lbregy/Power-Electronics/02 - Transformer/Reports/EE_365_Report_2_2025_2026.pdf

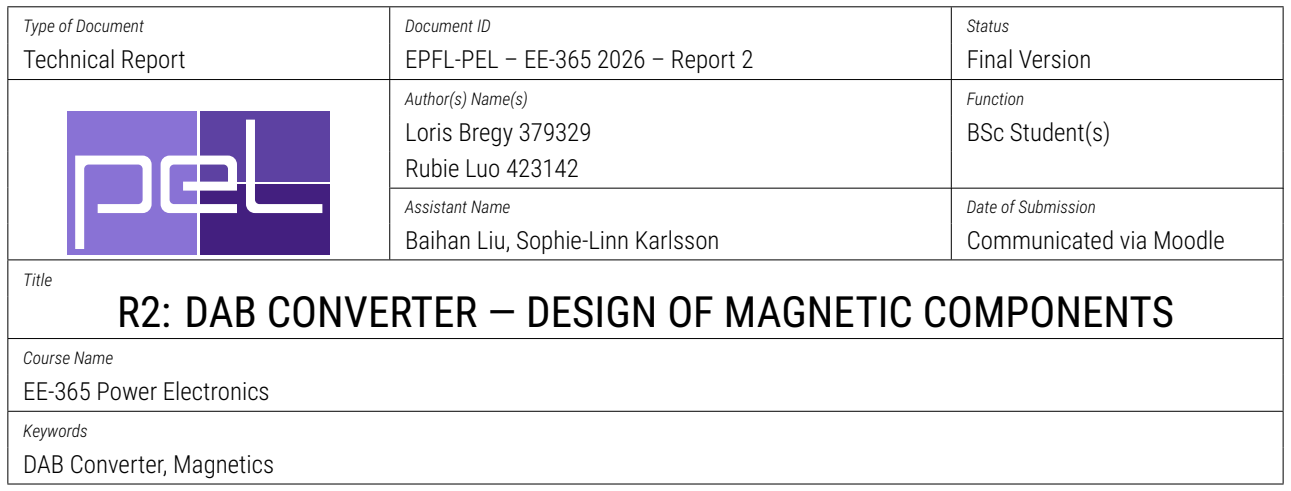
[picture p4: figure]
Title; Course Name EE-365 Power Electronics; Keywords DAB Converter, Magnetics

Type of Document Technical Report | Document ID EPFL-PEL – EE-365 2026 – Report 2 | Status Final Version
| Author(s) Name(s) Loris Bregy 379329 Rubie Luo 423142 | Function BSc Student(s)
| Assistant Name Baihan Liu, Sophie-Linn Karlsson | Date of Submission Communicated via Moodle

# R2: DAB CONVERTER — DESIGN OF MAGNETIC COMPONENTS

## TABLE OF CONTENTS

Transformer – Design Specifications and Constraints | 3
Transformer – Core Selection with Kg Method | 7
Transformer – Wire Selection | 10
Transformer – Evaluation of Losses | 13
Transformer – Design Summary | 15

Transformer – Building Procedure | 16
Transformer – Prototype Measurement | 18
Inductor Design | 21

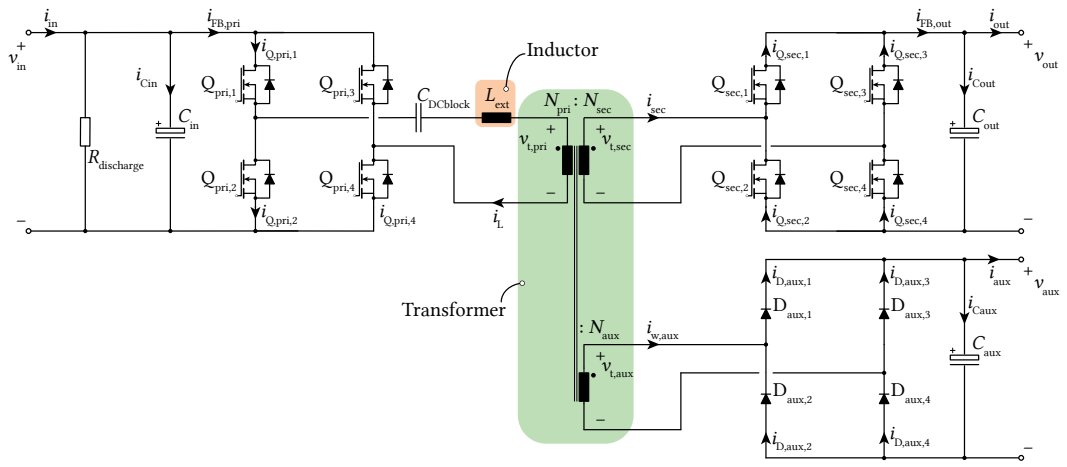
[picture p5: figure]
Qpri,1; Qpri,2; Qpri,3; Qpri,4; Cin; Rdischarge; Lext; i Q,pri,1; Q,pri,2; Q,pri,4; Qsec,1; Qsec,2; Qsec,3; Qsec,4; Q,sec,1; Q,sec,3; Q,sec,2; Q,sec,4; sec; Cout; i out; CDCblock; + vin; + vout; + vt,sec; + vt,pri; + vt,aux; Caux; + vaux; Npri : Nsec; : Naux; Daux,1; Daux,2; Daux,3; Daux,4; D,aux,1; D,aux,3; D,aux,2; D,aux,4; Cout i Cin; i w,aux; i aux; i Caux; FB,pri; FB,out; Transformer; Inductor

Figure 1 Schematics of the DAB converter for this report, highlighting the separation of the transformer and the inductor that will be designed separately in this report. Compared to Report 1, a winding of Naux is also added to power the auxiliary circuits at the secondary side. More details about these aspects will come in the next reports.

## TRANSFORMER – DESIGN SPECIFICATIONS AND CONSTRAINTS

The second part of the project deals with the design and realization of the magnetic components (i.e., the transformer and the inductor) of the DAB converter, according to the specifications and requirements from Report 1. The schematic to be considered for this report is shown in Figure 1. Fill out Table 1 with the parameters assigned to your group and calculated in the previous Report.

One of the most important choices for the design of inductors and transformers is the selection of the material for the magnetic core. For all the groups in this class, the operating frequency of the converter are above 10 kHz. For such frequencies, materials known as ferrites are typically employed, while other materials are available for lower operating frequencies. Here, only the N87 ferrite material from TDK (datasheet pdf) (https://www.tdk-electronics.tdk.com/download/528882/990c299b916e9f3eb7e44ad563b7f0b9/pdf-n87.pdf) is considered.

Another important guideline to follow for this project is that the design of the transformer and the inductor are to be pursued separately. In other words, the transformer is designed to have maximum coupling (i.e., with the lowest leakage and highest magnetizing inductance possible), while the inductor is designed to obtain the desired inductance L as calculated in Report 1. The transformer will be discussed first. In addition to what has been discussed in Report 1, the transformer will have to include an additional winding to power the secondary-side auxiliary circuitry. The auxiliary winding will be then connected in the next Report to a diode rectifier to generate a DC voltage Vaux,out (reported in Table 1 together with the power requirement Paux,out).

To successfully complete the second part of the project, it is essential to go through the corresponding lecture slides before starting to work on the report. To provide your answers and explanations, use the framed boxes below each question. For the questions where no box for explanations is provided, it is sufficient to write only the solution to the question without providing any additional reasoning steps. The design processes in this part of the project are iterative. You will (most likely) need to go back and rethink your previous decisions whenever you find out that some constraints are broken or yield operating conditions that are unfeasible or undesirable. You are asked not to report every iteration nor to provide a written account of all the iterations. Report only your final design choices taking care of checking that they comply with all the constraints given in the previous and following steps. Regarding the results of analytical calculations, please provide them with two digits after the decimal point in the unit provided in the solution box. Use the framed boxes below each question to insert your answers and explanations. Keep them concise and use the symbols indicated in Figure 1 (if a symbol is not present, define it).

Table 1 Given parameters and design requirements for the DAB converter.
Property | Value | Unit
Pout,nom | 50 | W
Vin,nom | 50 | V
Vin,min | 30 | V
Vin,max | 60 | V
Vout | 12 | V
∆Vout,pp,rel | 2 | %
fsw | 80 | kHz
Vaux,out | 18 | V
Paux,out | 5 | W

### Q1: CALCULATION OF VOLT-SECOND STRESS

Volt-second stress (also known as peak flux-linkage) is the peak-to-peak value of the integral of the voltage applied to the transformer over a positive half cycle. This value is independent of the transformer design. You can consider constant input and output voltages during the positive half cycle. Evaluate the volt-second stress at the primary side under the worst-case condition (i.e., the highest value).

Please write your answer inside the frame. Keep your text explanations concise and on point. In calculations include input data and do not forget units when you substitute symbols for values.
Delete this before writing anything.
λ1 = | Wb | / 2 pt.

### Q2: ESTIMATION OF LOSS COEFFICIENT

The Kg method used in this project requires the calculation of the core loss coefficient Kfe. The manufacturer of the core material (namely, TDK) provides the data reported in Table 2 that gives us a first estimate of the volumetric loss at 80 °C as

pvol = Kb

⋅ (
f

## fbase )

α

⋅ (
Bpk

Bbase )
β
(1)

where f is the operating frequency, Bpk is the peak operating magnetic flux, fbase is the base frequency, Bbase is the base peak magnetic flux, and α and β are the Steinmetz parameters.
Calculate the Kfe coefficient using the row of Table 2 with the nearest base frequency to your operating frequency.
Note: This relation assumes sinusoidal excitation on a toroidal core, but it is a reasonable estimation for your project.

Table 2 Core loss data from the manufacturer of material N87.
fbase (kHz) α ( ) | | β ( ) | Kb (kW/m ) Bbase (mT) 3
25 kHz | 1.44 | 2.93 | 67.48 | 200
50 kHz | 1.72 | 2.66 | 23.51 | 100
100 kHz | 1.72 | 2.68 | 61.15 | 100
200 kHz | 1.839 | 2.57 | 30 | 50

Please write your answer inside the frame. Keep your text explanations concise and on point. In calculations include input data and do not forget units when you substitute symbols for values.
Delete this before writing anything.
Kfe = | W/(T
β

cm³

) | / 1 pt.

### Q3: TOTAL CURRENT STRESS

Assuming a worst-case RMS current Iw,aux,RMS = 0.8 A in the auxiliary winding, calculate the total RMS current stress Itot in the transformer (see the slides).

Itot = | A | / 1 pt.

### Q4: WINDOW UTILIZATION FACTOR

Besides the conductors in the windings, the core window area is also occupied by non-conductive materials. Make an estimation of the window utilization factor Ku

, also known as fill factor, to have a starting point for your design. Be aware that this is only a first reference for yourself, and that once the core sample is wound, you will be able to improve this estimate for the next design iteration.

Ku = | / 1 pt.

### Q5: ESTIMATION OF LOSS BUDGET

Set a reasonable target efficiency for your design and calculate your allowed losses Ptot considering the nominal output power. Be aware that this is only a first estimate, and you will be able to improve it in the next iterations.

Please write your answer inside the frame. Keep your text explanations concise and on point. In calculations include input data and do not forget units when you substitute symbols for values.
Delete this before writing anything.
Ptot = | W | / 2 pt.

## TRANSFORMER – CORE SELECTION WITH KG METHOD

As suggested in the slides, one of the most commonly used methods to design a transformer is the Kg

-method modified for AC applic-ations to take into account both core and copper losses and to minimize them. This method is usually referred to as the Kgfe method. More details can be found in the slides or in the book Fundamentals of Power Electronics by Erickson and Maksimovic, Springer.

Magnetic core manufacturers provide a vast variety of core shapes and sizes (examples are shown in Figure 2). In this course, a preselection of suitable cores is given in Table 3. The geometrical Kgfe factor for each of the available cores is also calculated, considering the geometrical dimensions given in the datasheets and β = 2.7 (average value for ferrites). You are requested to choose one of the available cores in Table 3 for your design.

Table 3 Available core materials and core shapes.
Core shape | N87 core | Coil former | Yoke Clamp | Kgfe [cm5

]

E20/10/6 | B66311G0000X187 B66206B1110T001 B66206A2010X000 | 0.0019
E25/13/7 | B66317G0000X187 B66208X1010T001 B66208A2010X000 | 0.0044
E30/15/7 | B66319G0000X187 B66232B1114T001 B66232A2010X000 | 0.0049
E32/16/9 | B66229G0000X187 B66230A1114T001 B66230A2010X000 | 0.0090
ETD34/17/11 B66361G0000X187 B66362X1014T001 B66362A2000X000 | 0.0120
ETD39/20/13 B66363G0000X187 B66364B1016T001 B66364A2000X000 | 0.0197
ETD44/22/15 B66365G0000X187 B66366B1018T001 B66366A2000X000 | 0.0290

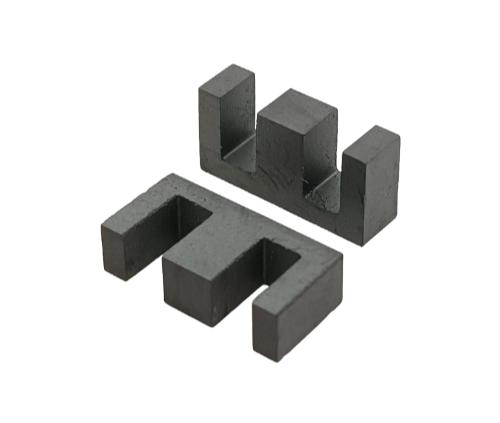
[picture p6: figure]
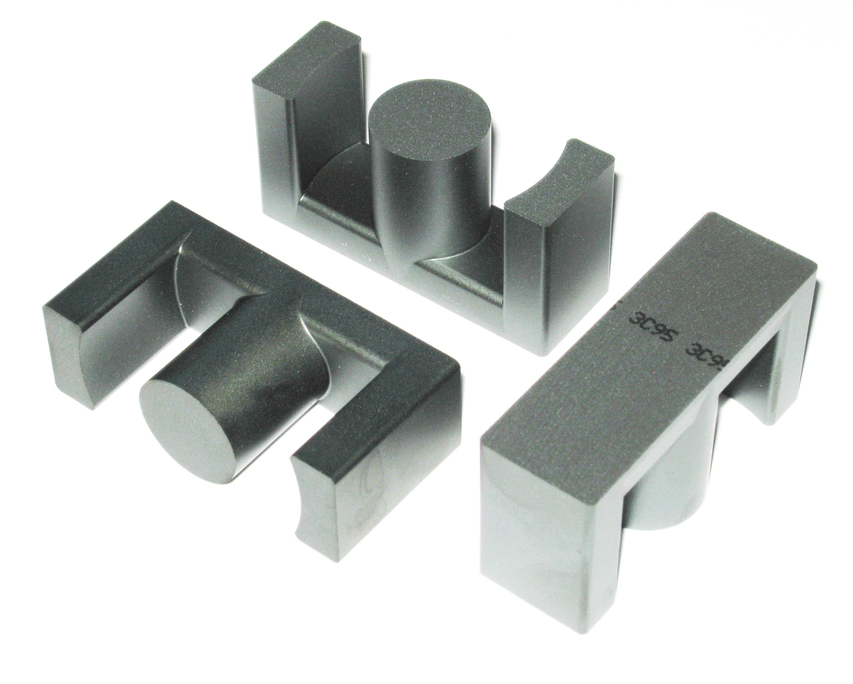
[picture p7: figure]

(a) ETD shape, | (b) EE shape.
Figure 2 Exemplary core shapes.

### Q6: MAXIMUM VALUE OF PEAK FLUX DENSITY

To avoid core saturation, the maximum peak flux density Bpk,max must be constrained to a value much lower than the saturation value of flux density for the selected core material (here, N87) at any time during operation. The selection of this value is a trade-off between the use of the core (i.e., volume) and core losses. The magnetization curves of the available core material N87 are in this datasheet. (https://www.tdk-electronics.tdk.com/download/528882/990c299b916e9f3eb7e44ad563b7f0b9/pdf-n87.pdf) To serve as a constraint in the following steps, select the maximum value of the peak flux density Bpk,max.

Bpk,max = | T | / 1 pt.

### Q7: MINIMUM KGFE

Copper resistivity can be considered constant at ρ = 1.724 ⋅ 10⁻⁶
| | Ω cm. Considering again β = 2.7, calculate the minimum required
Kg

-factor Kgfe,min for your specific conditions.
Note: while performing the calculations, be very careful to use the correct units.

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

Kgfe,min = cm5 / 3 pt.

### Q8: SELECTION OF THE CORE

Indicate which core shape from Table 3 you want to use for your design, considering the calculated minimum Kgfe. As a first attempt, you can choose whatever core has a Kgfe bigger than the needed one. Bigger cores will reduce the power density of your converter, which is undesirable. Be aware that your core size also influences the current density and the losses, which will be analyzed in the following questions. Likely, you will need to iterate on your answer to meet all the constraints.

Core shape: | / 3 pt.

### Q9: VERIFICATION OF THE PEAK FLUX DENSITY

Using the formula presented in the slides, check that the expected ∆B (peak ac flux density, peak-to-average) in your operating conditions is not exceeding the Bpk,max selected in Q6. This will ensure that saturation never occurs in nominal conditions. Information on the geometrical dimensions of the selected cores can be found in the provided files.

Please write your answer inside the frame. Keep your text explanations concise and on point. In calculations include input data and do not forget units when you substitute symbols for values.
Delete this before writing anything.
∆B: | T | / 2 pt.

### Q10: REQUIRED NUMBER OF TURNS

Calculate the required turn ratio of the main and auxiliary windings and report it below. Then, using the formula presented in the slides, calculate the desired number of turns on the primary side to minimize total losses. Moreover, considering the transformer ratio required for your design, calculate the number of turns needed for the secondary and auxiliary windings. Make sure that each winding is composed of an integer number of turns. Then, calculate the actual resulting turn ratios and report them below, also checking that this rounding does not make the turn ratio deviate significantly (anyhow, you will be asked to check this again later with a more detailed procedure).
Note: while performing the calculations, be careful to use the correct units.

Please write your answer inside the frame. Keep your text explanations concise and on point. In calculations include input data and do not forget units when you substitute symbols for values.
Delete this before writing anything.
Calculated n = | | Calculated naux =
Npri = | Nsec = | Naux = | / 3 pt.
Actual n = | Actual naux =

### Q11: MAGNETIZING INDUCTANCE

The magnetizing inductance of the transformer (referred to the primary side) must be sufficiently high to avoid influencing the ideal DAB operation. Calculate the minimum magnetizing inductance Lm,MIN to be 10 times higher than your DAB inductor L. Then, compute the expected value of the magnetizing inductance Lm. To do this, you can use the inverse of the formula for computing the number of turns. If Lm is smaller than Lm,MIN, you need to reconsider your choices and go back to the previous steps.

Please write your answer inside the frame. Keep your text explanations concise and on point. In calculations include input data and do not forget units when you substitute symbols for values.
Delete this before writing anything.
Lm,MIN = | mH | Lm = | mH | / 2 pt.

### Q12: CHECK TURN RATIO FOR OUTPUT PORT

In Report 1, you were asked to plot the output power capability of the DAB as a function of the input voltage, considering the ideal turn ratio. The turn ratio that you obtained in the previous questions might deviate from the ideal one, since only integer numbers of turns can be realized. Therefore, you are tasked with plotting the output power capability (as in Report 1, in the answer box) considering the turn ratio that you intend to realize (Q10); provide also the minimum power transfer Preal,min in the worst-case condition. To ensure that the converter has sufficient regulation capability, make sure that the realized turn ratio does not decrease the margin you took from Report 1 by more than 5 W.

Please write your answer inside the frame. Keep your text explanations concise and on point. In calculations include input data and do not forget units when you substitute symbols for values.
Delete this before writing anything.
Preal,min = | W | / 3 pt.

### Q13: CHECK TURN RATIO FOR AUXILIARY PORT

Considering the turn ratio that you intend to realize (Q10), calculate the voltage Vaux,true of the auxiliary port. Now, compare this with the nominal value Vaux,out and make sure the difference is below 15 %. If not, you need to reconsider your choices and improve the turn ratio.
Note: you can consider the nominal output voltage and ignore any non-ideality of the components of the converter (e.g., the voltage drop on the rectifier diodes).

Please write your answer inside the frame. Keep your text explanations concise and on point. In calculations include input data and do not forget units when you substitute symbols for values.
Delete this before writing anything.
Vaux,real = | V | / 1 pt.

## TRANSFORMER – WIRE SELECTION

The following step in the transformer design is to select a suitable wire. Different aspects need to be considered in this choice. Increasing the wire cross section would reduce the resistance but, at the same time, requires a higher utilization factor (for the winding area) or a larger core. In addition, the high-frequency operation leads to a significant impact of the skin effect on the effective AC resistance. In the following tables, you will find a list of the available wires. You might consider to slightly revise the target fill factor (Q4) depending on your wire choice.

Table 4 Available magnet wires.

Wire number | M1 M2 M3 M4 M5 M6 M7
Conductor diameter (mm) 0.65 0.9 1.0 1.2 1.54 1.6 1.8

Table 5 Available Litz wires (the diameter of a single conductor is 0.2 mm).

Wire number | L1 | L2 | L3 | L4
Number of strands | 25 | 35 | 45 | 80
Total Conductive Area (mm²
) 0.78 1.10 1.41 2.51
External Diameter (mm) 1.53 1.8 2.06 2.8

### Q14: SKIN DEPTH

To develop a sense of the specific weight of the skin effect on your design, evaluate the skin depth in millimeters.

Please write your answer inside the frame. Keep your text explanations concise and on point. In calculations include input data and do not forget units when you substitute symbols for values.
Delete this before writing anything.
δ = | mm | / 2 pt.

### Q15: ALLOCATION OF THE WINDING WINDOW

Taking into account the RMS current expected in each winding, the number of turns, and the total current calculated in the first section, calculate the fraction αw of the winding area that should be allocated to each of your windings.

Please write your answer inside the frame. Keep your text explanations concise and on point. In calculations include input data and do not forget units when you substitute symbols for values.
Delete this before writing anything.
αw,pri = | | αw,sec = | αw,aux = | / 2 pt.

### Q16: WINDING AREA AND MEAN LENGTH OF TURNS

Considering the selected core, report the available winding area and the mean length of turns (MLT).
Note: to verify that you picked the correct data, you can calculate Kgfe and compare it to the one in Table 3.
Aw = | cm² | MLT = | cm | / 2 pt.

### Q17: MAXIMUM WIRE CROSS-SECTION

Considering the dimensions of the selected core and the allocated fraction for each wire winding, calculate the maximum wire cross-section that would fit in the available space.

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

Aw,pri,max = cm²

Aw,sec,max = cm²

Aw,aux,max = cm²
/ 2 pt.

### Q18: TARGET CURRENT DENSITY

Densely packed multi-layer windings cannot dissipate heat as effectively as wires in free-air. In fact, there is a trade-off between copper losses, temperature rise, and power density. Considering the typical values provided in the slides, select a current density constraint as a starting point for your design. In the following steps of the design or prototyping process, you might adjust this constraint and re-iterate your design to change your design point with respect to the above-mentioned trade-off. Note that, due to discrete wire gauges, it will not be possible to exactly match the selected value.

J

∗

w = | A/cm2
/ 1 pt.

### Q19: REQUIRED CONDUCTOR AREA

Considering the target current density defined in Q18 and the RMS current expected in your windings according to the simulations performed in Report 1, evaluate the total conductive areas ATC needed to satisfy your requirements. Compare this area with the maximum available in the core you selected (see the answer from previous question). If the available area is smaller than the needed one, go back and select a bigger core (Q8). Be aware that the core selection will also be influenced by the answers to the next questions. Note that if the needed area is only slightly bigger than the maximum available one, you can choose to proceed with your selected core; however, if the area is barely sufficient, the utilization factor that you will calculate in a following question (Q21) could determine that your design is not feasible.

Please write your answer inside the frame. Keep your text explanations concise and on point. In calculations include input data and do not forget units when you substitute symbols for values.
Delete this before writing anything.
ATC,pri = | cm2
ATC,sec = | cm2
ATC,aux = | cm2
/ 3 pt.

### Q20: WIRE SELECTION

Select the wires for your windings from the available wires in Table 4 and Table 5. In the answer box, indicate the wire of your choice with the label given in the tables and provide the current density you expect with that wire.

Notes:
- For Magnet Wires (Table 4), you can neglect the thickness of the isolation layer, i.e., you can assume that the diameter of the wire is the diameter of the conductor.
- For litz Wires (Table 5), the total conductive area is given in the Table.
- Your technology choice (magnet wire or litz wire) will affect your losses and the size of your transformer; you may want to reconsider your choice after calculating AC losses in a following question (Q23).
- Once again, consider the target current density from Q18 and the expected RMS current from Report 1, and use the expected total conductor area as a guideline.

- Due to the limited number of wires available, you may not be able to obtain exactly your target current density; choose a reasonably-close value considering the wire technology of your choice.
- Check that the area needed for your selected winding is smaller than the maximum available one; otherwise, reconsider your core choice (Q8).
- If you cannot satisfy the requirements with the available wires, you are allowed to parallel the windings. Only in this case, write the number of parallels and a letter x before the wire reference in the answer box. For example, ”2xM7” means two wires of type M7 in parallel.

Please write your answer inside the frame. Keep your text explanations concise and on point. In calculations include input data and do not forget units when you substitute symbols for values.
Delete this before writing anything.
Selected wire 1: | Jw,pri,selected = | A/cm²
Selected wire 2: | Jw,sec,selected = | A/cm²
Selected wire aux: | Jw,aux,selected = | A/cm²
/ 4 pt.

### Q21: WINDOW UTILIZATION FACTOR

Considering the core and wires you selected, calculate the current window utilization factor Ku,real to verify whether the core window area is overly packed before proceeding to the actual realization of the transformer. Compare it with your initial estimate in Q4.

Please write your answer inside the frame. Keep your text explanations concise and on point. In calculations include input data and do not forget units when you substitute symbols for values.
Delete this before writing anything.
Ku,real = | / 2 pt.

## TRANSFORMER – EVALUATION OF LOSSES

### Q22: DC WINDING RESISTANCE

Give a reasonable expected temperature Tw for your windings. Calculate the DC winding resistances RDC of the designed windings using the MLT (extracted from the datasheet), Aw (from selected wires, using the total conductive area), the resistivity of copper (ρ = 1.724 ⋅ 10⁻⁶

Ω cm), and the temperature coefficient for copper αT = 0.003862K⁻¹ .

Please write your answer inside the frame. Keep your text explanations concise and on point. In calculations include input data and do not forget units when you substitute symbols for values.
Delete this before writing anything.
Tw = | °C | RDC,pri = | Ω | RDC,sec = | Ω | RDC,aux = | Ω | / 3 pt.

### Q23: AC WINDING RESISTANCE

Calculate the AC winding resistance RAC considering only the skin effect (i.e., neglecting proximity effects and other phenomena). If your skin depth is lower than the diameter of your wire, the ratio between AC and DC resistance—known as FR factor—can be approximated as

FR ≈

dw
4δ

(2)

(this formula can be found in the book ”High frequency magnetic components” by M. K. Kazimierczuk, page 190 for the second edition). If this condition is not met, then you can reasonably assume a uniform current density (again, neglecting proximity effects). Note: in the case of a litz wire, you can consider the diameter of the strand.

Please write your answer inside the frame. Keep your text explanations concise and on point. In calculations include input data and do not forget units when you substitute symbols for values.
Delete this before writing anything.
RAC,pri = | Ω | RAC,sec = | Ω | RAC,aux = | Ω | / 4 pt.

### Q24: DC AND AC COPPER LOSSES

Calculate the total DC copper losses PCu,DC and AC copper losses PCu,AC arising due to Joule effect in the windings. Perform the calculation considering the nominal power at both the minimum and maximum input voltage. Calculate the percentage of AC copper losses relative to the nominal output power. This gives you the expected efficiency drop due to the winding losses.

Please write your answer inside the frame. Keep your text explanations concise and on point. In calculations include input data and do not forget units when you substitute symbols for values.
Delete this before writing anything.
With minimum input voltage: | PCu,DC = | W | and | PCu,AC = | W , which corresponds to | % of the output power.
With maximum input voltage: | PCu,DC = | W | and | PCu,AC = | W , which corresponds to | % of the output power.

/ 3 pt.

### Q25: ESTIMATION OF CORE LOSSES AND CORE TEMPERATURE

Using the plot of the loss density provided in the core material’s data sheet (N87), (https://www.tdk-electronics.tdk.com/download/528882/990c299b916e9f3eb7e44ad563b7f0b9/pdf-n87.pdf) estimate the core losses Pcore of the designed transformer. The core volume can be found in the datasheet of the core shape you selected. Then, calculate the core losses as a percentage of the nominal output power. In addition, estimate the temperature rise of your transformer’s core, considering an ambient temperature of 40 °C. You can find values for the thermal resistance Rth and the temperature rise limit of different materials in the provided documents. Make sure that the temperature rise ∆T above ambient is reasonable and, more importantly, compatible with the material; if this is not the case, review your core and wire selection.

Please write your answer inside the frame. Keep your text explanations concise and on point. In calculations include input data and do not forget units when you substitute symbols for values.
Delete this before writing anything.
Pcore = | W | which corresponds to | % of the output power.
∆T = | K | / 3 pt.

### Q26: OVERALL LOSSES

For the worst-case operating condition, calculate the total losses (copper and core) expected in your transformer and compare them with the loss budget you defined in Q5.

Please write your answer inside the frame. Keep your text explanations concise and on point. In calculations include input data and do not forget units when you substitute symbols for values.
Delete this before writing anything.
Ploss = | W | / 3 pt.

## TRANSFORMER – DESIGN SUMMARY

### Q27: DAB TRANSFORMER DESIGN

Fill Table 6 with your design results. Do not forget to include the appropriate units.

Table 6 Design summary of the transformer
Electrical Specifications
Primary current | Iw,pri,RMS
Secondary current | Iw,sec,RMS
Auxiliary current | Iw,aux,RMS
Magnetizing inductance | Lm
Core specifications
Core shape | -
Coil former | -
Core material | -
Max flux density | ∆B
Winding Specifications
Primary wire diameter | ∅
Number of turns for primary | Npri
Secondary wire diameter | ∅
Number of turns for secondary wire | Nsec
Auxiliary wire diameter | ∅
Number of turns for auxiliary wire | Naux
Losses and temperature rise (worst-case)
Core losses | Pcore
Winding losses | PCu,AC
Total transformer losses | Ploss/Pout | %
Expected Temperature rise | ∆T | K

/ 1 pt.

### Q28: OVERALL EFFICIENCY OF THE CONVERTER

Taking into account the results of the Loss Tool of Report 1, estimate the best-case and worst-case efficiency of your DAB converter for the nominal output power considering the transformer losses estimated theoretically in the previous questions.

Please write your answer inside the frame. Keep your text explanations concise and on point. In calculations include input data and do not forget units when you substitute symbols for values.
Delete this before writing anything.
ηDAB,best = | % | ηDAB,worst = | % | / 3 pt.

## TRANSFORMER – BUILDING PROCEDURE

### Q29: WIRING OF THE TRANSFORMER

Based on the theoretical calculations done above, choose:
- 1x Coil former ! Careful: Pins are easy to bend and break! The main structure is made of plastic, don’t push clamps too hard!
- 2x Core halves ! Careful: Very fragile! Do not drop or scratch!
- 2x Yokes
Then, follow these steps:
- Proceed with these items to the assembly station, and prepare the coil former.
- Carefully consider the following notes before proceeding:
– Since an inductor will be added in series later on to obtain the desired inductance value for the DAB, the transformer should have the smallest leakage inductance, which is determined by the relative position (and geometry) of the windings. Closer windings will have lower leakage inductance.
– Therefore, the windings can be interleaved to mitigate the proximity effects, i.e., reducing the winding losses. This is suggested to avoid significant overheating of the transformer (remember that proximity effects have been neglected in the previous calculations, so the temperature increase will be higher than predicted).
– While the insulating varnish of the windings is sufficient for the operating voltage of the converter, you can consider adding some layers of kapton tape; this will ensure that the isolation is guaranteed even if you accidentally scratch the isolating varnish, but your transformer will run much hotter because the tape will hinder the heat exchange.
- Plan the length, the direction, and the layers of the windings before starting to wind. Consider that interleaving means wiring all three windings at the same time. Leave some margin at the end of each side of the windings to make the following steps easier. Mark the beginning and end of each of your windings to help you connecting them appropriately.
- Wind the appropriate number of turns for your primary and your two secondaries using the selected wire.
- Insert a single core half into the coil former, making sure not to scratch the insulating layer of the wires.
- Insert the second core half into the other side of the coil former, making sure not to scratch the insulating layer of the wires.
- Use the yokes to hold the transformer together. It might be required to use a bit of force; use the provided tools and be careful not to break the cores.
When the assembly is completed, add a picture of the fully assembled transformer in the answer box.

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

/ 2 pt.

### Q30: VERIFYING THE WIRING DIRECTIONS

Using the LCR meter as a supply connected to the terminals of the primary winding, verify the winding direction of the secondary windings by following the steps below:
- Remove the insulation layer from the wire ends. If you are using bare wire, you need to scratch the varnish with sandpaper or scissors’ blades. If you are using Litz wires, you need to terminate them using a soldering bath (keep the wire inside the bath for 5 to 20 seconds according to the size of your wire).
- Set the frequency on the LCR meter to 10 kHz;
- Mark the terminal of the primary winding connected to the high potential of the LCR;
- Measure the voltage across the secondary winding;
- If the voltage is in phase with the primary voltage, mark it as the positive terminal; otherwise, mark it as the negative terminal.
- Repeat the procedure in the previous two points for the auxiliary winding.
Provide a picture of the transformer with the markings on the windings.

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

/ 2 pt.

### Q31: SOLDERING

Solder the windings to the respective pins of the coil former and provide a picture of the final soldered transformer.
Note: Make sure to solder the winding terminals to the intended pins (a suggestion is provided in Figure 3).
Note: You need to remove the insulation layer from the wire ends before soldering. If you are using bare wire, you need to scratch the varnish with sandpaper or scissors’ blades. If you are using Litz wires, you need to terminate them using a soldering bath (keep the wire inside the bath for 5 to 20 seconds according to the size of your wire).
Be aware that the wire can get very hot. Do not burn your fingers!!!

Add a picture in the answer box after completing the soldering process.

Secondary +

Secondary −

Auxiliary +
Auxiliary −

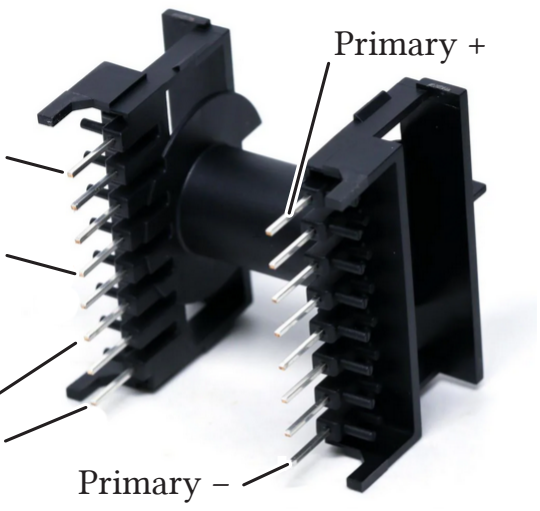
[picture p8: figure]
Primary +; Primary −
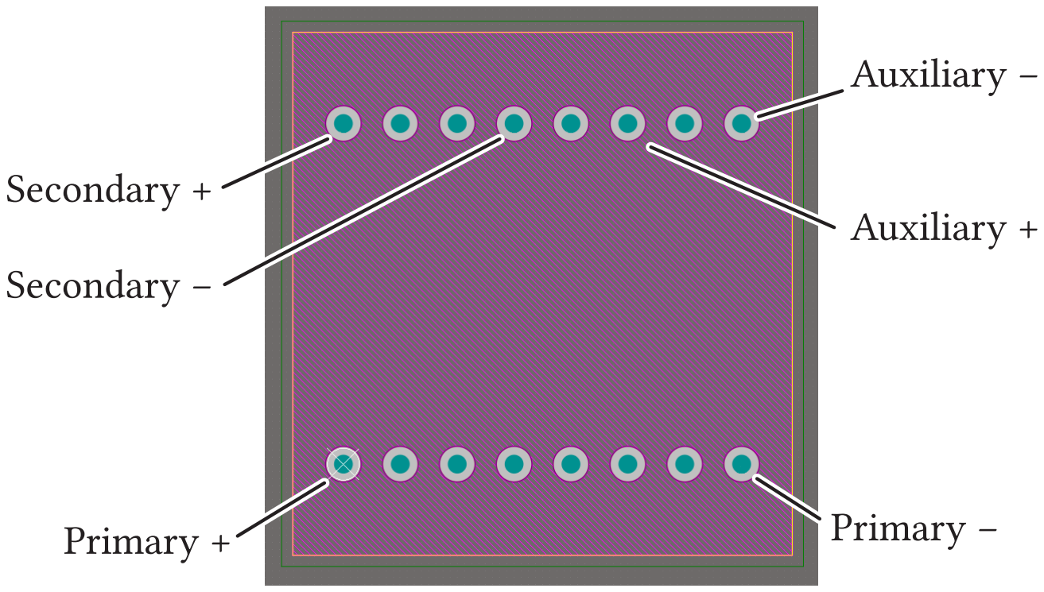
[picture p9: figure]
Primary +; Primary −; Secondary +; Secondary −; Auxiliary +; Auxiliary −

Figure 3 Suggested exemplary connection of the windings on the coil former (on the left) and the corresponding PCB footprint (on the right). This is only an example and, therefore, your coil former might be different.

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

/ 2 pt.

## TRANSFORMER – PROTOTYPE MEASUREMENT

### Q32: OPEN-CIRCUIT TEST WITH LCR METER

To estimate the magnetizing inductance, perform an open-circuit test using the LCR Meter. Keep both secondary windings open and measure the inductance on the primary winding (using Ls mode). Show a picture of your measurement setup in the answer box and report the inductance value with the appropriate unit.

Please write your answer inside the frame. Keep your text explanations concise and on point. In calculations include input data and do not forget units when you substitute symbols for values.
Delete this before writing anything.
Lm = | at | f = | kHz | / 2 pt.

### Q33: SHORT-CIRCUIT TEST WITH LCR METER

To estimate your leakage inductance and the total winding resistance, perform a short-circuit test using the LCR Meter. Short circuit both secondary windings using wires or clips, and measure the inductance and resistance (Ls-Rs mode) on the primary winding. Show a picture of your measurement setup in the answer box. Compare the inductance value with your desired DAB inductance to ensure that your leakage inductance is smaller. If the constraint is not fulfilled, rewind your transformer by keeping the windings closer to each other. Then, compare the measured resistance with the one you estimated in Q25. Note: The value you measure is the combined effect of your primary-side winding resistance and all the other winding resistances reflected at the primary side.

Please write your answer inside the frame. Keep your text explanations concise and on point. In calculations include input data and do not forget units when you substitute symbols for values.
Delete this before writing anything.
Lleak,tot,pri = | µH | Rs,tot,pri = | Ω | at | f = | kHz | / 3 pt.

### Q34: OPEN-CIRCUIT TEST WITH A FREQUENCY RESPONSE ANALYZER

Validate the measurements in the previous open-circuit test by using the provided frequency response analyzer (Omicron Bode 100). Keep both secondary windings open and measure the inductance (Impedance Analysis/One-Port/Ls) on the primary winding. Provide a screenshot showing the measured inductance for a frequency range from 100 Hz to 1 MHz.

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

/ 3 pt.

### Q35: SHORT-CIRCUIT TEST WITH FREQUENCY RESPONSE ANALYZER

Validate the measurements in the previous short-circuit test by using the provided frequency response analyzer (Omicron Bode 100). Short Circuit both secondary windings and measure the inductance and resistance (Impedance Analysis/One-Port/Ls+Rs) on the primary winding. Provide a screenshot showing both the measured inductance and the measured resistance for a frequency range from 100 Hz to 1 MHz. Note the effect of frequency on your resistance.

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

/ 3 pt.

### Q36: SATURATION MEASUREMENT

Using the power choke meter (DPG10-1000B), execute the saturation test and provide the results below. Follow these steps:
- Keep the secondary windings open.
- Connect both the Force and Sense cables to the power choke meter and to the terminals of the primary.
- Once connected, cover with the provided Plexiglas box.
- DO NOT TOUCH IT until the end of the measuring process. You could get seriously injured!
- In the control software:
– Set the maximum voltage to 60 V;
– Set the maximum pulse duration to 200 µs (increase it if necessary);
– Set the maximum current to the maximum magnetizing current rounded up to the nearest integer.
- Start the measurement.
Verify that your core is not saturating, write the maximum value of the magnetizing current Im,peak below, and provide the curves of both the incremental and the secant inductance in the answer box, along with a picture of the measuring setup. In addition, provide a concise reason for why you believe the core is not saturating.

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

Im,peak = A
/ 4 pt.

### Q37: MAGNETIZING CURRENT AND VOLTAGE RATIO CHECK

Using the provided hardware setup and assisted by a TA, you will excite your transformer at the operating frequency and maximum output voltage. Report the oscilloscope acquisition of primary voltage, secondary voltages, and magnetizing current in the box below, along with a photo of the test setup. Check that the voltage ratios from the primary to the secondaries are correct. Note: keep the test as short as possible.

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

/ 4 pt.

### Q38: CORE HEAT-RUN TEST

You are tasked with performing a heat-run test using the setup used for the preceding question. The objective is to validate your design with respect to core losses. Follow these steps:

- Wait for the core to return to room temperature from your last test.
- Take a thermal photo of the core at room temperature.
- Start the excitation of the core and closely monitor the temperature closely for at least 10 minutes. Stop the test immediately if the temperature is too high and fix your design.
- After thermal steady-state is reached, take another thermal photo of the core.
Report the thermal images of the test in the box below.

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

/ 4 pt.

### Q39: CONDUCTION HEAT-RUN TEST

You are tasked with executing a heat-run test following these steps:
- Take a DC power supply, connect it to your primary windings, and set it up in current mode with the current limit set to your expected worst-case primary RMS current increased by at least 10% (to account for part of the inevitable frequency effects).
- Repeat the same procedure for the secondary windings. Make sure that the cables you use for the connection can withstand your secondary current and are well connected to the power supply; otherwise, the cables could overheat and burn (use at least 1 mm²

cross-section for 10 A; use at least 1.5 mm²
cross-section for 15 A). If any current limit exceeds 9 A, contact a TA.
- Repeat the same procedure for the auxiliary windings. In this case, you can avoid increasing the RMS value since the provided one for the design is already very conservative.
- Take an initial thermal image of the transformer.
- Activate the power supplies and keep monitoring your transformer closely.
Provide a picture of the test-setup as well as two thermal images: one prior to the test and one after 15 minutes. Indicate the maximum temperature in the answer boxes below, together with the value of the currents in the test.

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

T0=

◦
C T15min =

◦
C
Ipri,test = | A ( % margin) | Isec,test = | A ( % margin) | Iaux,test = | A ( % margin) | / 3 pt.

## INDUCTOR DESIGN

The aim of this last section is to design and build the external inductor to integrate the obtained leakage inductance and reach the desired value for your DAB. This process is also iterative; be aware that you might need to reconsider your choices. The questions in this section represent a (mostly) independent iterative loop with respect to the one of the transformer (it is only influenced by the measured leakage inductance). To wind your inductor, choose the same wire you used for the primary side of your transformer. The core shape is a toroidal core. This shapes leads to simpler design at the cost of a higher volume. Be aware that it may not be possible to realize exactly the value of your choice and that reasonable deviations are acceptable.

### Q40: EVALUATE THE EXTERNAL INDUCTANCE

Based on the measured leakage inductance (total, referred to the primary side), calculate the external inductance Lext you need to add in order to reach the desired inductance value L.

Please write your answer inside the frame. Keep your text explanations concise and on point. In calculations include input data and do not forget units when you substitute symbols for values.
Delete this before writing anything.
Lext = | µH | / 2 pt.

### Q41: DESIGN OF THE EXTERNAL INDUCTANCE

Choose one of the cores in the Table 7. Evaluate the integer number of turns needed to reach the value Ls as close as possible to the desired Lext. Note: Indicate ”2x” in your selected core if you need to use two cores in parallel.

Please write your answer inside the frame. Keep your text explanations concise and on point. In calculations include input data and do not forget units when you substitute symbols for values.
Delete this before writing anything.
Selected core = | NL,s = | Ls = | μH | / 4 pt.

Table 7 Available toroids for realizing the external inductor.

Ref. Part Number Material AL

# (nH/N

2

) μr | Hmax (A/m) Datasheet
A | T94-2 | 2 | 8.4 | 10 | 7150 | Link (https://www.rf-microwave.com/resources/products_attachments/6128f4a31a84b.pdf)
B | T130-2 | 2 | 8.4 | 10 | 7150 | Link (https://www.rf-microwave.com/resources/products_attachments/6128f4a31a84b.pdf)
C | T157-2 | 2 | 14 | 10 | 7150 | Link (https://datasheets.micrometals.com/T157-2-DataSheet.pdf)
D | T184-2 | 2 | 24 | 10 | 7150 | Link (https://datasheets.micrometals.com/T184-2-DataSheet.pdf)

### Q42: MAGNETIC FIELD AND FLUX DENSITY

Calculate the peak magnetic field HL,peak for the inductor. To avoid saturation, the magnetic field should be lower than the maximum one reported in Table 7.
Then, evaluate the magnetic flux value in your inductor considering your peak primary current and the number of turn you selected in Q43. To limit the losses, the flux should be lower than 30 mT.
If you cannot fulfill this requirement, try to use another available core. If even this last solution is not enough, you can parallel two cores. Be aware that you need back to the previous question and recalculate the number of turns.

Please write your answer inside the frame. Keep your text explanations concise and on point. In calculations include input data and do not forget units when you substitute symbols for values.
Delete this before writing anything.
HL,peak = | A/m | BL,peak = | mT | / 3 pt.

### Q43: WINDING AND MEASUREMENT OF THE INDUCTOR

Using the same wire you selected for the primary of the transformer, wind the calculated number of turns on the selected core. Terminate your wires using the same procedure as for your transformer. Then, using the LCR meter to evaluate Ls and Rs.
Note: The toroidal cores are also fragile. Handle them with caution!
Note: Distribute your turns uniformly around the core to obtain a result closer to the one calculated analytically. You can also adjust the position of your turns to tailor your inductor value to the desired one. Once you find the optimal position, fix the two winding ends to the core with a small amount of glue or tape (e.g., use a glue gun).
Show a picture of your inductor in the answer box.

Please write your answer inside the frame. Keep your text explanations concise and on point. In calculations include input data and do not forget units when you substitute symbols for values.
Delete this before writing anything.
Ls = | µH | and | Rs = | Ω | at | f = | kHz | / 5 pt.

### Q44: CHECK COPPER LOSSES IN THE INDUCTOR

Taking into account the primary-side RMS current and the Rs you just measured, evaluate the copper losses expected in your inductor and calculate them as a percentage of the nominal output power. This is the estimated efficiency drop due to the losses in your inductor.
Note: It is suggested not to allow more than 1 W for the smaller core and 2 W for the larger cores to avoid overheating. If this happens, change the wire to reduce the resistance (you are eventually allowed to parallel two wires if needed).

Please write your answer inside the frame. Keep your text explanations concise and on point. In calculations include input data and do not forget units when you substitute symbols for values.
Delete this before writing anything.
PCu,L = | W | which corresponds to | % | of output power | / 2 pt.

### Q45: SATURATION MEASUREMENT

Repeat the saturation test that you previously performed on the transformer. Using the power choke meter, provide the results following these steps:
- Keep the secondary windings open.
- Connect both the Force and Sense cables to the power choke meter and to the terminals of the primary.
- Once connected, cover with the provided Plexiglas box.
- DO NOT TOUCH IT until the end of the measuring process. You could get seriously injured!
- In the control software:

– Set the maximum voltage to 60 V;
– Set the maximum pulse duration to 200 µs (increase it later if necessary);
– Set the maximum current to at least twice the maximum input current rounded up to the nearest integer.
- Start the measurement.
Verify that your core is not saturating, and provide the curves of both the incremental and the secant inductance in the answer box, along with a picture of the measuring setup. In addition, provide a concise reason for why you believe the core is not saturating.

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

/ 4 pt.
