lbregy/Power-Electronics/02 - Transformer/Reports/Report1_Group4_Bregy_Luo.pdf

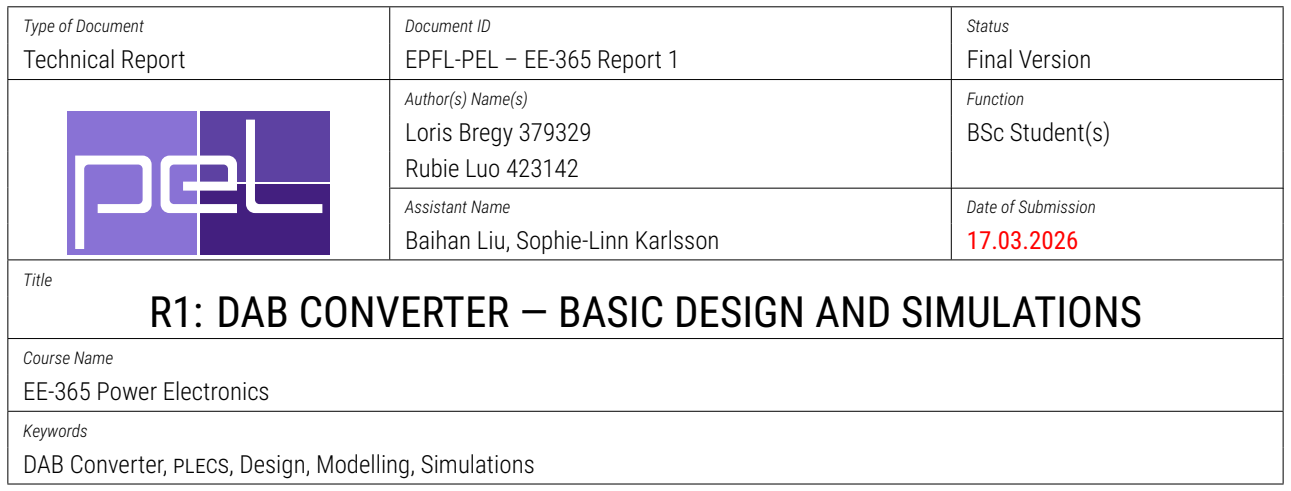
[picture p10: figure]
Title; Course Name EE-365 Power Electronics; Keywords

Type of Document Technical Report | Document ID EPFL-PEL – EE-365 Report 1 | Status Final Version
| Author(s) Name(s) Loris Bregy 379329 Rubie Luo 423142 | Function BSc Student(s)
| Assistant Name Baihan Liu, Sophie-Linn Karlsson | Date of Submission 17.03.2026

# R1: DAB CONVERTER — BASIC DESIGN AND SIMULATIONS

DAB Converter, PLECS, Design, Modelling, Simulations

## TABLE OF CONTENTS

DAB Converter Sizing | 2

Q12: PLECS validation for 1
4
Selection of Semiconductors | 16
Calculation of currents’ average and rms values | 19
Semiconductor Losses and Thermal Design | 23
Report 1 Summary | 30

## DAB CONVERTER SIZING

The first part of the project deals with the basic design calculations and sizing the main elements of a DC-DC DAB converter, according to the given converter specifications and design requirements. Fill out Table 1 with the parameters assigned to your group, and do not forget to add your names in the report’s header. Regarding the results of analytical calculations, please provide them rounded to two digits after the decimal point in the units provided in the solution box. Use the framed boxes below each question to insert your answers and explanations. Keep them concise.

Table 1 Design parameters and requirements for the DAB converter.
Property | Value | Unit
Pout,nom | 50 | W
Uin,nom | 50 | V
Uin,min | 30 | V
Uin,max | 60 | V
Uout | 12 | V
∆Uout,pp,rel | 2 | %
fsw | 80 | kHz

### Q1: TRANSFORMER TURN RATIO

The best value of the turn ratio of a transformer n is Vpri

Vsec
Design the transformer turns ratio to ensure that you can obtain the desired output voltage when working at Vin,nom.

Vpri represents Uin,nom (the input) while Vsec corresponds to Uout (the output). Thus the turn ratio is n = Vpri

Vsec

=

50V
12V

= 4.17.

n = 4.17 | / 2 pt.

### Q2: INDUCTOR L

NOTE: You may have to iterate between Q2 and Q3 in case of the L value doesn’t satisfy the converter requirements.

The power transfer relation of the DAB converter is given by Equation 1

P =

nVpriVsecφ(π − ∣φ∣)
2π

2
fswL
| (1)

where n is the transformer turn ratio, Vpri is the primary side voltage, Vsec is the secondary side voltage, φ is the phase shift in radians, fsw is the switching frequency, and L is the relevant DAB inductance.
Adding significant safety margin above the nominal power, the maximum power is designed to be three times the rated power. Please indicate at which φPmax the maximum power transfer occurs, and then calculate the corresponding inductance L for an operation at nominal input and output voltages.

For maximum power transfer, φ =
π
2
| . With the given nominal power output of 50W, the inductance should be calculated for 150W
for a safety factor of 3. First rearranging the equation for L:

L =

nVpriVsecφ(π − ∣φ∣)
2π

2
fswP
| (2)

=

4.17 ⋅ 50V ⋅ 12V ⋅
π
2

(π − ∣
π
2

∣)
2π

2
⋅ 80kHz ⋅ 150W
| (3)
= 2.60 ⋅ 10⁻⁵
| (4)

φPmax =
π
rad | L = 26.04μH | / 4 pt.

### Q3: VERIFY L WITH MINIMAL INPUT VOLTAGE

The DAB converter must be able to deliver nominal power for its entire range of operation, here, namely, for all input voltages.

Using Equation 1, draw a curve of the relationship between the input voltages and the maximum transferred power.

NOTE: The input voltage varies between 30 V and 60 V, resulting in different maximum powers.

Now, check the maximum output power curve. When the input voltage is at its minimum value, can the converter still output its rated power? If not, re-size the inductor L for higher transfer power, and derive a final value of L.

The maximum output power curve is seen in figure 1.

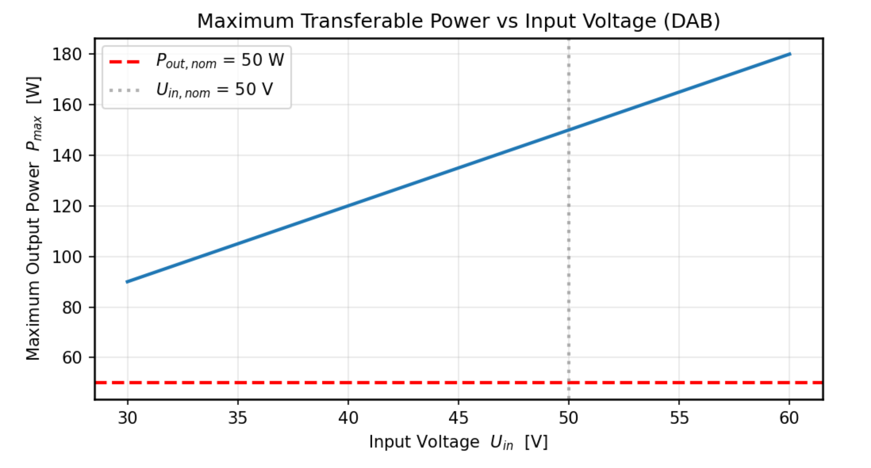
[picture p11: figure]

Figure 1 The relationship between the maximum power and the input voltage.

From the graph, at the minimum input voltage of 30V, the maximum output power is 90W which is well above the nominal 50W required.

L = 26.04μH | / 4 pt.

### Q4: RANGE OF THE PHASE SHIFT, Φ

Calculate the phase shift by Equation 1. When you have minimum, maximum, and nominal input voltages, what are the corresponding phase shifts φVmin, φVmax, and φVnom to achieve nominal power?

Equation 1 is rearranged to fit the form of a standard quadratic to solve for the phase shift.

L =

nVpriVsecφ(π − ∣φ∣)
2π

2
fswP

(5)

2π

2
fswPL
nVpriVsec

= (φπ − φ
2
) φ > 0 | (6)

In the equation, everything on the left is a constant based on the hardware specifications. The phase shift can be solved as one does for a quadratic.
Substituting values for minimum voltage:

2π

2

⋅ 80kHz ⋅ 50W ⋅ 2.60 ⋅ 10⁻⁵
H
4.17 ⋅ 30V ⋅ 12V

= (φπ − φ
2
) φ > 0 | (7)
φ = 0.52, 2.62 | (8)

The value of φ should be between 0 and π

since π

indicates the phase shift for maximum power and the power is symmetrical around π
2
Doing the same for maximum voltage:

2π

2

⋅ 80kHz ⋅ 50W ⋅ 2.60 ⋅ 10⁻⁵
H
4.17 ⋅ 60V ⋅ 12V

= (φπ − φ
2
) φ > 0 | (9)
φ = 0.24, 2.91 | (10)
Finally, for nominal voltage:

2π

2

⋅ 80kHz ⋅ 50W ⋅ 2.60 ⋅ 10⁻⁵
H
4.17 ⋅ 50V ⋅ 12V

= (φπ − φ
2
) φ > 0 | (11)
φ = 0.29, 2.85 | (12)
φVmin = 0.52 rad | φVmax = 0.24 rad | φVnom = 0.29 rad | / 3 pt.

### Q5: OUTPUT CAPACITANCE, COUT

NOTE: Take into account the worst operating condition. Calculate with the following steps:

1. Calculate the output DC current Iout at nominal power
2. Calculate currents I1 and I2 as defined in the course’s slides at the nominal power and lowest input voltage
3. Draw and plot the current waveform of the inductor iL
| | for one period
4. Draw and plot the current waveform of the output current of secondary side full bridge iFB,out for one period
5. Draw and plot the current waveform ∆i = iFB,out − Iout for one period
6. Based on this curve, calculate the ripple charge of the output capacitor ∆Q (i.e., the charge that causes the output voltage ripple)
7. Calculate Cout

The output DC current at nominal power is:

Iout =

Pout,nom Uout | = 50 W
| 12 V ≈ 4.17 A | | (13)

From page 18 of the data sheet: I1 = 0.5 ⋅ (2φ − (1 − N
| V2
| V1

) π) ⋅
V1
ωL | (14)
= 0.5 (2 ⋅ 0.52 − (1 − 1.67)π) ⋅
| | 30
| | 2π ⋅ 80 × 10³ ⋅ 2.60 × 10⁻⁵ | (15)
= 3.60A | | | (16)
| | | (17)
I2 = 0.5 ⋅ (2 (N
| V2
| V1

) φ + (1 − N
| V2
| V1

) π) ⋅
| | V1
| | ωL | (18)
= 0.5 (2 ⋅ 1.67 ⋅ 0.52 + (1 − 1.67)π) ⋅
| | 30
| | 2π ⋅ 80 × 10³

⋅ 2.60 × 10⁻⁵

| | | (19)
= −0.40A | | | (20)
The inductor current waveform iL

(θ) is piecewise-linear over one switching period with key values:

θ | iL
0 | −I2
φ | I1
π | I2
π + φ | −I1
2π | −I2
The plot is shown below in figure 2.

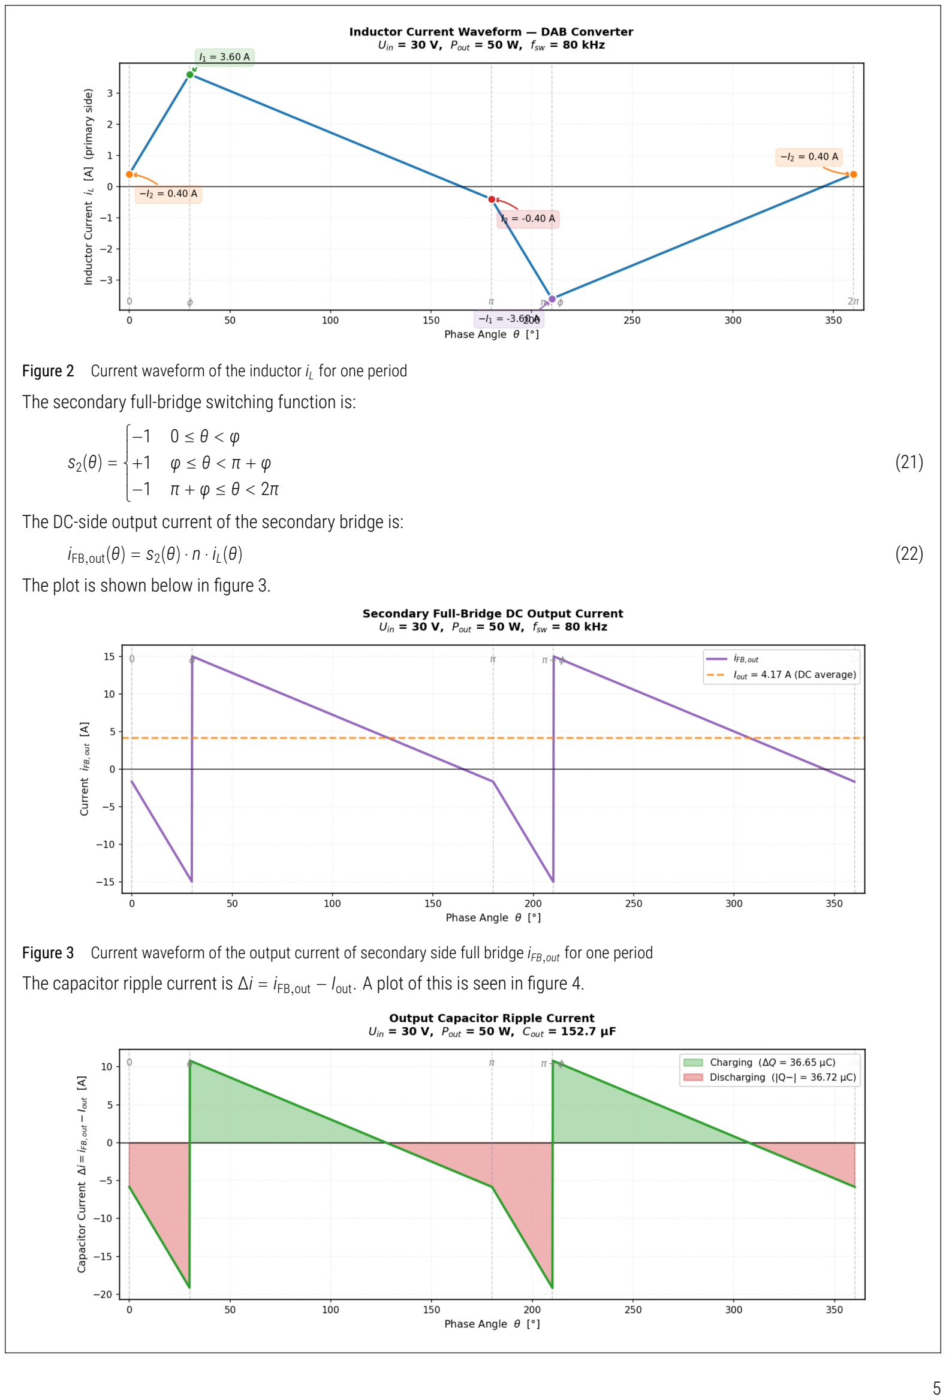
[picture p12: page 5]

Figure 2 Current waveform of the inductor iL

for one period
The secondary full-bridge switching function is:

s2

(θ) =

⎧
⎪⎪⎪⎪
⎨
⎪⎪⎪⎪
⎩

−1 0 ≤ θ < φ
+1 φ ≤ θ < π + φ
−1 π + φ ≤ θ < 2π

(21)

The DC-side output current of the secondary bridge is:
iFB,out(θ) = s2

(θ) ⋅ n ⋅ iL

(θ) | (22)

The plot is shown below in figure 3.

Figure 3 Current waveform of the output current of secondary side full bridge iFB,out for one period The capacitor ripple current is ∆i = iFB,out − Iout. A plot of this is seen in figure 4.

Figure 4 Current waveform ∆i = iFB,out − Iout for one period
The ripple charge is obtained by integrating the positive portion:

∆Q = ∫
∆i>0
∆i dθ | (23)
= 36.65 μC | (24)
The required output capacitance is:

Cout =

∆Q ∆Uout,pp | (25)

=

36.65 μC
240 mV | (26)
= 152.72 μF | (27)
Iout = 4.17 A | I1 = 3.60 A | I2 = −0.40 A | ∆Q = 36.65μ C | Cout = 152.72 μF | / 10 pt.

### Q6: PLECS VALIDATION FOR THE OUTPUT VOLTAGE RIPPLE

Using the provided PLECS model Q6.plecs, enter your DAB converter parameters. Verify that the output voltage ripple meets the requirements during the operation with the minimum input voltage. Please show the following waveforms:
a) Current of the inductor iL
b) Output current of the secondary side full bridge iFB,out
c) Output voltage vout
NOTE: Please show only three switching periods after the signals reach steady state.

Also, write down your output voltage peak-to-peak ripple.

The DAB converter was simulated in PLECS at minimum input voltage 30V using the parameters derived above. Figure 5 shows the required waveforms.

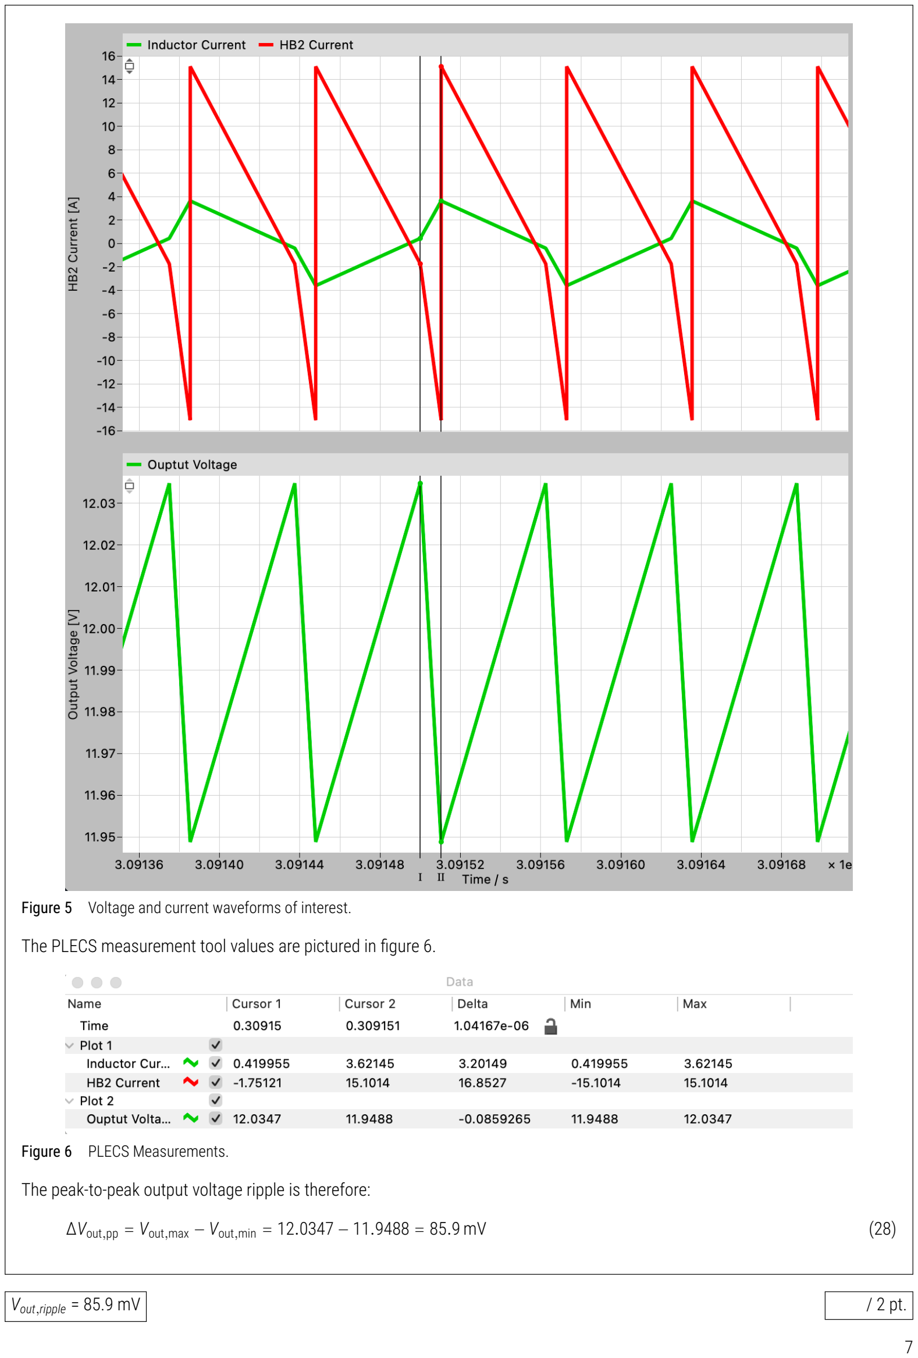
[picture p13: page 7]

Figure 5 Voltage and current waveforms of interest.
The PLECS measurement tool values are pictured in figure 6.

Figure 6 PLECS Measurements.
The peak-to-peak output voltage ripple is therefore:
∆Vout,pp = Vout,max − Vout,min = 12.0347 − 11.9488 = 85.9 mV | (28)
Vout,ripple = 85.9 mV | / 2 pt.

### Q7: CURRENT OF THE OUTPUT CAPACITOR, ICOUT

Using the simulation from Q6, obtain and present the waveform of the output capacitor’s current iCout. Obtain the RMS value ICout,RMS using PLECS built in calculation blocks.

The plot is shown in figure 7.

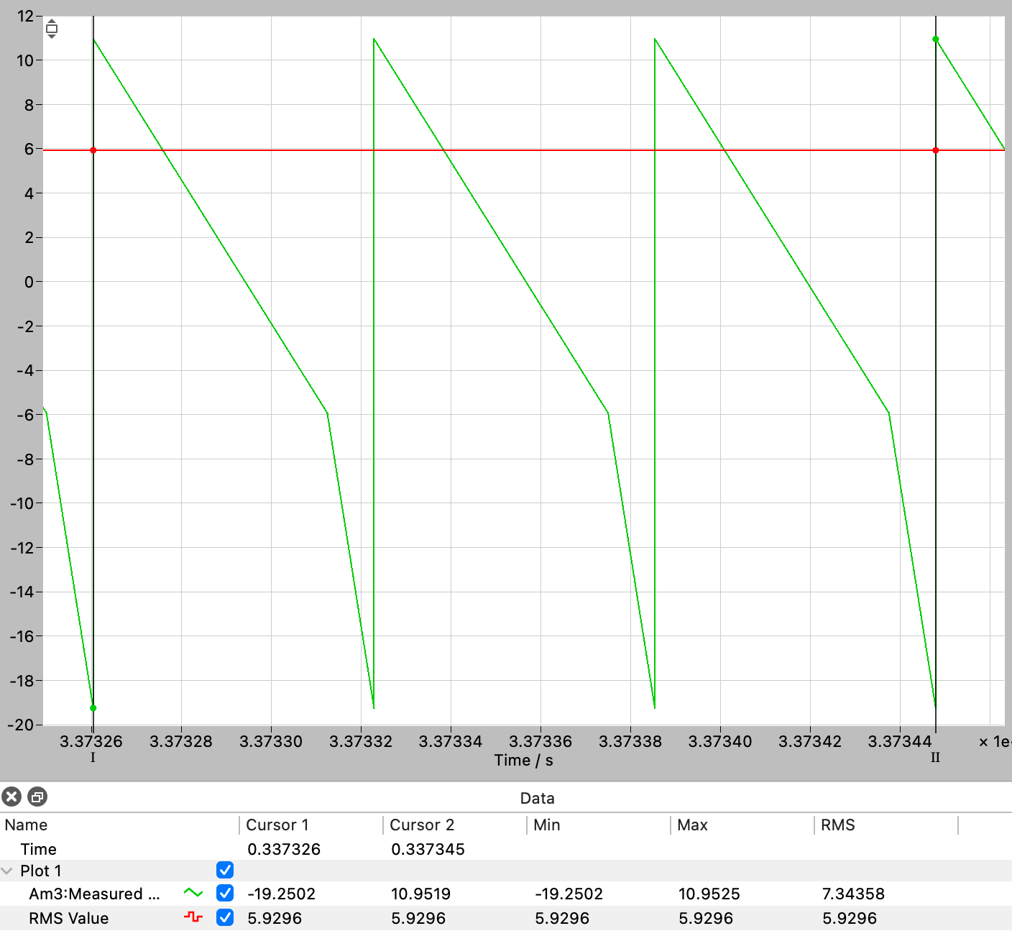
[picture p14: figure]

Figure 7 Waveform of the output capacitor’s current iCout From the PLECS measurement tool:
- iCout,min = −19.25 A, iCout,max = 10.95 A
- ICout,RMS = 5.93 A (from PLECS)
ICout,RMS = 5.93 A | / 2 pt.

### Q8: DC BLOCKING CAPACITOR, CDCBLOCK

DC Blocking capacitors are introduced in the power stage to avoid saturation of the transformer due to dead-time impact or unbalanced currents, especially during start-up and load transients. The DC capacitor should not affect the switch node voltage in a significant manner. A good starting value can be determined using provided equation.

CDCblock,min =

100
4 × π

2 × f
sw × L

(29)

CDCblock,min =

100
4 × π

2 × f

2
sw × L

=

100
4 × π

2 × 80000² × 2.60 × 10⁻⁵

= 1.52 × 10⁻⁵

CDCBlock,min = 15.2μF | / 2 pt.

### Q9.1: INPUT CAPACITANCE DEFINED BY VOLTAGE RIPPLE, CIN,RIPPLE

Consider 2 % of voltage ripple tolerance, similar with the calculation in Q5. Calculate the DC input current Iin and the current which goes to the primary side H-bridge stage iFB,pri. The difference of these currents causes the voltage ripple on the capacitance Cin,ripple.

The worst-case DC input current is:

Iin =

Pout,nom
Uin,min

=

50 W
30 V = 1.667 A | (30)

The primary full-bridge switching function is:

s1

(θ) = {
+1 0 ≤ θ < π −1 π ≤ θ < 2π | (31)

The current drawn by the primary bridge is iFB,pri(θ) = s1

## (θ) iL

(θ), and the input capacitor current is:

iCin (θ) = Iin − iFB,pri(θ) | (32)

With a 2 % input voltage ripple tolerance (∆Uin,pp = 0.02 × 30 V = 0.60 V), the ripple charge and required capacitance are:

∆Qin = ∫

iCin >0

iCin dθ = 6.08 μC | (33)

Cin,ripple =

∆Qin
∆Uin,pp

=

6.08 μC
0.60 V = 10.14 μF | (34)
Cin,ripple = 10.14 μ F | /2 pt.

### Q9.2: INPUT CAPACITANCE DEFINED BY HOLD-UP TIME, CIN,HOLDUP

In some applications, there may be an AC-DC converter that provides the input voltage to the DAB converter. In case that there is an grid outage (loss of AC supply), there needs to be sufficient installed energy in the capacitance between AC-DC and DC-DC DAB converter, allowing for uninterrupted operation and power delivery to the load at DAB output. This requirement is usually referred to as hold-up time. While in your project, we do not have AC-DC stage before DAB, we can still consider this scenario and calculate required energy or capacitance.

Calculate the minimum required capacitance so that, in case of a half-cycle grid’s interruption (10 ms), the DAB output voltage remains within the limits, while the converter outputs its rated power. Consider the scenario where the input voltage is allowed to drop from the rated value to the minimum value during 10 ms, while the converter delivers rated power to the load.

During a half-cycle grid interruption (tholdup = 10 ms), the input capacitor must supply the converter while the voltage drops from Uin,nom = 50 V to Uin,min = 30 V. The energy balance gives:

∆E =

1
2

Cin,holdup (U
2
in,nom − U

2

in,min) = Pout,nom ⋅ tholdup | (35)

Solving for Cin,holdup:

Cin,holdup =

2 Pout,nom tholdup

U

2
in,nom − U

2
in,min

=

2 × 50 W × 10 ms
50² − 30² V

2

=

1 J
1600 V²
= 625.00 μF | (36)
Cin,holdup = 625 μF | /2 pt.

### Q10: DISCHARGE RESISTANCE

A discharge resistance is connected in parallel to the input capacitor to completely discharge the input capacitance when the converter is turned off. This is a safety feature, which prevents the risk of electrical shock to the body of curios humans, interested to hold your DAB converter in their hands.

Determine the required resistance Rdischarge to completely discharge the input capacitance from 100% to 5% of the rated voltage in less than 1 minute.

Presence of this resistor will cause a constant power loss in operation and impact your DAB efficiency. Calculate the power loss Ploss,Rdischarge of this resistor when working with maximum input voltage.

The voltage across a capacitor during RC discharge follows:
U(t) = U0
⋅ e

−t/(RC)
(37)
To discharge from 100% to 5% of rated voltage within tdischarge = 60 s:

0.05 = e

−tdischarge/(RC) ⇒ Rdischarge =
tdischarge
Cin ⋅ ln(20)
(38)

Using Cin = 700 μF:

Rdischarge =

60 s
700 × 10⁻⁶

F × ln(20)
=

60
700 × 10⁻⁶ × 2.9957
= 28612 Ω ≈ 28.61 kΩ | (39)

The continuous power loss at maximum input voltage is:

Ploss,Rdischarge =

U

2
in,max
Rdischarge

=

60²
28612 = 0.126 W (0.252% of Pout,nom) | (40)
Rdischarge = 28.61 kΩ | Ploss,Rdischarge = 125.82mW | /4 pt.

### Q11: PLECS VALIDATION FOR MAXIMUM AND MINIMUM INPUT VOLTAGE

Now that you have determined the values of all relevant components, enter your parameters into the provided PLECS model Q11.plecs of the DAB converter. Verify the results for the maximum input voltage. For this purpose, include the following waveforms:

a) Transformer primary and secondary side voltage
b) Voltage and current across the inductor L
c) Voltage across the DC blocking capacitor CDCblock
d) Current of the output capacitor Cout
e) Output voltage and output current

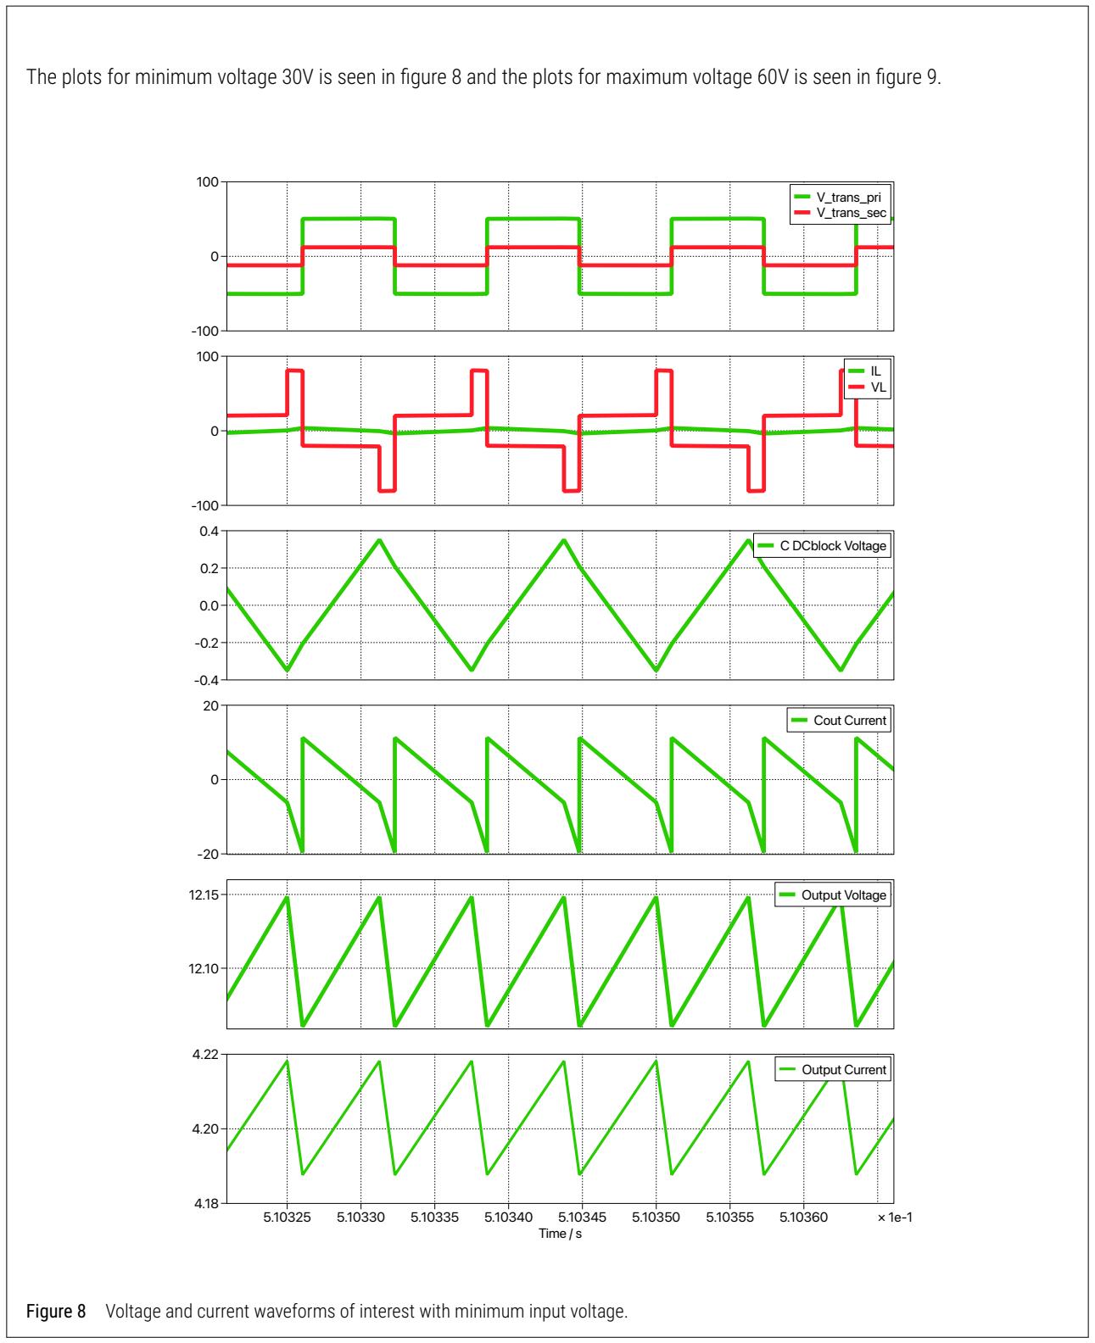
[picture p15: figure]
Time / s; V_trans_pri V_trans_sec; C DCblock Voltage; Cout Current; Output Voltage; Output Current

The plots for minimum voltage 30V is seen in figure 8 and the plots for maximum voltage 60V is seen in figure 9.

Figure 8 Voltage and current waveforms of interest with minimum input voltage.

-100

0

100

-100

0

100

-0.4

-0.2

0.0

0.2

0.4

-20

0

20

12.10

12.15

× 1e-1
Time / s
5.10320 | 5.10325 | 5.10330 | 5.10335 | 5.10340 | 5.10345 | 5.10350 | 5.10355

4.18

4.20

4.22

V_trans_pri
V_trans_sec

IL
VL

C DCblock Voltage

Cout Current

Output Voltage

Output Current

Figure 9 Voltage and current waveforms of interest with maximum input voltage.
The larger phase shift (φmin = 30.00◦
) at minimum input voltage leads to higher peak inductor currents. The output voltage ripple and average output voltage remain within specification. At maximum input voltage the required phase shift is smaller (φmax = 13.51◦
), resulting in lower peak inductor currents and a reduced output voltage ripple. The output voltage remains regulated at Uout = 12 V within the 2 % specification.

/ 5 pt.

### Q12: PLECS VALIDATION FOR ¹ OF THE NOMINAL POWER

In Q11, you validated your converter design when the input voltage is at its maximum and minimum. In addition to these operating points, your DAB converter must be able to regulate the output voltage within the specific voltage and power ranges. To validate that, analyze the simulation results for the minimum input voltage at 1/4 of the nominal power. You have to re-calculate the phase shift φ1

4
by Equation1. Please update these values in the PLECS simulation files.
Then show the following waveforms:
a) Transformer primary and secondary side voltage
b) Voltage and current across the inductor L
c) Voltage across the DC blocking capacitor CDCblock
d) Current of the output capacitor Cout
e) Output voltage and output current
f) Voltage and gate signal of one MOSFET
Comment briefly on your observations on the graphs: What is the voltage across the selected MOSFET? Is ZVS still achieved?

The phase shift for 1
4

of nominal power at minimum input voltage is re-calculated from the SPS power transfer equation:

P1/4 =

Pout,nom
4
= 12.5 W | (41)

φ1/4 =

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
8 fsw L P1/4

n Uin,min Uout

⎞
⎟
⎠

= 0.1132 rad = 6.48◦
(42)

The simulation waveforms are shown in Figure 10.

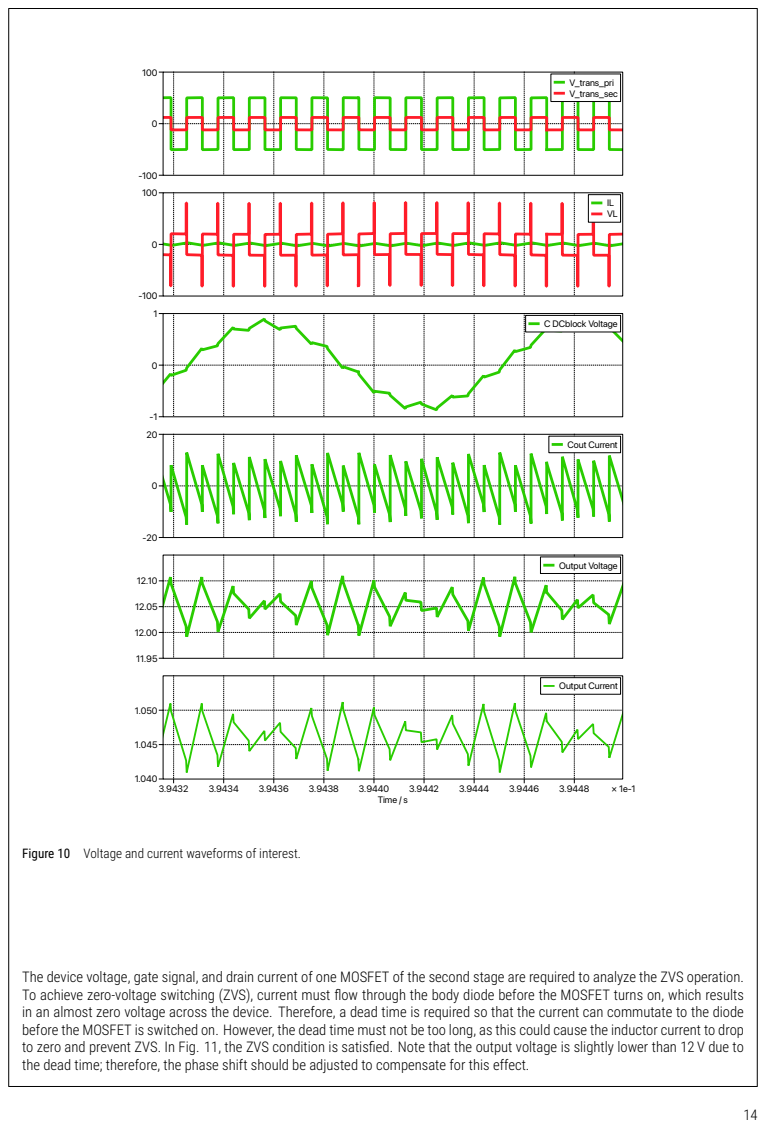
[picture p16: page 14]
Time / s; V_trans_pri V_trans_sec; C DCblock Voltage; Cout Current; Output Voltage; Output Current

Figure 10 Voltage and current waveforms of interest.

The device voltage, gate signal, and drain current of one MOSFET of the second stage are required to analyze the ZVS operation.
To achieve zero-voltage switching (ZVS), current must flow through the body diode before the MOSFET turns on, which results
in an almost zero voltage across the device. Therefore, a dead time is required so that the current can commutate to the diode
before the MOSFET is switched on. However, the dead time must not be too long, as this could cause the inductor current to drop
to zero and prevent ZVS. In Fig. 11, the ZVS condition is satisfied. Note that the output voltage is slightly lower than 12 V due to
the dead time; therefore, the phase shift should be adjusted to compensate for this effect.

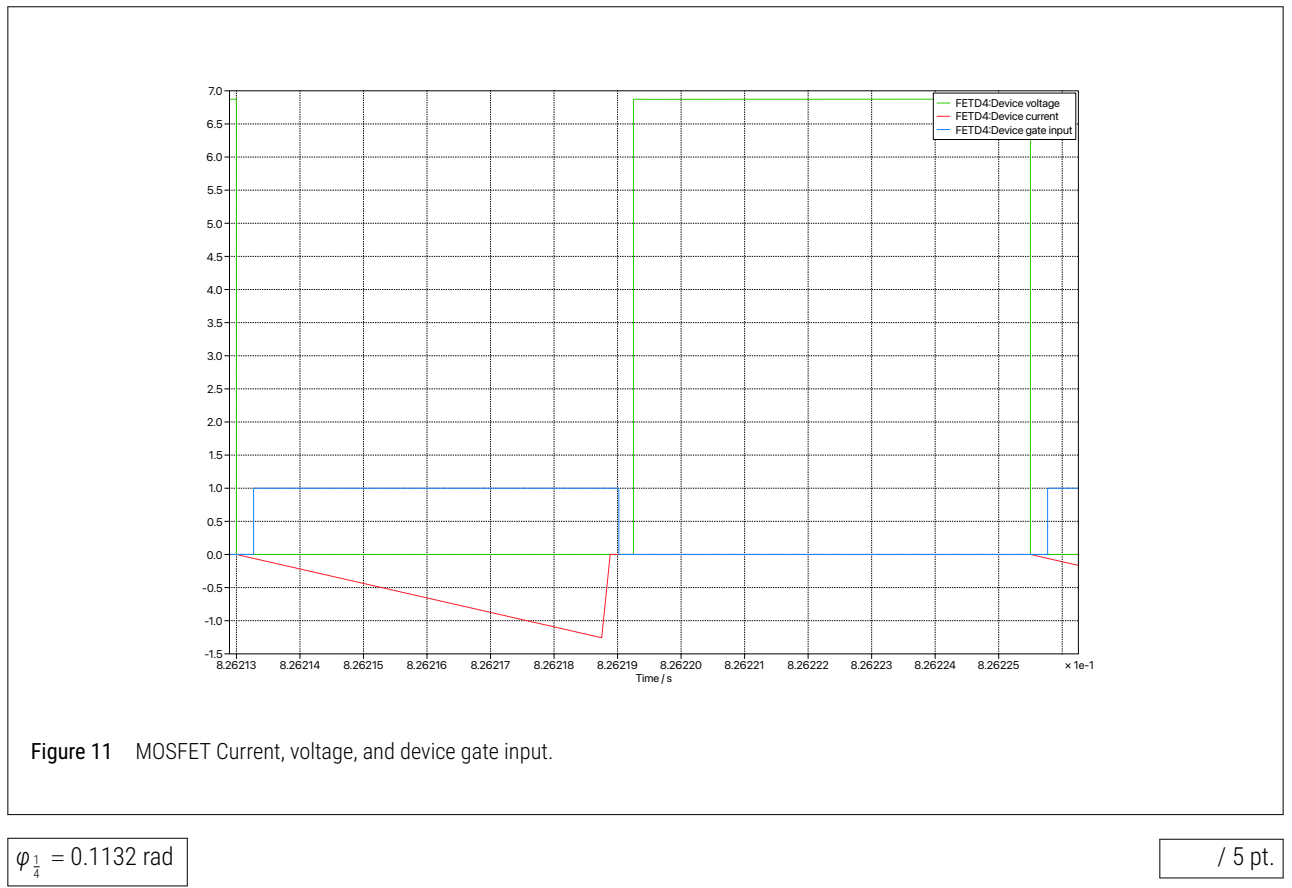
[picture p17: figure]
Time / s; FETD4Device voltage FETD4Device current FETD4Device gate input; = 0.1132 rad

Figure 11 MOSFET Current, voltage, and device gate input.

## SELECTION OF SEMICONDUCTORS

The second part of this report focuses on the selection of semiconductor devices for your design. You will have to derive equations for your design, eventually leading to the selection of proper semiconductors that you will use in your design. As in the first set of questions, provide numeric answers with a precision of two digits after the decimal point in the provided unit.

### Q13: PRIMARY SIDE SEMICONDUCTOR STRESSES

To select an appropriate MOSFET for your design, you need to determine the maximum voltage and current stress that it has to handle in your circuit under the worst-case operating conditions. For this purpose, provide:
a) The maximum voltage across the primary-side MOSFET UQ,pri,max;
b) The maximum current flowing through the primary side MOSFET IQ,pri,max.
Parasitic effects cause voltage overshoots that can damage the device. To estimate these effects, a good practice is to scale up the maximal voltage stress by a factor of 1.5.

Obtain the maximum voltage stress and maximum current by theoretical calculation first, then verify them by the simulation in the previous section. In your answer, indicate the working scenario from which you obtained UQ,pri,max and IQ,pri,max. Then, considering the voltage safety factor of 1.5, give the final answer for the maximum voltage stress.

The max voltage across the primary-side MOSFET is just the max input voltage, 60V. With the safety factor of 1.5, UQ,pri,max = 90V. The inductor current iL

(t) flows through the transformer and back through the primary-side H-bridge. When a MOSFET is ON, it conducts this inductor current. The inductor current varies between I1

(peak positive) and I2

(peak negative). Thus the max current is just the higher value between I1 and I2

. I1

is higher with a value of 3.60A. These values were used in the simulation from the previous section and verified.

UQ,pri,max = 90V | IQ,pri,max = 3.60A | / 4 pt.

### Q14: PRIMARY SIDE SEMICONDUCTOR SELECTION

Based on the obtained values from Q13, select one specific MOSFET device for your design from the offered lists in Table 2. Elaborate briefly on why you chose exactly this models and highlight it in the Table, as exemplified for the first device.
NOTE: Please do NOT choose device 9 as the maximum gate voltage is 5 V, and the gate drive voltage is designed to be 12 V this year.

MOSFET No. 6 is selected because the Uds and Icont are well within spec, without being massively overrated. Devices 1-5 are all overrated for the calculated stresses, which would likely be unnecessarily costly and possibly large. Devices 8-10 are all underrated.

MOSFET model No. : PHP18NQ11T | / 4 pt.

Table 2 The list of offered MOSFET devices. The parameter Uds is the rated drain-source voltage, whereas the Icont stands for continuous drain-source current. All devices are in the TO-220 package (see Fig. 12).

No. | Manufacturer | Product | Uds,max (V) | Icont (A) | Rds,on @ 25 °C (mΩ)
1 | Infineon | IRFB5620PbF | 200 | 18 | 60
2 | Rohm | RCX300N20 | 200 | 16.3 | 60
3 | Onsemi | FDPF18N20FT-G | 200 | 10.8 | 120
4 | Rohm | RCX200N20 | 200 | 10.8 | 100
5 | Onsemi | FQPF630 | 200 | 6.3 | 340
6 | Nexperia | PHP18NQ11T | 110 | 13 | 80
7 | Vishay | SiHF530 | 100 | 10 | 160
8 | ST | STP16NF06 | 60 | 11 | 80
9 | Infineon | IRLZ44NPBF | 55 | 47 | 22
10 | Infineon | IRLB8743PbF | 30 | 110 | 3.2

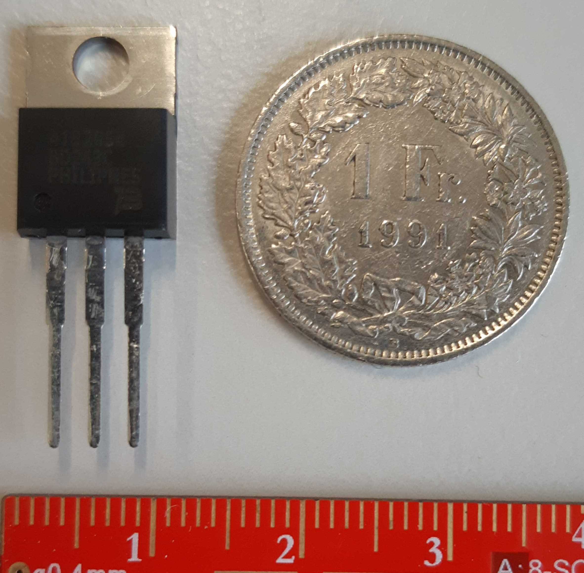
[picture p18: figure]

Figure 12 A semiconductor in a TO-220 case.

### Q15: SECONDARY SIDE SEMICONDUCTOR STRESSES

Similarly as for the primary side, provide:
a) The maximum voltage across the secondary-side MOSFET UQ,sec,max;
b) The maximum current flowing through the secondary-side MOSFET IQ,sec,max.
Similarly to the primary-side devices, consider a scaling of 1.5 for the maximum voltage stress.
Obtain the maximum voltage stress and maximum current by theoretical calculation first, then verify them by the simulation in the previous section. In your answer, indicate the working scenario from which you obtained UQ,sec,max and IQ,sec,max. Then, considering the voltage safety of 1.5, give the final answer for the maximum voltage stress for both the primary and secondary sides.

The maximum voltage on the secondary side is the output voltage, which is designed for 12V in this case. With the safety factor, the UQ,sec,max should be 18V theoretically.
The secondary bridge sees the primary inductor current multiplied by the transformer turns ratio n = 4.17.

IQ,sec,max = 4.17 ⋅ 3.60 = 15.00 A.
These values were used in the simulation from the previous section and verified.
UsecMOS,max = 18V | IsecMOS,max = 15.00 A | / 4 pt.

### Q16: SECONDARY SIDE SEMICONDUCTOR SELECTION

Based on the obtained values from Q15, select one specific MOSFET device for your design from the offered lists in Table 2. Briefly elaborate on why you chose exactly this model and highlight it in the Table, as it is exemplified for the first device.

Device no. 10 is selected due to its high current capacity and suitable voltage. Based on the 15.00 A calculated current, the only MOSFETs satisfying the requirement are 1, 2, 9 and 10. 9 is excluded (5V gate voltage), and options 1 and 2 have a massively overrated voltage.

MOSFET model No. : IRLB8743PbF | / 4 pt.

## CALCULATION OF CURRENTS’ AVERAGE AND RMS VALUES

In this section, you will obtain the Average and the RMS current values for the semiconductors of the DAB converter through calculation and simulation. The results have to be given with two digits after the decimal point using the given unit.
NOTE: Ignore the DC blocking capacitor during the calculation.

### Q17: CALCULATION OF THE PRIMARY SIDE MOSFET CURRENT

Consider the worst-case operating conditions and provide:
a) The plot of the current waveform of one primary side MOSFET. Select one from 4 MOSFETs, and do NOT obtain this current waveform by simulation.
b) The primary side MOSFET’s RMS current IQ,pri,rms;
c) The primary side MOSFET’s average current IQ,pri,avg;
In your answer, indicate the results of your IQ,pri,rms, IQ,pri,avg.

The worst-case operating conditions occur at minimum input voltage 30V and nominal output power 50W, where the phase shift is largest (φ = 30.00◦
= 0.5236 rad).
We select MOSFET Q1 (high-side, leg A). Q1 conducts during 0 ≤ θ < π, carrying the inductor current iL

(θ):

iQ1

(θ) = {
iL

(θ) 0 ≤ θ < π

0 π ≤ θ < 2π

(43)

The current waveform is plotted in figure 13.

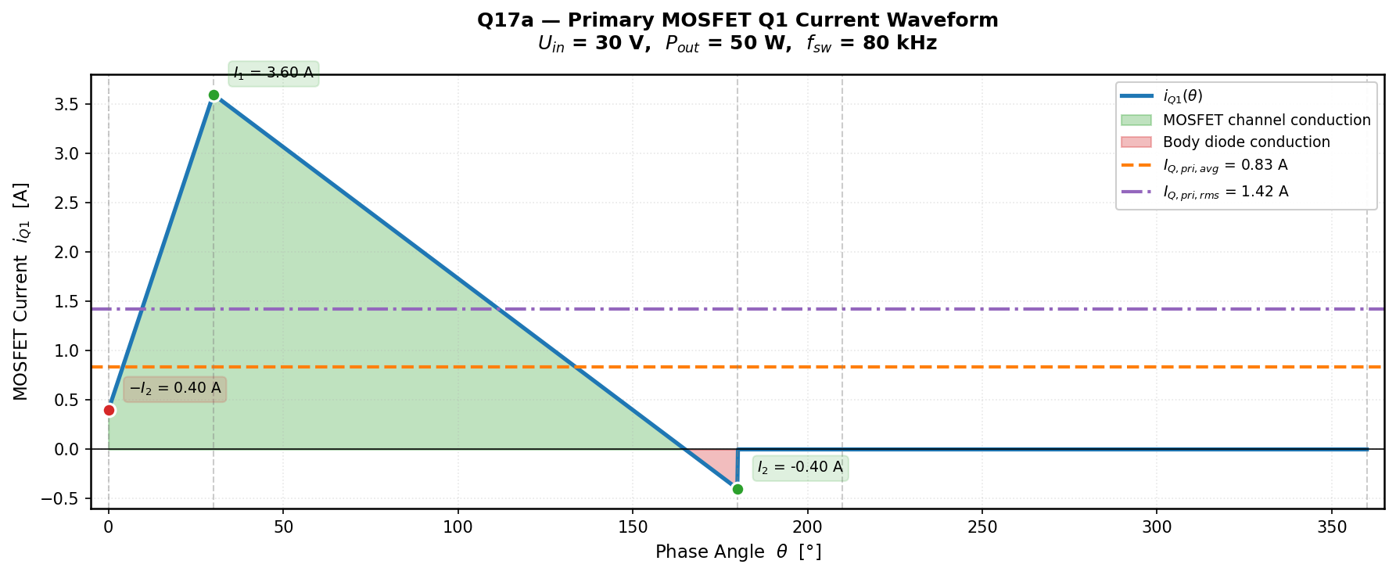
[picture p19: figure]

Figure 13 Primary MOSFET Q1 current waveform (analytical) at Uin = 30 V, Pout = 50 W. Within Q1’s conduction interval, the current is piecewise-linear:
- Segment 1 (0 ≤ θ < φ): from −I2 = 0.40 A to I1 = 3.60 A
- Segment 2 (φ ≤ θ < π): from I1 = 3.60 A to I2 = −0.40 A
Using the piecewise-linear integration formulas ∫
a→b

x dθ =

∆θ
2

(a + b) and ∫

a→b

x

2
dθ =

∆θ
3

(a
2
+ ab + b

2

):

IQ,pri,avg =

1
2π

[
φ
2

(I1 − I2

) +
π − φ
2

(I1 + I2

)]

=

1
2π

[
0.5236
2

(3.60 + 0.40) +
π − 0.5236
2
(3.60 − 0.40)] = 0.83 A | (44)

IQ,pri,rms =

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
2 − I2

I1 + I

2
1

) +
π − φ
3

(I
2
1 + I1

I2 + I

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
0.5236
3

(0.16 + 1.44 + 12.96) +
2.618
3
(12.96 − 1.44 + 0.16)] = 1.42 A | (45)

Calculation: IQ,pri,rms = 1.42 A IQ,pri,avg = 0.83 A | / 4 pt.

### Q18: PLECS SIMULATION OF THE PRIMARY SIDE MOSFET CURRENT

Using the provided PLECS model given in Q11 and considering worst-case operating conditions, show the simulation waveforms in the following box and obtain the values for:
a) The primary side MOSFET’s RMS current IQ,pri,rms;
b) The primary side MOSFET’s average current IQ,pri,avg;

The PLECS simulation was run at worst-case conditions (Uin = 30 V, Pout = 50 W). The measured current through one primary-side MOSFET is shown in figure 14.

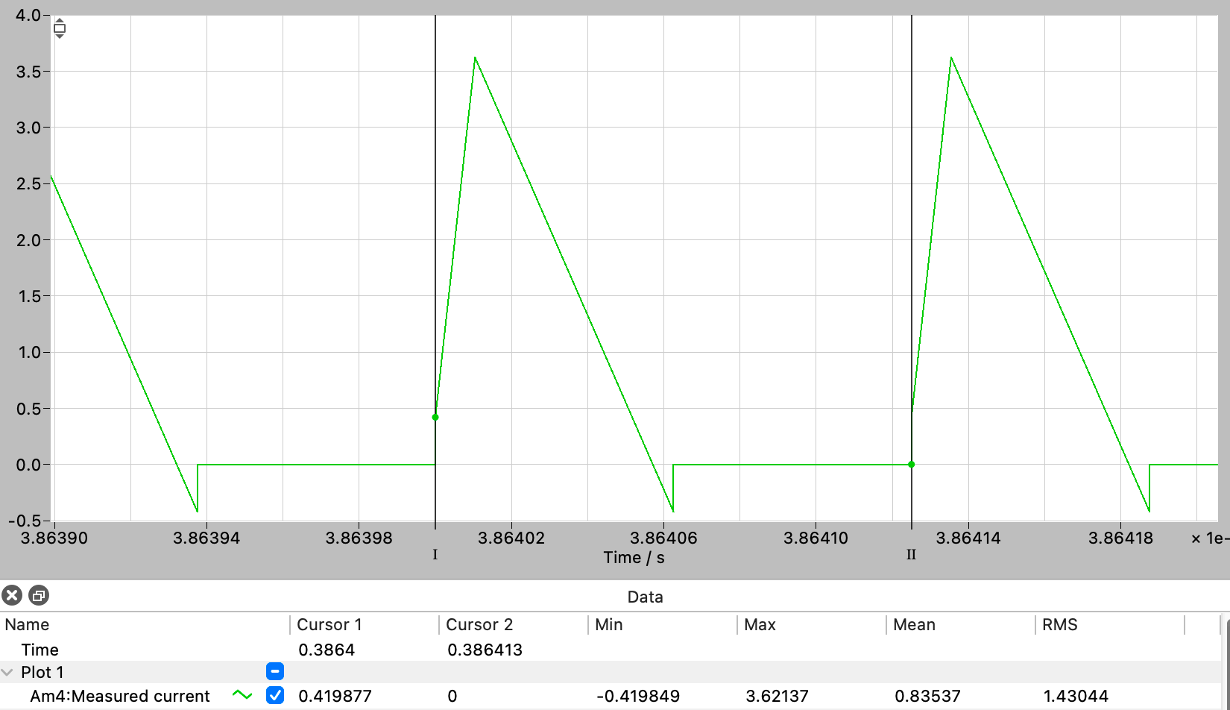
[picture p20: figure]

Figure 14 PLECS simulation of primary MOSFET current with measurement data. From the PLECS measurement tool (over one switching period):
- IQ,pri,avg = 0.84 A
- IQ,pri,rms = 1.43 A
These values are in good agreement with the analytical results from Q17 (IQ,pri,avg = 0.83 A, IQ,pri,rms = 1.42 A).
Simulation: IQ,pri,rms = 1.43 A IQ,pri,avg = 0.84 A | / 4 pt.

### Q19: CALCULATION OF THE SECONDARY SIDE MOSFET CURRENT

Consider the worst-case operating conditions and provide:
a) Plot the current waveform of the secondary side MOSFET. Select one from 4 devices, and do NOT obtain this current waveform by simulation.
b) The secondary side MOSFET’s RMS current IQ,sec,rms;
c) The secondary side MOSFET’s average current IQ,sec,avg;
In your answer, indicate the results of your IQ,sec,rms, IQ,sec,avg.

The worst-case conditions are the same as Q17: Uin,min = 30 V, Pout,nom = 50 W, φ = 30.00◦ .

We select MOSFET Q5 (high-side, leg C, secondary bridge). Q5 conducts when s2 = +1, i.e. during φ ≤ θ < π + φ, carrying the secondary winding current n ⋅ iL

(θ):

iQ5

(θ) = {
n ⋅ iL

(θ) φ ≤ θ < π + φ
0 | otherwise | (46)

The current waveform is plotted in Figure 15.

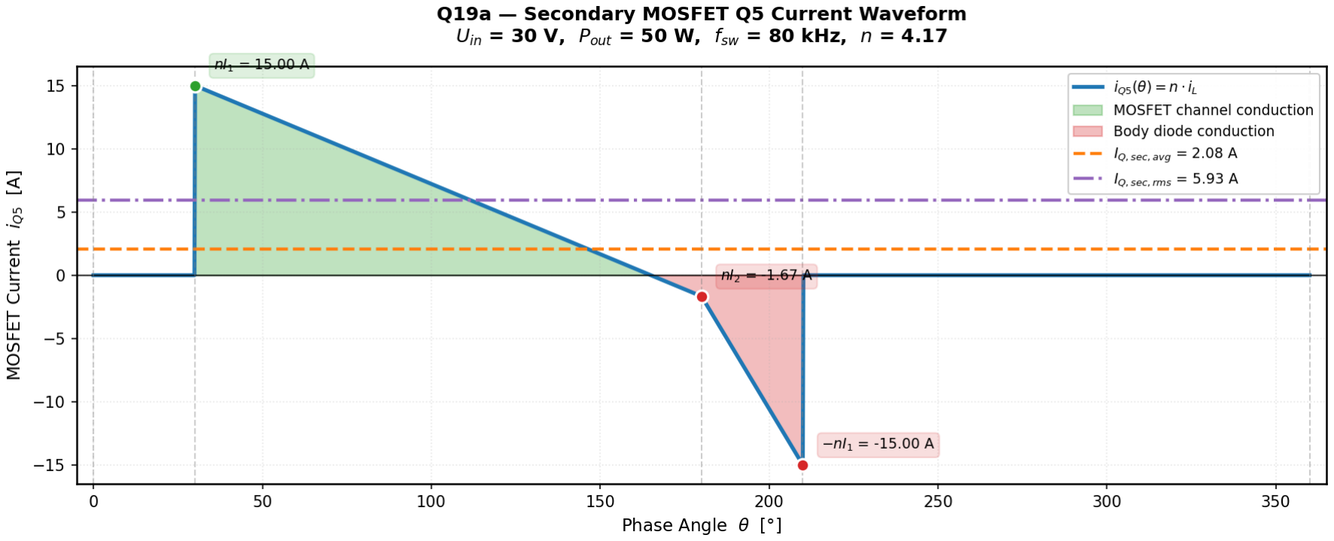
[picture p21: figure]

Figure 15 Secondary MOSFET Q5 current waveform (analytical) at Uin = 30 V, Pout = 50 W. Within Q5’s conduction interval, the secondary current (n ⋅ iL

) is piecewise-linear:
- Segment 1 (φ ≤ θ < π): from nI1 = 15.00 A to nI2 = −1.67 A
- Segment 2 (π ≤ θ < π + φ): from nI2 = −1.67 A to −nI1 = −15.00 A Using the same piecewise-linear integration formulas as Q17:

IQ,sec,avg =

1
2π

[
π − φ
2

n(I1 + I2

) +
φ
2

n(I2 − I1

)]

=

1
2π

[
2.618
2

⋅ 4.17 ⋅ (3.20) +
0.5236
2
⋅ 4.17 ⋅ (−4.00)] = 2.08 A | (47)

IQ,sec,rms =

√

n

2
2π

[
π − φ
3

(I
2
1 + I1

I2 + I

2
2

) +
φ
3

(I
2
2 − I2

I1 + I

2
1

)]

=

√
4.17²
2π

[
2.618
3

(12.96 − 1.44 + 0.16) +
0.5236
3
(0.16 + 1.44 + 12.96)] = 5.93 A | (48)
Calculation: IQ,sec,rms = 5.93 A IQ,sec,avg = 2.08 A | / 4 pt.

### Q20: PLECS SIMULATION OF THE SECONDARY SIDE MOSFET CURRENT

Using the provided PLECS model given in Q11, consider worst-case operating conditions, show the simulation waveforms, and obtain the values for:
a) The secondary side MOSFET’s RMS current IQ,sec,rms;
b) The secondary side MOSFET’s average current IQ,sec,avg;

The PLECS simulation was run at worst-case conditions (Uin = 30 V, Pout = 50 W). The measured current through one secondary-side MOSFET is shown in Figure 16.

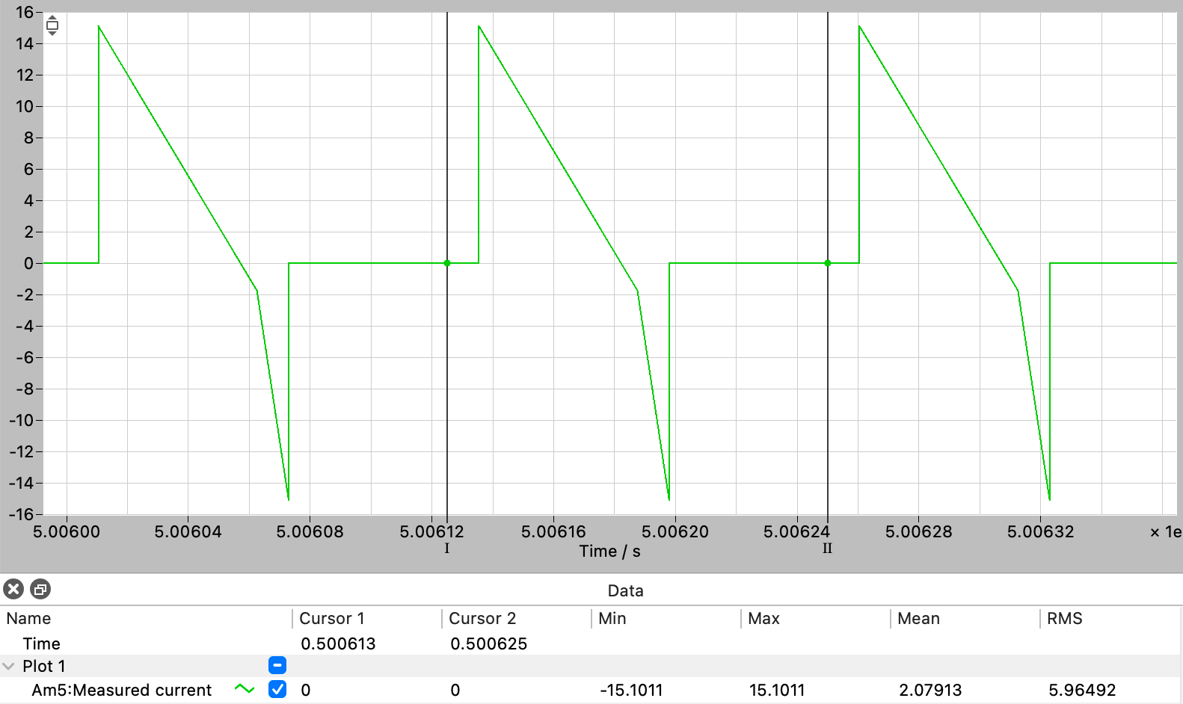
[picture p22: figure]

Figure 16 PLECS simulation of secondary MOSFET current with measurement data. From the PLECS measurement tool (over one switching period):
- IQ,sec,avg = 2.08 A
- IQ,sec,rms = 5.96 A
These values are in good agreement with the analytical results from Q19 (IQ,sec,avg = 2.08 A, IQ,sec,rms = 5.93 A). The slight difference in RMS values is due to non-ideal waveform effects captured in the simulation (e.g. finite switching transitions and the DC blocking capacitor).
Simulation: IQ,sec,rms = 5.96 A IQ,sec,avg = 2.08 A | / 4 pt.

## SEMICONDUCTOR LOSSES AND THERMAL DESIGN

Using your previous results, semiconductor losses can be calculated and compared with the provided MATLAB Loss Tool. The results using the worst case (provided by the Loss Tool) will be used to help you select appropriate heatsinks for your design. As in the other questions, results should be given with two digits after the decimal point in the unit indicated. The Infineon Application Notes (https://application-notes.digchip.com/070/70-41484.pdf) should be used as a guideline for questions Q21 to Q24.

### Q21: PRIMARY SIDE MOSFET CONDUCTION LOSSES

Using the datasheet of your selected MOSFET as well as the results from your simulations from Q19, calculate the MOSFET conduction losses at steady state under worst-operating conditions (Imax and Uin,min). The MOSFETs are assumed to operate with a junction temperature of 125 °C.

The datasheet provides a normalized RDS,on curve as a function of junction temperature. The normalized value RDS,on,norm(TJ

) is
read directly from the graph at the operating temperature.

RDS,on(TJ

) = RDS,on,max(25◦

C) ⋅ RDS,on,norm(TJ
) | (49)

Since the dead time is small, diode losses are neglected. The MOSFET conduction loss is:

PC = PC,M = RDS,on,max(25◦

C) ⋅ RDS,on,norm(TJ

) ⋅ I
2
D,rms | (50)
For the primary MOSFET (PHP18NQ11T) at TJ = 125◦ C:

RDS,on,max(25◦

C) = 80 mΩ | (51)

RDS,on,norm(125◦

C) = 2.0 (from datasheet curve) | (52)

RDS,on(125◦

C) = 80 mΩ × 2.0 = 160 mΩ | (53)

Using ID,rms = IQ,pri,rms = 1.42 A from Q17: PC,pri = 0.160 Ω × 1.42²
= 0.32 W | (54)
PQ,pri,cond = 0.32 | W | / 4 pt.

### Q22: SECONDARY SIDE MOSFET CONDUCTION LOSSES

Using the datasheet of your selected MOSFET as well as the results from your simulations from Q21, calculate the MOSFET conduction losses at steady state under worst-operating conditions (Imax and Uin,min). The MOSFETs are assumed to operate at a junction temperature of 125 °C.

For the secondary MOSFET (IRLB8743PbF) at TJ = 125◦
C:
RDS,on,max(25◦
C) = 3.2 mΩ | (55)

RDS,on,norm(125◦

C) = 2.5 (from datasheet curve) | (56)

RDS,on(125◦

C) = 3.2 mΩ × 2.5 = 8.0 mΩ | (57)

Using ID,rms = IQ,sec,rms = 5.93 A from Q19: PC,sec = 0.008 Ω × 5.93²
= 0.28 W | (58)

PQ,sec,cond = 0.28 | W | / 4 pt.

### Q23: PRIMARY SIDE MOSFET SWITCHING LOSSES

Using again the datasheet and your previous simulation results, calculate the primary side MOSFET turn-on and turn-off losses PT,on, PT,off, at steady state under worst-case operating conditions, that is, the conditions resulting in higher switching losses. For that, iterate in your calculations and find the conditions that yield higher switching losses and comment them in your solution.

NOTE 1: Remember that the converter is expected to always operate in ZVS, which will simplify your transistor switching losses calculations. In practice, if ZVS is lost in the operation, switching losses will increase.
NOTE 2: You will need to obtain from simulation the turn-off current of the MOSFET.
NOTE 3: Please consider the gate drive voltage as 12 V and gate resistance as 5 Ω

In your answer, explain how did you find the worst-case operating conditions and indicate which operating condition you got the results from.

ZVS Turn-On: The DAB converter is designed to always operate in Zero Voltage Switching (ZVS). At turn-on, the body diode of the incoming MOSFET conducts first, clamping VDS ≈ 0. Therefore:
PT,on = 0 | (59)
Turn-Off Losses: At turn-off, the MOSFET channel is hard-switched off while carrying current.

Eoff =

1
2
VDS ⋅ ID ⋅ (tru + tfi) | (60)
1. Voltage Rise Time (tru):

IG,off =

Uplateau
RG

(61)

tru =

(UDD − ID,on ⋅ RDS,on)

2 IG,off

(CGD1 + CGD2

) | (62)

where CGD1 and CGD2 are the gate–drain capacitances at the initial and final voltage levels, read from the datasheet (Crss).

2. Current Fall Time (tfi): Read directly from the datasheet.
Worst-case conditions: The input voltage only changes the voltage rise time. UDD and ID,on are the main factors. The worst case is at maximum input voltage, where UDD is highest, leading to the longest voltage rise time.
At Uin,max = 60 V, Pout = 50 W: φ = 13.51◦
, ID,on = I2 = 2.10 A.
Datasheet values: Uplateau = 5.0 V, CGD1 = 500 pF, CGD2 = 55 pF, tfi = 12 ns.
IG,off = 5.0/5.0 = 1.0 A | (63)
VDS,swing = 60 − 0.160 × 2.10 = 59.66 V | (64)
tru1 = 59.66 × 500 × 10⁻¹²/1.0 = 29.83 ns | (65)
tru2 = 59.66 × 55 × 10⁻¹²/1.0 = 3.28 ns | (66)

tru = (tru1 + tru2

)/2 = 16.56 ns | (67)

Eoff =

1
2

× 59.66 × 2.10 × (16.56 + 12) × 10⁻⁹
= 1.79 μJ | (68)

PT,off = Eoff ⋅ fsw = 1.79 × 10⁻⁶

× 80 × 10³
= 0.14 W | (69)
Total primary bridge switching losses (4 devices): 4 × 0.14 = 0.57 W.
PQ,pri,on = 0.00 | W | PQ,pri,off = 0.14 | W | / 8 pt.

### Q24: SECONDARY SIDE MOSFET SWITCHING LOSSES

Using again the datasheet and your previous simulation results, calculate the secondary side MOSFET turn-on and turn-off losses PT,on, PT,off, at steady state under worst-case operating conditions, that is, the conditions resulting in higher switching losses. For that, iterate in your calculations and find the conditions that yield higher switching losses and comment them in your solution.

NOTE 1: Remember that the converter is expected to always operate in ZVS, which will simplify your transistor switching losses calculations. In practice, if ZVS is lost in the operation, switching losses will increase.
NOTE 2: You will need to obtain from simulation the turn-off current of the MOSFET.
NOTE 3: Please consider the gate drive voltage as 12 V and gate resistance as 5 Ω

In your answer, explain how did you find the worst-case operating conditions and indicate which opearating condition you got the results from.

ZVS Turn-On: Same as the primary side, PT,on = 0.
Worst-case conditions: The current fall time is mainly affected by the current level. The worst case is at minimum input voltage, where the current is highest, leading to the longest current fall time.
At Uin,min = 30 V, Pout = 50 W: φ = 30.00◦
, ID,on = 15.10 A (from simulation). Datasheet values: Uplateau = 3.15 V, CGD1 = 700 pF, CGD2 = 200 pF, tfi = 36 ns.
IG,off = 3.15/5.0 = 0.63 A | (70)
VDS,swing = 30 − 0.008 × 15.10 = 29.88 V | (71)
tru1 = 29.88 × 700 × 10⁻¹²/0.63 = 33.20 ns | (72)
tru2 = 29.88 × 200 × 10⁻¹²/0.63 = 9.49 ns | (73)

tru = (tru1 + tru2

)/2 = 21.34 ns | (74)

Eoff =

1
2

× 29.88 × 15.10 × (21.34 + 36) × 10⁻⁹
= 12.94 μJ | (75)

PT,off = Eoff ⋅ fsw = 12.94 × 10⁻⁶

× 80 × 10³
= 1.03 W | (76)
Total secondary bridge switching losses (4 devices): 4 × 1.03 = 4.14 W.
PQ,sec,on = 0.00 | W | PQ,sec,off = 1.03 | W | / 8 pt.

### Q25: SEMICONDUCTOR EFFICIENCY

At this time, the losses of the semiconductors are known, calculate the efficiency η of your converter with the nominal power, when only semiconductor losses are considered. Please note that there will be other losses in your converter that will appear during the following stages of the design. You already have losses due to discharge resistor calculated in Q10. Nevertheless, semiconductor losses are dominant factor and are a good indication of the overall converter performance.

Only the semiconductor conduction and switching losses are considered, relative to the nominal output power. For both stages, the worst-case conditions are used, which are not the same for the first and the second stage.

Psemic,losses = PC,pri,total + PT,pri,total + PC,sec,total + PT,sec,total | (77)
= (4 × 0.32) + (4 × 0.14) + (4 × 0.28) + (4 × 1.03) | (78)
= 1.30 + 0.57 + 1.13 + 4.14 = 7.14 W | (79)

η = 1 −

Psemic,losses

Pnom

= 1 −

7.14
50 = 85.73 % | (80)

η = 85.73% | / 2 pt.

### Q26: LOSS TOOL

Modify the converter data input parameters in the provided loss tool in MATLAB and run it to acquire the losses for the different values of Uin and Pout (the loss tool already includes these values and performs the necessary simulations). Read the comments in the code carefully to obtain valid results.

From these results, identify the nominal operating point and compare it with your results; It may be different from your calculation since the losses are calculated with the pessimistic approximation of switching losses. Additionally, give a brief explanation for why there are more or fewer losses for different operating conditions.

The MATLAB Loss Tool was configured with the following converter parameters: n = 4.17, L = 26.04 μH, fsw = 80 kHz, primary MOSFET: PHP18NQ11T (RDS,on = 80 mΩ at 25°C), secondary MOSFET: IRLB8743PbF (RDS,on = 3.2 mΩ at 25°C), gate drive voltage 12 V, gate resistance 5 Ω, and junction temperature 125°C. Dead-time effects are included in the simulation.
The resulting loss breakdown and efficiency curves are shown in Figure 17.

P

out = 10 W

Uin

[V]

30 | 35 | 40 | 45 | 50 | 55 | 60

P

o

w

er L

osses [W] 0

0.5

1

1.5

2

2.5

3

Switching Losses | MOSFET Conduction Losses

Uin

[V]

30 | 35 | 40 | 45 | 50 | 55 | 60

Efficiency

2 [%] 82

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
out = 10 W

P

out = 30 W

Uin

[V]

30 | 35 | 40 | 45 | 50 | 55 | 60

P

o

w

er L

osses [W] 0

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
30 | 35 | 40 | 45 | 50 | 55 | 60

Efficiency

2 [%] 92

93

94

95

96

P

out = 30 W

P

out = 50 W

Uin

[V]

30 | 35 | 40 | 45 | 50 | 55 | 60

P

o

w

er L

osses [W] 0

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
30 | 35 | 40 | 45 | 50 | 55 | 60

Efficiency

2 [%] 94

95

96

97

98

P

out = 50 W

Figure 17 Semiconductor power losses and efficiencies achieved for different operating points.
At the nominal operating point (Uin,nom = 50 V, Pout = 50 W), the Loss Tool reports a semiconductor efficiency of approximately 96–97 %, with total losses around 1.5–2 W. The switching losses (blue bars) are relatively small because ZVS eliminates turn-on losses; the remaining switching losses come from turn-off transitions. MOSFET conduction losses (green bars) dominate at higher power levels.
Compared to the hand calculations in Q21–Q24, the Loss Tool yields somewhat higher losses due to the pessimistic approximation of switching energies (linearly scaled with current from datasheet values).
Regarding the trends across operating points:
- At lower input voltages, the phase shift increases, leading to higher peak and RMS currents. This raises both conduction losses and turn-off switching losses. For example, at Pout = 50 W the efficiency drops from ≈97 % at Uin = 60 V to ≈94 % at Uin = 30 V.

- At higher input voltages, the required phase shift is smaller, resulting in lower circulating currents and reduced losses, thus improving efficiency.
- At reduced output power (Pout = 10 W), the absolute losses are lower (≈1.2–2.5 W), but the efficiency drops significantly (82–89 %) because these losses represent a larger fraction of the small output power. Switching losses become the dominant loss mechanism at light load.

/ 4 pt.

NOTE: You may consider not using a heatsink for the transistor and/or diode. Nevertheless, your decision should be based on your calculations and factors considered (i.e., temperature margin).

### Q27: PRIMARY SIDE HEATSINK SELECTION

To choose a proper heatsink, answer the following questions. For the calculations, assume a maximum ambient temperature of ϑa = 40 °C, whereas the semiconductor junction temperature should not exceed ϑj = 135 °C.

NOTE: There is already a thermal resistance from the junction to the case of the semiconductor. This can be found on the MOSFETs’ data sheets.
NOTE: Since the MOSFETs have an exposed drain on the backside, a thermally conductive insulating (TIM) sheet is required for electrical isolation. The thermal resistance of the TIM sheet is assumed to be 3 °C W⁻¹
a) Considering the output of the previous questions, determine the worst case operation condition for the primary side MOSFET in terms of power losses PQ,pri∣
wc.
b) Calculate the maximum allowed heatsink thermal resistance Rth,Q,pri,c−a

(where c−a

indicates case to ambient).
c) Based on b), choose a heatsink from the selection provided in Table 3, their profile is also displayed in Fig. 18. Don’t forget to highlight your selection in blue , as in Table 2.
d) Once the heatsink is selected, give the expected maximum junction temperature.
a) Total power loss per primary MOSFET:
The worst-case operation for the primary MOSFET occurs at Uin,max where switching losses dominate.

## PQ,pri∣

wc = PC,pri + PT,off,pri = 0.32 + 0.14 = 0.47 W | (81)
b) Junction temperature without heatsink:
Assuming a direct path to ambient through the package and TIM (Rth,JA = 60 ◦ C/W, RTIM = 3

◦
C/W):

TJ = Tamb + PQ,pri∣

wc ⋅ (Rth,JA) = 40 + 0.47 × (60) = 68.05 ◦
C | (82)
Since TJ = 68.05 ◦

C < 135 ◦

C with a margin of 66.95 ◦ C, no additional heatsink is required.
c) Heatsink selection: No heatsink needed.
d) Expected maximum junction temperature: ϑj,max = 68.05 ◦ C.

## PQ,pri∣

wc = 0.47 | W | Rth,Q,pri,c−a = N/A | K W⁻¹
MOSFET heatsink model No. : N/A, not needed | ϑQ,pri,j,max= 68.05 ◦
C | / 8 pt.

### Q28: SECONDARY SIDE HEATSINK SELECTION

Similar to the primary side, a secondary side heatsink has to be selected. Assuming the same thermal constraints, answer the following questions:
NOTE: There is already a thermal resistance from the junction to the case of the semiconductor. This can be found on the MOSFETs’ data sheets.
NOTE: Since the MOSFETs have an exposed drain on the backside, a thermally conductive insulating (TIM) sheet is required for electrical isolation. The thermal resistance of the TIM sheet is assumed to be 3 °C W⁻¹
a) Considering the output of the Loss Tool, determine the worst case operation condition for the diode in terms of losses PQ,sec∣
wc.
b) Calculate the maximum allowed heatsink thermal resistance Rth,Q,sec,c−a
c) Select a suitable heatsink from the selection provided in Table 3 (this time highlight it in green ).
d) Give the expected maximum junction temperature.

a) Total power loss per secondary MOSFET:

PQ,sec∣
wc = PC,sec + PT,off,sec = 0.28 + 1.03 = 1.32 W | (83)
b) Without a heatsink (Rth,JA = 62 ◦
C/W):
TJ = 40 + 1.32 × (62) = 121.61 ◦
C | (84)
The margin is only 13.39 ◦
C, which is very small. A heatsink is added to ensure safe operation across all conditions. Maximum allowed heatsink thermal resistance (using Rth,JC = 1.11 ◦ C/W from datasheet):

Rth,c−a <

ϑj,max − ϑa
PQ,sec∣

wc

− Rth,JC − RTIM =

135 − 40
1.32 − 1.11 − 3.0 = 68.06 ◦
C/W | (85)
c) Ohmite FA-T220-25E (Rth = 4.70 ◦
C/W, No. 2) is selected, which provides sufficient margin while being compact and cost-effective.
d) Expected maximum junction temperature:

ϑj = ϑa + PQ,sec∣

wc ⋅ (Rth,JC + RTIM + Rth,hs) = 40 + 1.32 × (1.11 + 3.0 + 4.70) = 51.60 ◦
C | (86)
Margin: 135 − 51.60 = 83.40 ◦
C.

PQ,sec∣
wc = 1.32 | W | Rth,Q,sec,c−a = 68.06 | K W⁻¹
MOSFET heatsink model No. : FA-T220-25E | ϑQ,sec,j,max= 51.60 | ◦
C | / 8 pt.

Table 3 List of the offered heatsinks.
No. | Manufacturer | Product | Rth (K W⁻¹ ) | Figure
1 † | Ohmite | FA-T220-64E | 3.00 | 18a
2 † | Ohmite | FA-T220-25E | 4.70 | 18a
3 † | Ohmite | EA-T220-51E | 7.50 | 18b
4 † | Ohmite | EA-T220-38E | 10.40 | 18b
5 | Ohmite | OMNI-220-18-25-1C | 3.50 | 18b
6 † | Ohmite | OMNI-220-18-50-2C | 7.00 | 18b

†: You can use this heatsink for 2 devices.

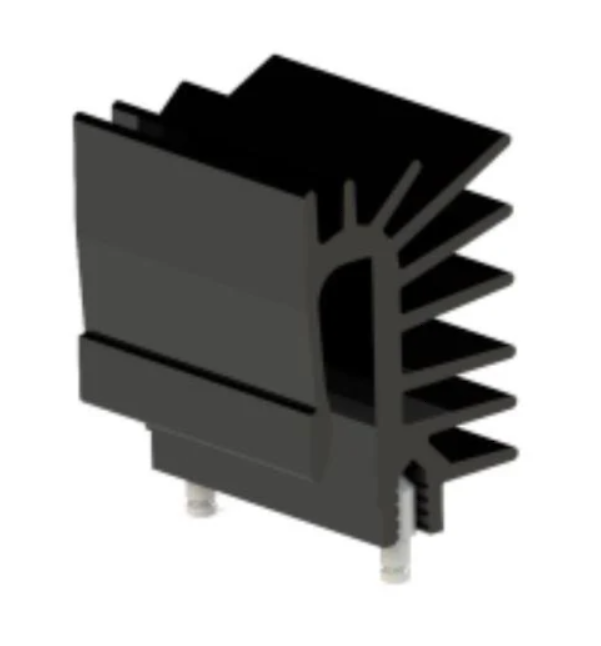
[picture p23: figure]
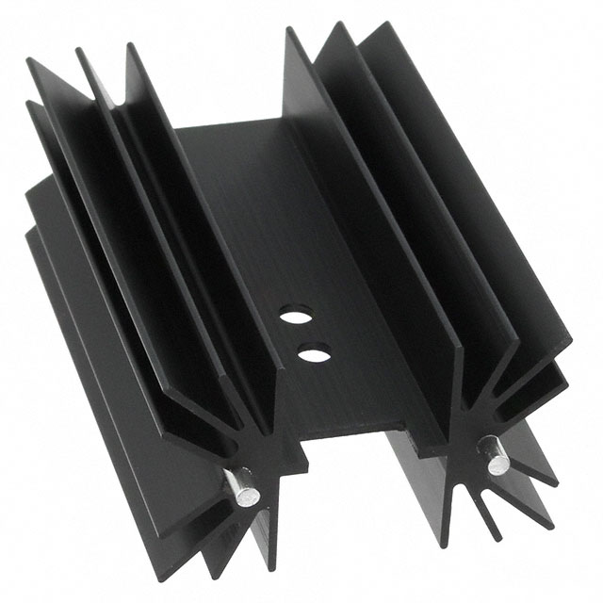
[picture p24: figure]
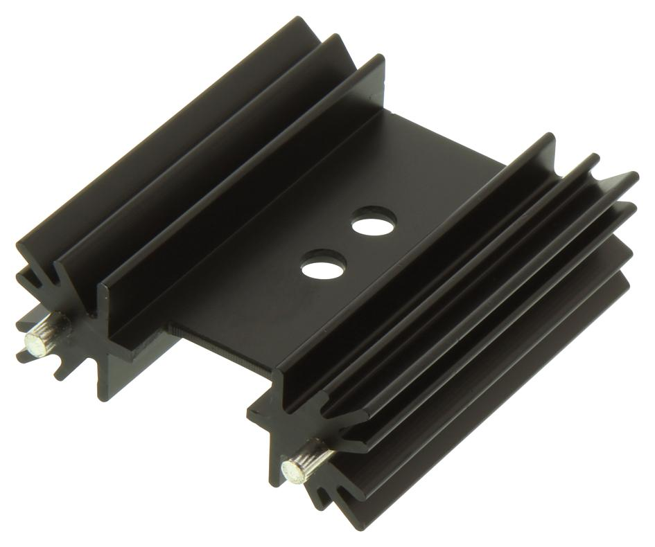
[picture p25: figure]

(a) Ohmite FA-T220-xxE | (b) Ohmite EA-T220-xxE | (c) Wakefield 693-xxx
Figure 18 Available heatsinks. Images taken from the manufacturer websites.

## REPORT 1 SUMMARY

Fill out the table below with your results as well as your chosen devices:

Table 4 Calculated parameter values, selected components and efficiency.
Property | Value | Unit
N | 4.17 | —
Cin | 700 | µF
L | 26.04 | µH
CDCBLOCK | 15.20 | µH
Cout | 152.72 | µF
Primary side MOSFET No. | PHP18NQ11T | —
Secondary side MOSFET No. | IRLB8743PbF | —
η∣ nom | 85.73 | %
Primary side MOSFET heatsink No. (if present) | | —
Secondary side MOSFET heatsink No. (if present) | Ohmite FA-T220-25E | —
Total: | / 125 pt.
