lbregy/Power-Electronics/03 - PCB/Reports/Report3_Group4_Bregy_Luo.pdf

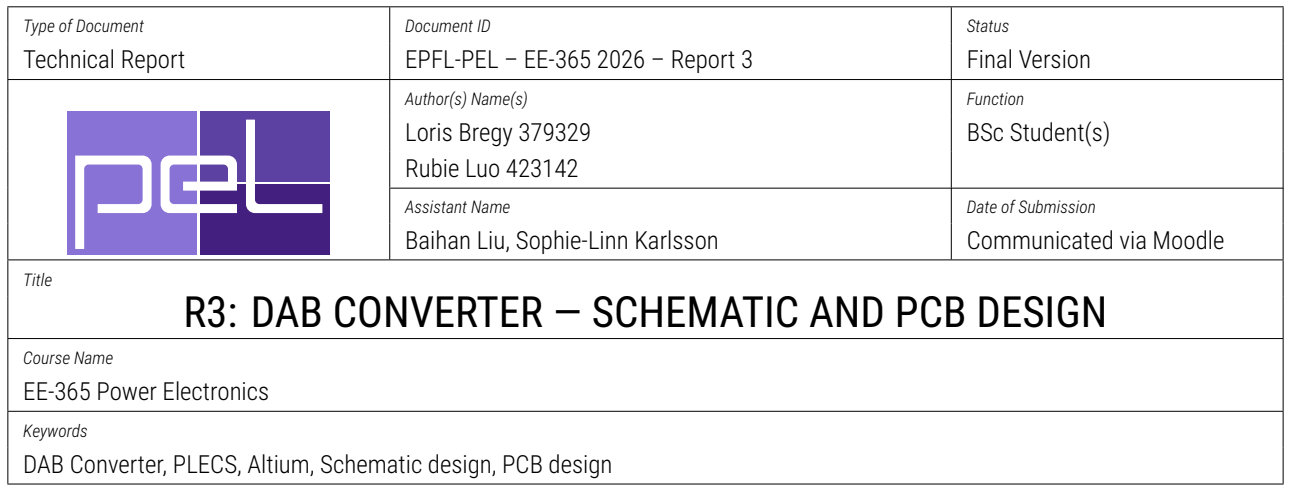
[picture p26: figure]
Title; Course Name EE-365 Power Electronics; Keywords

Type of Document Technical Report | Document ID EPFL-PEL – EE-365 2026 – Report 3 | Status Final Version
| Author(s) Name(s) Loris Bregy 379329 Rubie Luo 423142 | Function BSc Student(s)
| Assistant Name Baihan Liu, Sophie-Linn Karlsson | Date of Submission Communicated via Moodle

# R3: DAB CONVERTER — SCHEMATIC AND PCB DESIGN

DAB Converter, PLECS, Altium, Schematic design, PCB design

## TABLE OF CONTENTS

Overview | 3
Power Stage | 5

Q6: Extract the gate charge (Qg

Gate Driver on the Primary Side | 7
Gate Driver on the Secondary Side | 10
Current Measurement | 14

Voltage Measurement | 17
Power Supply for the ICs | 19
Schematic and PCB | 22
Appendix | 25

## OVERVIEW

In this third part, the project addresses the schematic and PCB design of the Dual Active Bridge (DAB) converter according to the specifications assigned to your group. Fill out Table 1 with the parameters assigned to your group. In this report, you will complete the selection of all necessary components and populate the provided schematic and PCB layout using Altium Designer. The concept of the complete schematic of the DAB converter is illustrated in Fig. 1.

The list of available SMD capacitors, SMD resistors, that can be used for your design is provided in the Appendix section. The use of components not listed in the Appendix is allowed if and only if authorized by a TA or explicitly stated in the instructions in this report.

To provide your answers and explanations, use the framed boxes below each question. In case multiple units are employed to realize the same circuit component, append additional frame boxes in the answers, and add numbers to the corresponding designators (e.g., in case of multiple parallel input capacitors, denote them as Cin,1
, Cin,2

, etc...). Please note a maximum limit of four components in series or parallel when targeting a specific design value.

A project template for Altium Designer will be provided. It should be noted that the schematic sheet has been divided into several blocks; according to the block name, you are asked to complete the placement of the components. All the used components have been included in the datasheet. Consider what follows before proceeding further:
- Before proceeding with the report, according to Fig. 1, populate the power-stage part of the schematic diagram with the components in the bottom of the schematic. For the semiconductor devices, add the part number of the selected devices in the comment of the device model.
- While proceeding from Q1 to Q40, the values of passive components should be put in the comment as well.
- While proceeding from Q1 to Q40, it is suggested to populate the schematic diagram step-by-step.

By following the steps outlined in this report, you will be able to prepare and manufacture the Dual Active Bridge (DAB) converter PCB. Note that you may need to create custom footprints for certain components. When doing so, carefully consult the component datasheets; as a general rule, ensure the pad hole diameter is 1.2 times the diameter of the component lead pins.

Note: Installation guideline of the Alitum Designer can be found in LINK. (https://wiki.epfl.ch/altium-designer)

Table 1 Given parameters and design requirements for the DAB converter.

Property | Value | Unit
Pout,nom | 50 | W
Vin,nom | 50 | V
Vin,min | 30 | V
Vin,max | 60 | V
Vout | | V
∆Vout,pp,rel | 2 | %
fsw | | kHz
Vaux,out | 18 | V
Paux,out | 5 | W

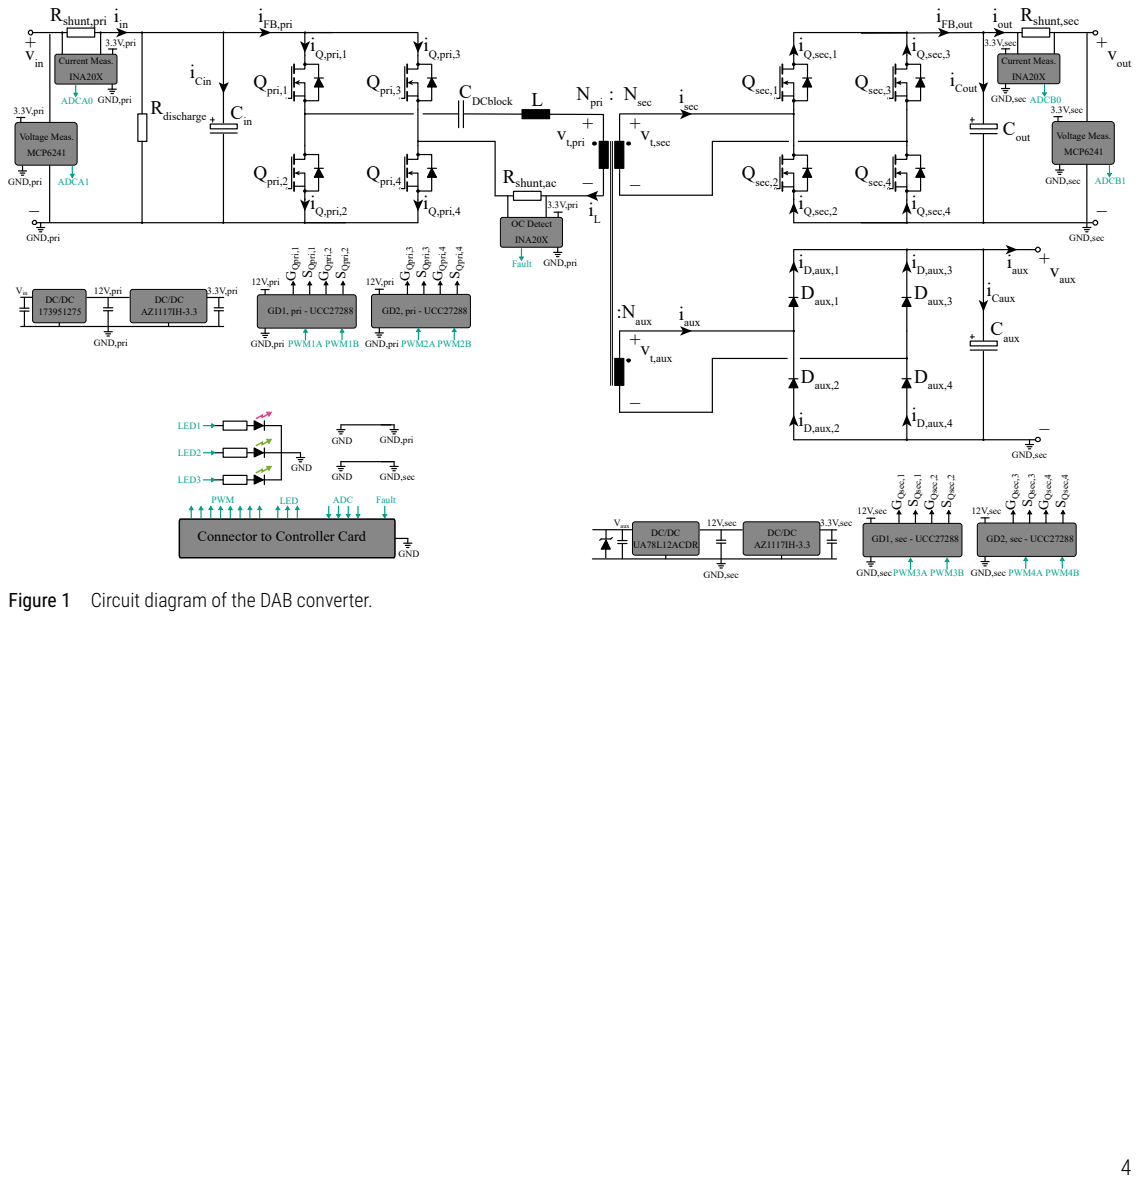
[picture p27: page 4]
Qpri,1; Qpri,2; Qpri,3; Qpri,4; Cin; Rdischarge; Q,pri,1; Q,pri,2; Q,pri,4; Qsec,1; Qsec,2; Qsec,3; Qsec,4; Q,sec,1; Q,sec,3; Q,sec,2; Q,sec,4; sec; Cout; out; CDCblock; vout; +vt,sec; + vt,pri; +vt,aux; Caux; vaux; Npri : Nsec; :Naux; Daux,1; Daux,2; Daux,3; Daux,4; D,aux,1; D,aux,3; D,aux,2; D,aux,4; aux; FB,pri; Rshunt,ac; Rshunt,sec; Q,pri,3; ADCA0; Current Meas. INA20X; GND,pri; 3.3V,pri; GD2, pri - UCC27288; GQpri,3; GQpri,4; SQpri,3; SQpri,4; 12V,pri; GND,pri PWM2A PWM2B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

FB,out Rshunt,pri
vin

Connector to Controller Card

Figure 1 Circuit diagram of the DAB converter.

## POWER STAGE

### Q1: SELECTION OF THE INPUT ELECTROLYTIC CAPACITORS

According to the calculation in Report 1, select an input electrolytic capacitor from below list (Table 2).

Table 2 Aluminum electrolytic capacitors

Part number | Capacitance | Rated Voltage DC
39D507G030FL6 | 500 uF | 30 VDC
MAL215236109E3 | 10 uF | 400 VDC
UHW2A681MHD | 680 uF | 100 VDC
Selected input electrolytic capacitor: | Cin= F | Vrated-C,in= V | / 1 pt.

### Q2: SELECTION OF THE INPUT CERAMIC CAPACITOR

Aluminum electrolytic capacitors exhibit inductive behavior at high frequencies (typically above 10 kHz) due to their Equivalent Series Inductance (ESL). This characteristic significantly diminishes their effectiveness in filtering high-frequency voltage ripples. Consequently, ceramic capacitors are commonly connected in parallel to compensate for this limitation.
The muRata GRM31CZ72A475KE11L and TDK C5750X7S2A226M280KB have been specified as potential input ceramic capacitors. However, it is crucial to account for the DC bias effect, as the effective capacitance of most ceramic capacitors drops substantially under applied voltage. Based on the requirements established in Report 1, please calculate the necessary number of parallel capacitors after verifying the capacitance-voltage characteristics in the respective datasheet.
Note: The TDK C5750X7S2A226M280KB uses a 2220 package. Since its price is eight times that of the muRata GRM31CZ72A475KE11L, please prioritize the use of the muRata component for the input capacitor bank.
Cin,ceramic,min: | F | Input capacitor part number: | Cselected,@60Vdc= F | Number of parallel capacitor: | / 2 pt.

### Q3: SELECTION OF THE INPUT DISCHARGE RESISTOR

According to the calculation in Report 1, select the input discharge resistor.

Selected input discharge resistor: | Package for input discharge resistor: | / 1 pt.

### Q4: SELECTION OF THE DC BLOCKING CAPACITOR

The muRata GRM31CZ72A475KE11L or TDK C5750X7S2A226M280KB has been specified for use as the DC-blocking capacitor. It is critical to account for the power dissipation across these components. Please consult the datasheet to determine the Equivalent Series Resistance (ESR) at your specific operating frequency. Based on this value, estimate the power loss per capacitor (assuming a parallel configuration if multiple units are used).

Capacitor part number: | ESR: | @ | KHz | Number of parallel capacitor: | Loss per capacitor: | W | / 2 pt.

### Q5: SELECTION OF THE OUTPUT CAPACITOR

According to the calculation in Report 1, select the output capacitor from the available SMD capacitor (see Appendix). Again, you need check the datasheet to get the capacitance at DC-bias voltage.
Note: It is not necessary to match the calculated value exactly, as long as the selection of the capacitance higher than the calculated value, the selection should be good. Try to use fewer capacitor here.

Please write your answer inside the frame. Keep your text explanations concise and on point. In calculations include input data and do not forget units when you substitute symbols for values.
Delete this before writing anything.

Selected output capacitor: | Number of parallel capacitor: | Cselected,@Vout= F | Vrated-C,out= V | / 2 pt.

### Q6: EXTRACT THE GATE CHARGE (Qg

### ) FOR SELECTED MOSFETS

Indicate the part number of the MOSFETs you selected in report 1. Then, check their datasheets, specifically, the graph of ”Typical Gate Charge vs.Gate-to-Source Voltage”. Extract and provide the gate charge Qg

for both primary and secondary devices when the gate-drive voltage is at 12 V, and indicate how you extracted them in the framed box.

Please write your answer inside the frame. Keep your text explanations concise and on point. In calculations include input data and do not forget units when you substitute symbols for values.
Delete this before writing anything.

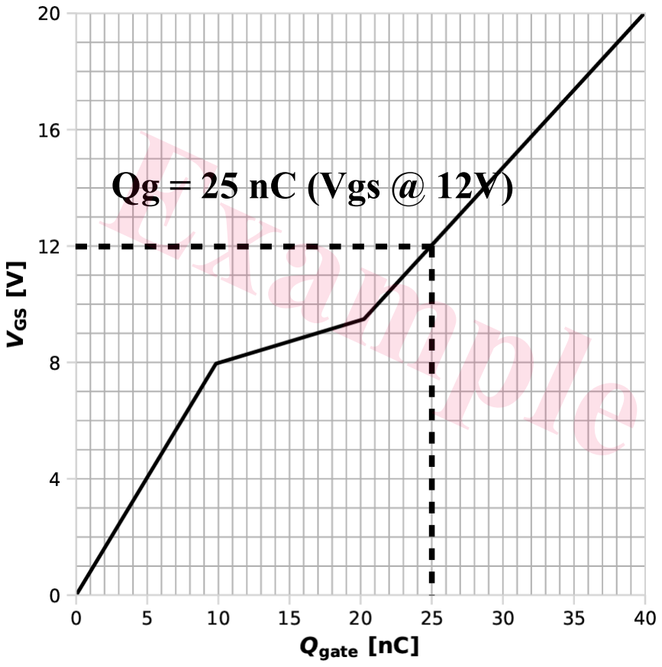
[picture p28: figure]
Qg = 25 nC (Vgs @ 12V); xample

Figure 2 Typical gate charge vs. gate-to-source voltage of primary MOSFET.

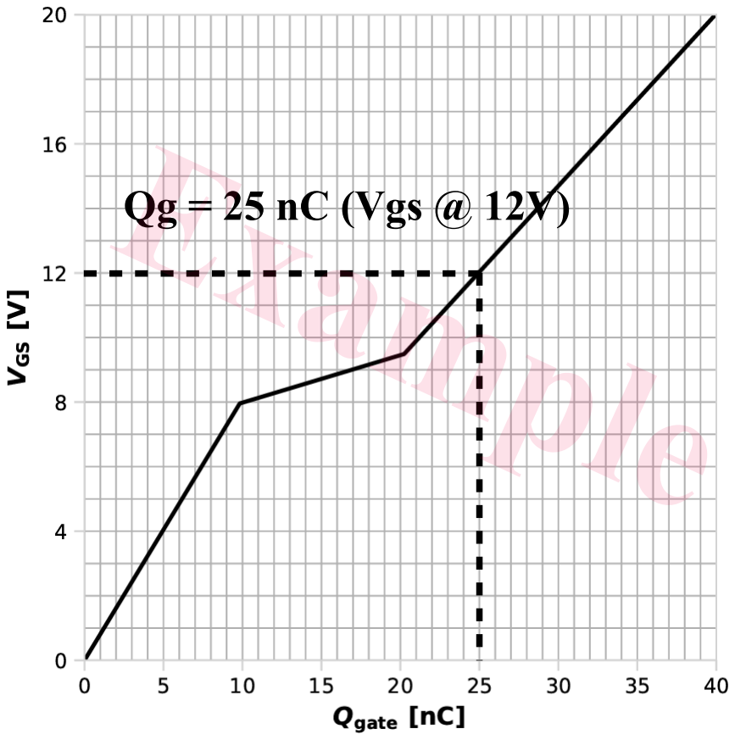
[picture p29: figure]
Qg = 25 nC (Vgs @ 12V); xample

Figure 3 Typical gate charge vs. gate-to-source voltage of secondary MOSFET.

MOSFET, pri.: | Qg,pri = | nC | MOSFET, sec.: | Qg,sec = | nC | / 1 pt.

### Q7: EXTRACT THE INTERNAL GATE RESISTANCE (Rg,int) FOR SELECTED MOSFETS

Check the datasheets of the selected MOSFETs, then extract the internal gate resistance Rg,int. Only in case the value is not provided by the manufacturer, you can assume a value of 2Ω.
Rg,int,pri = | Ω | Rg,int,sec = | Ω | / 1 pt.

## GATE DRIVER ON THE PRIMARY SIDE

There are two typical solutions to drive a half-bridge:
1. Using two single-channel gate drivers to drive two devices independently;
2. Using a dual-channel gate driver based on bootstrap technology.

The first solution provides more flexibility but usually needs an extra isolated DC power supply. In this course, a dual-channel gate driver is used. The typical circuit diagram of a half-bridge gate driver and half-bridge MOSFET is shown in Fig. 4.

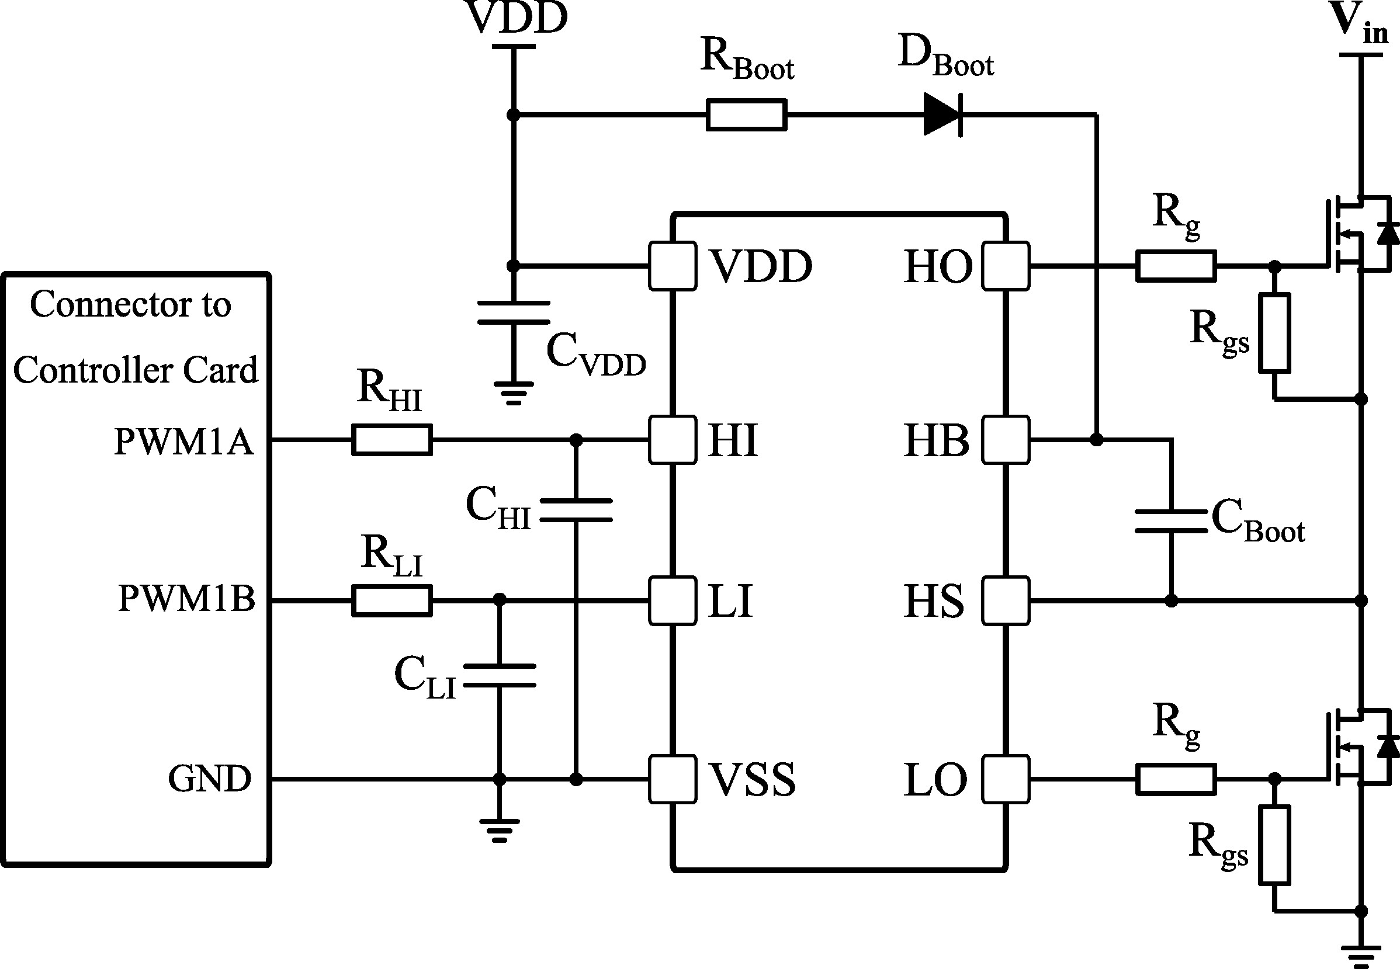
[picture p30: figure]

Figure 4 Typical application schematic of a dual-channel gate driver with bootstrap technique.

In this project, we ask you to use the half-bridge gate driver UCC27288 from Texas Instruments. Its surrounding components should be calculated and selected according to your choice of MOSFETs. In this section, follow questions Q8 to Q15 to design the primary side gate driver circuit.

Note: The datasheet of the UCC27288 provides a detailed design procedure. Read it carefully at this LINK. (https://www.ti.com/lit/ds/symlink/ucc27288.pdf) In this project, the gate driving voltage is set as 12V.

### Q8: CALCULATION OF THE BOOTSTRAP CAPACITOR

Refer to section 8.2.2.1 of the UCC27288 datasheet, and calculate the capacitance of the bootstrap capacitor following the step-by-step procedure. Report calculation procedure in the framed box, and calculated values in the answer boxes. Then, choose the closest standard capacitance value (see the Appendix), and report selected capacitor and its voltage rating in the answer boxes.
Note: In this calculation, you can consider the forward voltage drop over the diode DBoot to be 0.9 V;

Please write your answer inside the frame. Keep your text explanations concise and on point. In calculations include input data and do not forget units when you substitute symbols for values.
Delete this before writing anything.
∆VHB = | V | QTOTAL = C | Cboot,min = | F
Cboot,selected = | F | VCboot,rated = | V | / 3 pt.

### Q9: SELECTION OF THE VDD CAPACITOR

Refer to section 8.2.2.1 of the UCC27288 datasheet, and calculate the required VDD capacitor. Then, choose the closest standard capacitance value (see the Appendix). Report selected capacitor and its voltage rating in the answer boxes.

Please write your answer inside the frame. Keep your text explanations concise and on point. In calculations include input data and do not forget units when you substitute symbols for values.
Delete this before writing anything.
CVDD,selected = | F | VCVDD,rated = | V | / 2 pt.

### Q10: SELECTION OF THE BOOTSTRAP SERIES RESISTOR

The series resistance Rboot will limit the peak current at the bootstrap diode during start-up, but it should also be carefully selected as it introduces a time constant with the bootstrap capacitor given by

τ = RbootCboot. | (1)

This time constant is related to the start-up time, which influences the load dv/dt. In this project, the selected Rboot should satisfy
3RbootCboot < 10Dmin/fsw. | (2)

where Dmin is the minimal duty cycle of the low-side device during the soft start. In this project course, Dmin is set as 0.05. This will ensure that the capacitor can be charged sufficiently at the minimum duty cycle in 10 switching periods.
Additionally, the bootstrap resistor chosen must be able to withstand high power dissipation during the first charging sequence of the bootstrap capacitor. This energy and average power can be estimated by

Eboot =

1
2

CbootV

2
boot, | PR(boot) = Eboot ⋅ fsw | (3)

In this specific project course, we suggest that Rboot be in the range of 1 Ω to 10 Ω. Choose a proper package for this resistor.

Rboot = | Ω | PR(boot) = | W | / 2 pt.

### Q11: CALCULATE THE VOLTAGE STRESS AND PEAK CURRENT OVER THE BOOTSTRAP DIODE

When the high-side device is on, the bootstrap diode will be reverse-biased. The selection of the bootstrap diode should consider the voltage stress when the diode is reverse-biased, and peak current through the diode during the start-up charging.

In this project course, the diode ES2C will be used as the bootstrap diode.

VDboot,peak = | V | IDboot,peak = | A | / 1 pt.

### Q12: SELECTION OF THE EXTERNAL GATE RESISTOR

In gate drivers for high-frequency converters, parasitic inductance and parasitic capacitance can cause voltage and current oscillations on the gate of the power MOSFETs. These oscillations can cause the breakdown of the device and disturb adjacent circuits. External gate resistors are typically used to slow down the turn-on and turn-off of the devices, thus mitigating these oscillations. Refer to Section 8.2.2.4, select the external gate resistor, and calculate the source and sink current of the gate driver (the symbols are indicated in the datasheet). In this project course, we suggest that the external gate resistor is in the range of 5 Ω to 10 Ω.

Note: In the practical experimental test, you should capture waveform of the gate-source voltage. If there are obvious oscillations which may result in fault switching on, i.e., the amplitude of the oscillations higher than he turn-on threshold, the resistor should be increased.

Please write your answer inside the frame. Keep your text explanations concise and on point. In calculations include input data and do not forget units when you substitute symbols for values.
Delete this before writing anything.
Rg = | Ω | IOHH = | A | IOLH = | A | IOHL = | A | IOLL = | A | / 2 pt.

### Q13: SELECTION OF THE EXTERNAL GATE-SOURCE RESISTOR

The gate-source resistor (often called a pull-down resistor for N-channel devices) is a crucial safety component in MOSFET circuits. It prevents the MOSFET from turning on accidentally when the control signal is disconnected or undefined.
For most power electronics applications (e.g., motor drives, DC-DC converters), the standard value lies between 5 kΩ and 15 kΩ.
Rgs = | Ω | PRgs = | W | / 1 pt.

### Q14: ESTIMATE THE POWER LOSSES OF THE GATE DRIVER

Refer to section 8.2.2.3 of the datasheet to calculate the loss components in the gate driver device. Report calculation procedure in the framed box. Then, sum them to obtain the estimated total loss of the gate driver and report it below.
Note: The gate driver internal pull up/down resistor can be calculated as (8). The average value of pull-up and pull-down resistor,RGD-R, is 4.1Ω ,
High-side pull-up resistor: | RHOH = VHOH/IHO | = 0.42V/100mA = 4.2Ω
High-side pull-down resistor: | RHOL = VHOL/IHO | = 0.40V/100mA = 4.0Ω
Low-side pull-up resistor: | RLOH = VLOH/ILO | = 0.42V/100mA = 4.2Ω
Low-side pull-down resistor: | RLOL = VLOL/ILO | = 0.40V/100mA = 4.0Ω
| | | | (4)

Please write your answer inside the frame. Keep your text explanations concise and on point. In calculations include input data and do not forget units when you substitute symbols for values.
Delete this before writing anything.
Pdriver = | W | / 3 pt.

### Q15: CALCULATE MAXIMUM ALLOWED POWER DISSIPATION IN THE GATE DRIVER DEVICE

Refer to section 8.2.2.3 of the datasheet and calculate the maximum allowed power dissipation in the gate driver device. Here, the ambient temperature is set as 50℃.

Pmax = | W | / 1 pt.

## GATE DRIVER ON THE SECONDARY SIDE

As mentioned, the design of the gate driver circuit depends on the MOSFET. Therefore, the design for the gate driver on the secondary will be different from that of the primary side.

### Q16: CALCULATION OF THE BOOTSTRAP CAPACITOR

Refer to section 8.2.2.1 of the UCC27288 datasheet, and calculate the capacitance of the bootstrap capacitor following the step-by-step procedure. Report calculation procedure in the framed box, and calculated values in the answer boxes. Then, choose the closest standard capacitance value (see the Appendix), and report selected capacitor and its voltage rating in the answer boxes.
Note: In this calculation, forward voltage drop over the diode, DBoot, is about 0.9 V. VDD is 12 V.

Please write your answer inside the frame. Keep your text explanations concise and on point. In calculations include input data and do not forget units when you substitute symbols for values.
Delete this before writing anything.
∆VHB = | V | QTOTAL = C | Cboot,min = | F
Cboot,selected = | F | VCboot,rated = | V | / 3 pt.

### Q17: SELECTION OF THE VDD CAPACITOR

Refer to section 8.2.2.1 of the UCC27288 datasheet, and calculate the required VDD capacitor. Then, choose the closest standard capacitance value (see the Appendix). Report selected capacitor and its voltage rating in the answer boxes.

Please write your answer inside the frame. Keep your text explanations concise and on point. In calculations include input data and do not forget units when you substitute symbols for values.
Delete this before writing anything.
CVDD,selected = | F | VCVDD,rated = | V | / 2 pt.

### Q18: SELECTION OF THE BOOTSTRAP SERIES RESISTOR

The series resistance Rboot will limit the peak current at the bootstrap diode during start-up, but it should also be carefully selected as it introduces a time constant with the bootstrap capacitor given by

τ = RbootCboot. | (5)

This time constant is related to the start-up time, which influences the load dv/dt. In this project, the selected Rboot should satisfy
3RbootCboot < 10Dmin/fsw. | (6)

where Dmin is set to 0.05.
Additionally, the chosen bootstrap resistor must be able to withstand high power dissipation during the first charging sequence of the bootstrap capacitor. This energy and average power can be estimated by

Eboot =

1
2

CbootV

2
boot, | PR(boot) = Eboot ⋅ fsw | (7)

In this specific project course, we suggest that Rboot be in the range of 1 Ω to 10 Ω. Choose a proper package for this resistor.

Rboot = | Ω | PR(boot) = | W | / 2 pt.

### Q19: CALCULATE THE VOLTAGE STRESS AND PEAK CURRENT OVER THE BOOTSTRAP DIODE

When the high-side device is on, the bootstrap diode will be reverse-biased. The selection of the bootstrap diode should consider the voltage stress and peak current through the diode during the start-up charging.

In this project course, the ES2C diode will be used as the bootstrap diode.

VDboot,peak = | V | IDboot,peak = | A | / 1 pt.

### Q20: SELECTION OF THE EXTERNAL GATE RESISTOR

In gate drivers for high-frequency converters, parasitic inductance and parasitic capacitance can cause voltage and current oscillations on the gate of the power MOSFETs. These oscillations can cause the breakdown of the device and disturb adjacent circuits. External gate resistors are typically used to slow down the turn-on and turn-off of the devices, thus mitigating these oscillations. Refer to Section 8.2.2.4, select the external gate resistor, and calculate the source and sink current of the gate driver. In this project course, we suggest that the external gate resistor is in the range of 5 Ω to 10 Ω.

Note: In the practical experimental test, you should capture waveform of the gate-source voltage. If there are obvious oscillations which may result in fault switching on, i.e., the amplitude of the oscillations higher than he turn-on threshold, the resistor should be increased.

Please write your answer inside the frame. Keep your text explanations concise and on point. In calculations include input data and do not forget units when you substitute symbols for values.
Delete this before writing anything.
Rg = | Ω | IOHH = | A | IOLH = | A | IOHL = | A | IOLL = | A | / 2 pt.

### Q21: SELECTION OF THE EXTERNAL GATE-SOURCE RESISTOR

The gate-source resistor (often called a pull-down resistor for N-channel devices) is a crucial safety component in MOSFET circuits. It prevents the MOSFET from turning on accidentally when the control signal is disconnected or undefined.
For most power electronics applications (Motor drives, DC-DC converters), the standard value lies between 5 kΩ and 15 kΩ.
Select a reasonable resistance value Rgs and calculate the expected power dissipation PRgs.

Please write your answer inside the frame. Keep your text explanations concise and on point. In calculations include input data and do not forget units when you substitute symbols for values.
Delete this before writing anything.
Rgs = | Ω | PRgs = | W | / 1 pt.

### Q22: ESTIMATE THE POWER LOSSES OF THE GATE DRIVER

Refer to section 8.2.2.3 of the datasheet to calculate the loss components in the gate driver device. Report the calculation procedure in the framed box as outlined in the datasheet. Then, sum them to obtain the estimated total loss of the gate driver and report it below. Note: The gate driver internal pull up/down resistor can be calculated as in (8). The average value of the pull-up and pull-down

resistors, RGD-R, is 4.1 Ω since
High-side pull-up resistor: | RHOH = VHOH/IHO | = 0.42V/100mA = 4.2 Ω
High-side pull-down resistor: | RHOL = VHOL/IHO | = 0.40V/100mA = 4.0 Ω
Low-side pull-up resistor: | RLOH = VLOH/ILO | = 0.42V/100mA = 4.2 Ω
Low-side pull-down resistor: | RLOL = VLOL/ILO | = 0.40V/100mA = 4.0 Ω
| | | | (8)

Please write your answer inside the frame. Keep your text explanations concise and on point. In calculations include input data and do not forget units when you substitute symbols for values.
Delete this before writing anything.
Pdriver = | W | / 3 pt.

### Q23: CALCULATE MAXIMUM ALLOWED POWER DISSIPATION IN THE GATE DRIVER DEVICE

Refer to section 8.2.2.3 of the datasheet and calculate the maximum allowed power dissipation in the gate driver device. Here, the ambient temperature is to be set as 40℃.
Pmax = | W | / 1 pt.

### Q24: CALCULATE PWM SIGNALS LOW-PASS FILTER FOR BOTH PRIMARY AND SECONDARY SIDE

In order to filter the noise induced by the parasitic inductance and capacitance of the cable connection between the power stage and the controller, a first-order low-pass filter (LPF) is suggested, as shown in Fig. 5. To filter out the noise while maintaining the main signal intact, the cut-off frequency of the low-pass filter could be set approximately to 50 times the switching frequency. In addition, it should be considered that the maximum current that can be drawn from the circuit at the input of the low-pass filter is 2 mA (hint: the maximum current is limited by the resistor). The complex-valued transfer function is expressed as a function of frequency f in (9) (j is the imaginary unit, RLPF and CLPF are the resistor and the capacitor of the LPF, respectively). Design the low-pass filter and plot the transfer function (i.e., the Bode plot) of this filter, also indicating with vertical lines your switching frequency and the designed cut-off frequency.

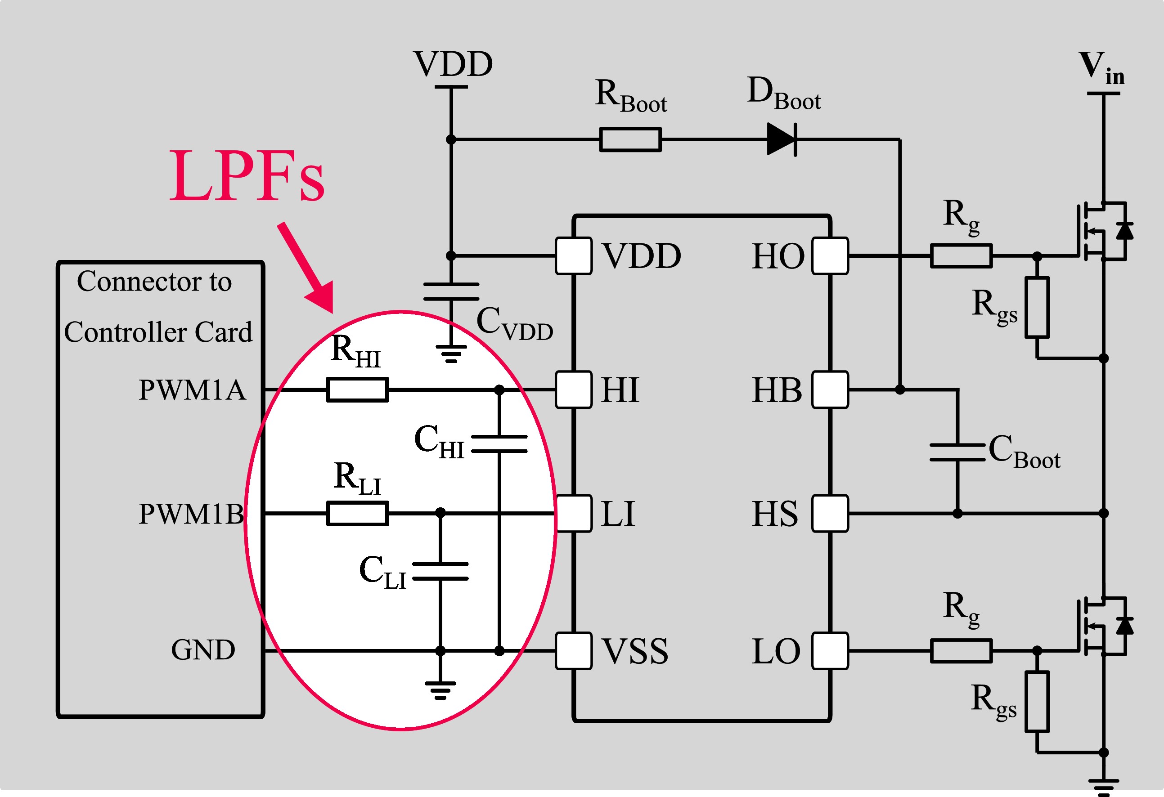
[picture p31: figure]

Figure 5 First-order low pass filters for the PWM signals.

vout,LPF(f)

vin,LPF(f)
=

1
j(2πf)RLPFCLPF + 1
(9)

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

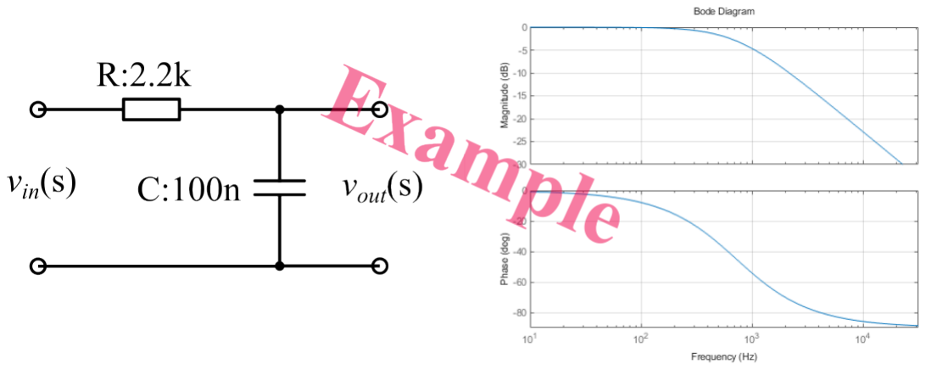
[picture p32: figure]

RHI = | Ω | CHI = | F | RLI = | Ω | CLI = | F | fcutoff = | Hz | / 2 pt.

## CURRENT MEASUREMENT

Current sensing is necessary to protect the hardware from over-current damage and to precisely control how power is delivered to the load. In this project, current sensing is used only for safety and protection via the digital controller, i.e., the digital signal processor (DSP). A sensing circuit is thus needed to convert the electrical quantity being measured into a form that the micro-controller can read. In this course, the INA201AIDR from Texas Instruments and a shunt resistor are used for current measurements. The typical circuit is shown in Fig.6. When the current amplitude needs to be acquired by the DSP, the ”OUT” pin of the IC should be connected to one of the inputs of the analog-to-digital converter (ADC) of the digital controller. In this case, the information of the amplitude of the current can be used for both control and protection purposes in the control software executed on the DSP. When only an over-current alert is needed (i.e., a digital signal for protection), the ”OUT” pin can be connected to ”CMPin” via a voltage divider, then compared with an internal 0.6 V reference through the internal comparator in the INA20X. The alert threshold can be configured using the voltage divider.

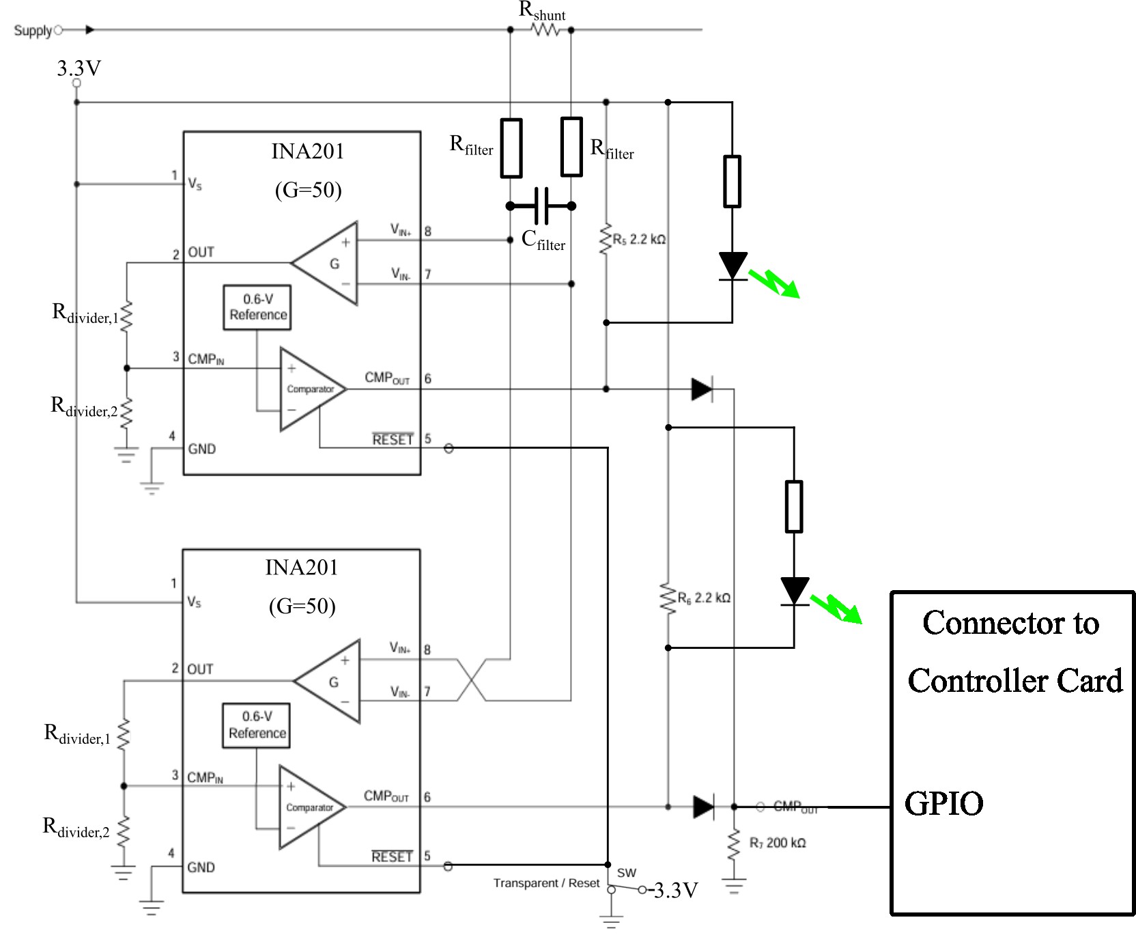
[picture p33: figure]
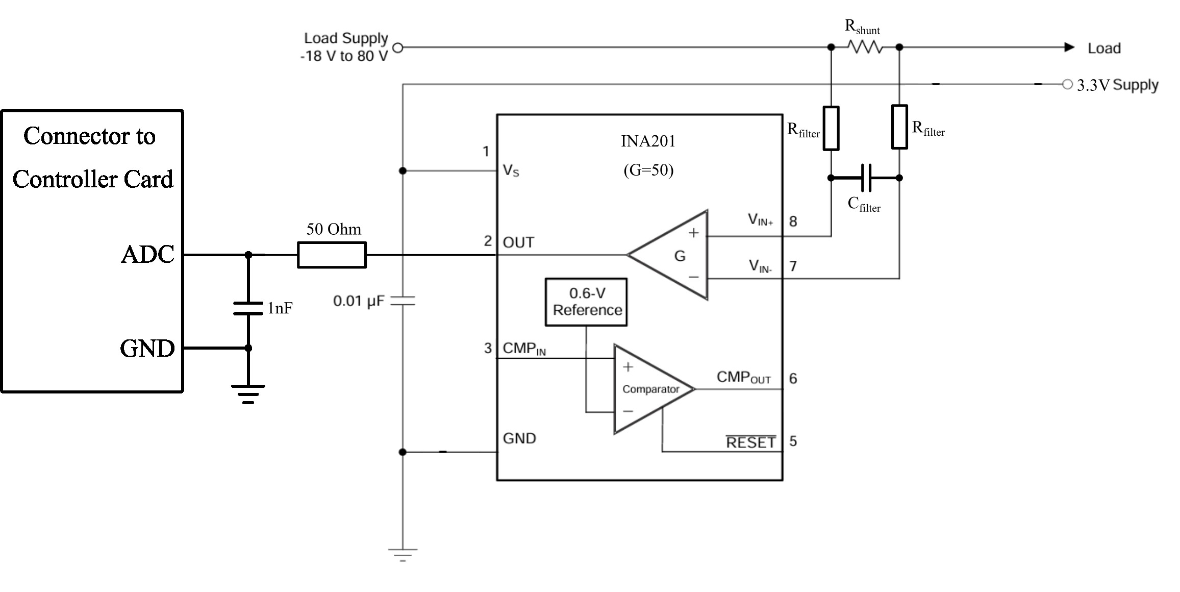
[picture p34: figure]

Figure 6 Typical application circuit of the INA201 and shunt resistor. On the left, the analog signal representing the current being measured is acquired by the digital controller (uC) through one of the analog-to-digital (ADC) inputs. On the right, the current measurement is used only for protection; therefore, the measurement is fed to the comparator through a voltage divider, and ultimately read by one of the GPIO pins (configured as a digital input) of the micro-controller.

In this project, the DC input current and output current should be sensed and measured with the digital controller, while the DAB inductor current should only be monitored to avoid over-current. This means that if an over-current event occurs in the inductor, the comparator should output a digital ”high” value and send a signal to the digital controller to shut down the PWM output.

Note: There is a detailed design example in the datasheet of the INA201. Please read it carefully at this LINK. (https://www.ti.com/lit/ds/symlink/ina200.pdf)
Note: The supply voltage for the INA201, Vs
, is set to 3.3 V.
Note: Generally, it is a good engineering practice to have the digital signals for fault detection as ”active low” (i.e., the signal is in state ”high” when the protection is not needed, while it is in state ”low” when the protection is needed). In this project, instead, we use the ”active high” logic to simplify the circuit.

### Q25: ESTIMATE COMMON MODE VOLTAGE OVER THE THE CURRENT-SENSE AMPLIFIER

Refer to Fig. 1. According to the position of the primary and secondary shunt resistors and current-sense amplifiers, estimate the common-mode (CM) voltage stress across the current-sense amplifiers at the primary and secondary side.

Note: Common-mode voltage (VCM,pri(sec)) is the average voltage present on both inputs of a differential circuit (such as an op-amp) relative to a common reference point, usually ground.

VCM,pri = | V | VCM,sec = | V | / 1 pt.

### Q26: SELECTION OF SHUNT RESISTORS

To sense the input and output current, the ”OUT” pin needs to connect to the ADC input of the digital controller. Considering that the allowable input range for the ADC of the selected digital controller ranges from 0 V to 3 V, the voltage of the ”OUT” pin should be below 3 V. Since the voltage gain of the INA201 is 50 V/V, the voltage across the shunt resistor should be below 60 mV.
To ensure that the voltage of the shunt resistors are not exceeding 50 mV, a 40% margin should be considered. Therefore, the selection of the shunt resistor should follow the equation below. The list of the available shunt resistors can be found in the Appendix.
1.4 ⋅ Rshunt,pri,max ⋅ Iin,max ≤ 60mV, | 1.4 ⋅ Rshunt,sec,max ⋅ Iout,max ≤ 60mV | (10)

This equations represent the upper bounds for the resistance values. Besides, the resistors should not be much smaller because this will reduce the voltage range representing the current signals. For sake of simplicity, the shunt resistor for the inductor current can be selected using the same criterion.
For the used digital controller, TMS320F28335, the resolution for the ADC is 12 bit. The digital value of the input analog voltage at ADC terminal can be derived by (11). And it should be noted that all fractional values are truncated. Combine the selected shunt resistor and voltage gain of the INA201, calculate the digital value (DV) get from controller for the rated input and output current, and report them in the answer boxes.

Digital Value = 2

12
⋅

Input Analog Voltage − 0
3

(11)

Please write your answer inside the frame. Keep your text explanations concise and on point. In calculations include input data and do not forget units when you substitute symbols for values.
Delete this before writing anything.
Rshunt,pri = | Ω | PRshunt,pri = | W | DVI,rate,in =
Rshunt,sec = | Ω | PRshunt,sec = | W | DVI,rate,out =
Rshunt,ac = | Ω | PRshunt,ac = | W | / 4 pt.

### Q27: FILTER DESIGN FOR INPUT AND OUTPUT CURRENT SENSING

To filter the switching frequency noise when sensing the input and output DC current, it is suggested to add a low pass filter as shown in Fig.7.

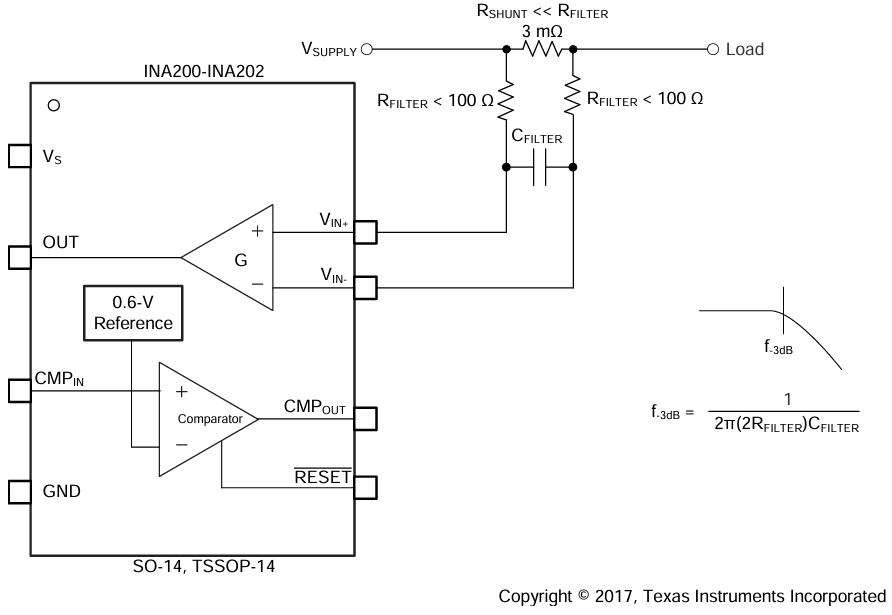
[picture p35: figure]

Figure 7 Circuit diagram of input filter applied to a component of the INA20x series.

Decide a reasonable cut-off frequency of this input filter according to the switching frequency, usually the cut-off frequency is 1/20 to 1/10 of the switching frequency, and then select the corresponding Rfilter and Cfilter.

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

fcut−off,pri = | Hz | Rfilter,pri = | Ω | Cfilter,pri = | F
fcut−off,sec = | Hz | Rfilter,sec = | Ω | Cfilter,sec = | F | / 2 pt.

### Q28: INDUCTOR CURRENT MONITORING CIRCUIT FOR PROTECTION

In this project, the current of the DAB inductor needs to be monitored. When there is an over-current fault, a digital fault signal should be generated by the current sensing circuit and sent to the digital controller to shut down the PWM.
The INA201 current-sense amplifier includes a comparator and an internal 0.6 V voltage reference. Refer to section 7.3.3 to understand the operating principle of the over-current protection.

The design of the voltage divider should consider the following equation:

IL,alert,threshold =

0.6V ⋅ (Rdivider,1 + Rdivider,2)

Rshunt,ac ⋅ Gain ⋅ Rdivider,2

, | (12)

where Gain is the voltage gain of the INA201, IL,alert,threshold is the inductor over-current threshold (which is set to 140% of the calculated maximum inductor current). Here, we suggest that Rdivider,2 is fixed to 10 kΩ. And Rdivider,1 uses a potentiometer in series with a resistor. The maximum resistance of the potentiometer is 10kOhm.

The over current detection circuit is shown in Fig. 6 (right figure). Additionally, refer to Fig. 7, adding a filter in the over current detection circuit as well. It should be noted that to keep switching-frequency information, the cut-off frequency of the low-pass filter is 20 times higher than the switching frequency. It should also be noted that the ”RESET” pin is connected to a push button, which is normally tied to 3.3V, meaning that the fault signal will be latched. To reset the signal, push the button to have the ”RESET” pin connected to ground. To protect the IC, two diodes are used in this circuit. In this project, diode ES2C is asked to be used.

Please write your answer inside the frame. Keep your text explanations concise and on point. In calculations include input data and do not forget units when you substitute symbols for values.
Delete this before writing anything.
IL,alert,threshold = | A | Rdivider-1 = | Ω | Rdivider-2 = | Ω | / 2 pt.

### Q29: CALCULATE THE CURRENT-LIMITING RESISTOR OF THE LED

Refer to the right figure in Fig. 6, a green LED in series with a resistor is connected between the ”CMPout” pin and the Vs supply pin. When the inductor current is below the alert level, the ”CMPout” pin is LOW, and the green LED will be ON to represent a normal working status. When the inductor current is above the alert threshold level, ”CMPout” pin is HIGH, and the green LED will be OFF. To limit the current through the LED, a resistor is needed.
Here is the LINK (https://www.kingbrightusa.com/images/catalog/spec/wp710a10lgd.pdf) of the datasheet of the LED. Select the proper limiting resistor to limit the current through the LED is around 2 mA. And calculate the power consumption of the LED circuit.
RLED= | Ω | PLED-circuit= | W | / 1 pt.

### Q30: ESTIMATE THE POWER CONSUMPTION OF ONE INA201-BASED SENSING CIRCUIT

Calculate the maximum power consumption of the sensing circuit as Pmax,INA201 = Vs
⋅ IQmax + Vs

⋅ Isc, where Vs
is the supply voltage,

IQmax

is the maximum quiescent current, and Isc is short circuit output current corresponding to supply voltage. Carefully extract the values for IQmax
and Isc from the datasheet based on your operating Vs
to complete the calculation.
Pmax,INA201= | W | / 2 pt.

## VOLTAGE MEASUREMENT

To sense the input and output DC voltage via the ADC of the digital controller, a voltage divider is used in this project. The voltage divider scales down the measured voltage, which is then filtered and buffered with an operational amplifier in voltage-follower configuration (i.e., unitary gain) before being connected to an ADC input of the DSP via the corresponding connector.
Fig.8 shows the typical circuit diagram of this voltage sensing circuit that will be used in this project. To protect the op-amp from over voltage, a diode is used between the position input and VCC. In this project, diode ES2C is used.

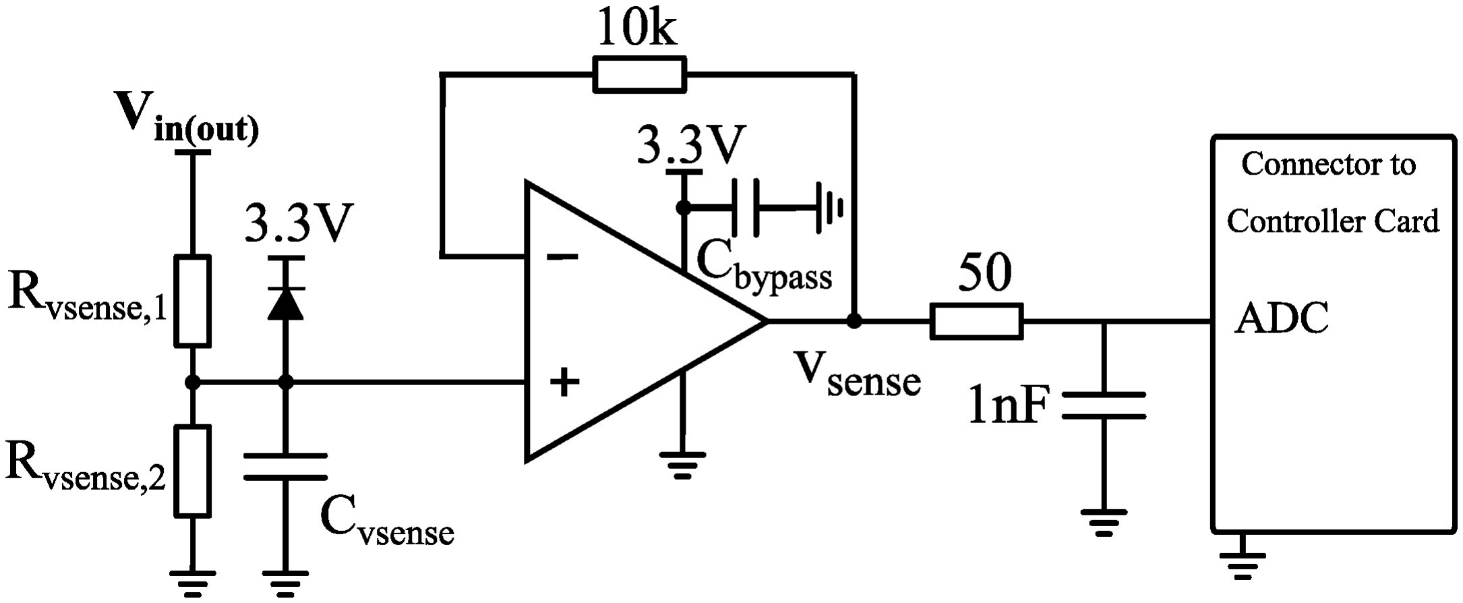
[picture p36: figure]

Figure 8 Typical DC voltage sensing circuit for the voltage Vin(out).

Note: The operational amplifier MCP6241 is used to implement the voltage follower.

### Q31: DESIGN THE VOLTAGE DIVIDER FOR INPUT VOLTAGE SENSING

Design the voltage divider in the voltage sensing circuit to ensure the voltage vsense is below 3.0 V to respect the voltage limits of the downstream circuit. In doing this, a 10% margin should be kept on the maximum voltage. This constraint is described by the equation below.

1.1Vmax

Rvsense,2
Rvsense,1 + Rvsense,2
≤ 3.0V | (13)

In addition, it should be considered that the power dissipation on the resistor should not be too high. Moreover, the design of the low-pass filter can be realized by considering a target cut-off frequency of at least 1/10 of the switching frequency, calculated as

fcut−off =

1
2πCvsense(Rvsense,1//Rvsense,2) | (14)

Report the design for the primary voltage sensing (namely, the resistance and capacitance values selected from the Appendix, and the calculated power dissipation at maximum voltage) and the range of vsense,pri considering an input voltage from 0 to 60 V. And also considering the 12bit ADC of the used controller and the designed voltage divider, calculate the voltage sensing resolution. Note: the cut-off frequency will determine the limit for the bandwidth of the control that will be implemented in the next report.

Please write your answer inside the frame. Keep your text explanations concise and on point. In calculations include input data and do not forget units when you substitute symbols for values.
Delete this before writing anything.
Rvsense,1,pri= | Ω | Pvsense,1,pri = | W | Rvsense,2,pri= | Ω | Pvsense,2,pri = | W
CVsense,pri = | F | Vsense,pri ∶ from | V | to | V | Vresolution,pri ∶ V | / 3 pt.

### Q32: DESIGN THE VOLTAGE DIVIDER FOR OUTPUT VOLTAGE SENSING

Similarly to the previous question, design the voltage divider for the output voltage sensing, and report the design values in the answer boxes. Additionally, report the Vsense,sec corresponding to Vout,rated in the answer box.

Please write your answer inside the frame. Keep your text explanations concise and on point. In calculations include input data and do not forget units when you substitute symbols for values.
Delete this before writing anything.
Rvsense,1,sec= | Ω | Pvsense,1,sec = | W | Rvsense,2,sec= | Ω | Pvsense,2,sec = | W
CVsense,sec = | F | Vsense,sec = V | / 3 pt.

### Q33: ESTIMATE THE POWER CONSUMPTION FOR THE VOLTAGE FOLLOWER

The loss of the voltage follower circuit using the MCP6241 includes two parts: static power consumption and load power. In this application, the output of the circuit is connected to the digital isolation buffer (implemented in the controller board) by a connector, where the input impedance is high; thereby, the load current from the voltage follower is negligible, and therefore the load power can be neglected.
Refer to the note in Q30, estimate the power loss for the voltage follower circuit.
PMCP6241,static = | W | / 1 pt.

## POWER SUPPLY FOR THE ICS

The gate driver, sensing circuit, and other ICs need a power supply to work. In this project, the ICs on the high-voltage input side are powered by the main input supply. The ICs on the output side are instead powered by the transformer’s auxiliary winding. However, the voltage from the main input and transformer’s auxiliary winding cannot be applied to the ICs directly because it needs to be regulated at the required value; therefore, voltage regulation circuits are needed.

### Q34: ESTIMATE POWER CONSUMPTION OF 3.3V ON THE PRIMARY AND SECONDARY SIDE

The 3.3V power supply on the primary side needs to provide power for three INA201-based sensing circuits (one for DC input current and two for inductor current monitoring), one input voltage sensing circuit and two LED lighting circuits. Please calculate the overall power consumption of these circuits at the primary side.

As for the secondary side, the voltage regulation circuit needs to drive one voltage sensing circuit and one current sensing circuit. Please calculate the overall power consumption of these circuits at the secondary side.

Please write your answer inside the frame. Keep your text explanations concise and on point. In calculations include input data and do not forget units when you substitute symbols for values.
Delete this before writing anything.
Ppri,3.3V = | W | Psec,3.3V = | W | / 2 pt.

### Q35: ESTIMATE LOAD CURRENT AND POWER CONSUMPTION OF 3.3V-LDO ON THE PRIMARY AND SECOND-ARY SIDE

To power the INA201 and operational amplifier with 3.3 V, two stage of DC-DC conversions are needed, one for the primary side and one for the secondary side. In this project, IC AZ1117IH-3.3TRG1 is asked to be used. The circuit for the use of AZ1117IH-3.3TRG1 is shown in Fig. 9. Here, one more LED is used. Combine the calculated power consumption on the 3.3V in the last question, calculate the load current of the 3.3V-LDO IC. And assuming power conversion efficiency of 60%, calculate the input power requirement for the 3.3V-LDO IC.

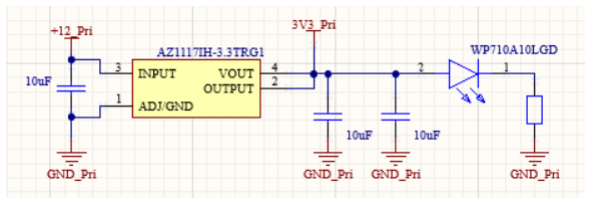
[picture p37: figure]

Figure 9 Example of the usage of the AZ1117IH-3.3TRG1 power conversion IC.

Please write your answer inside the frame. Keep your text explanations concise and on point. In calculations include input data and do not forget units when you substitute symbols for values.
Delete this before writing anything.
Ipri,3.3V = | A | Isec,3.3V = | A | Ppri,3.3V,in = | W | Isec,3.3V,in = | W | / 2 pt.

### Q36: ESTIMATE POWER CONSUMPTION OF 12V ON THE PRIMARY AND SECONDARY SIDE

The 12V power supply on the primary side needs to provide power for two gate driver circuits, one 3.3V-LDO IC which convert 12V to 3.3V, and one LED circuit. Please calculate the overall power consumption and load current of 12V power supply at the primary side.

Similarly, the 12V power supply on the secondary side needs to provide power for two gate driver circuits, one LDO circuit which converter 12V to 3.3V, and one LED circuit. Please calculate the overall power consumption and load current of 12V power supply at the secondary side.
Note: In the practical design, the selected voltage regulation IC should provide stable 12V output, and out power and current capability should be higher than the calculated values and 50% margin should be considered.

Please write your answer inside the frame. Keep your text explanations concise and on point. In calculations include input data and do not forget units when you substitute symbols for values.
Delete this before writing anything.
Ppri,12V = | W | Ipri,12V = | A | Psec,12V = | W | Isec,12V = | A | / 2 pt.

### Q37: AUXILIARY POWER SUPPLY FOR THE ICS ON THE PRIMARY SIDE

On the primary side, the power for the auxiliary circuit is taken from the main input. To efficiently regulate the main input voltage (30V-60V) to a 12 V output for the auxiliary circuits, the DC-DC module 173951275 from Würth Elektronik is used in this project. The circuit for the use of 173951275 is shown in Fig. 11. To see if this power module works properly, a LED is used here (same as before, LINK). (https://www.kingbrightusa.com/images/catalog/spec/wp710a10lgd.pdf) Calculate the LED current limiting resistor (resistance and power). Furthermore, to reduce output voltage ripple, select two appropriate capacitors from the Appendix based on the module’s datasheet requirements.

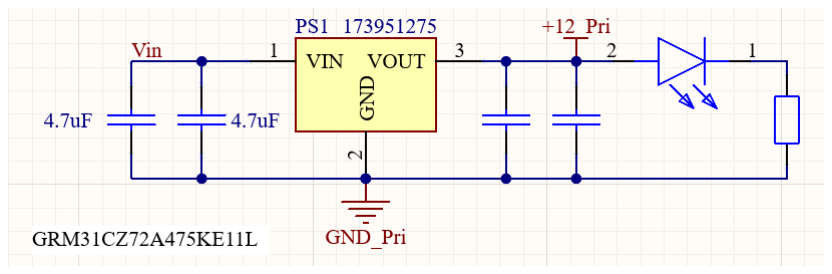
[picture p38: figure]

Figure 10 Example of the usage of the 173951275 power-conversion module.

RLED,1 = | Ω | PRLED,1 = | Ω | Cout1,Pri,12V = | F | Cout2,Pri,12V = | F | / 2 pt.

### Q38: CALCULATE MINIMUM BLOCK VOLTAGE FOR THE DIODE RECTIFIER

To power the ICs on the secondary side, an extra winding is added to the transformer, which has been designed in Report 2. The voltage from the transformer cannot be applied to the ICs directly since it is AC voltage. Therefore, a diode rectifier is needed. In this project, the full-bridge rectifier, LMB14S-TP, is asked to be used.

Using the transformer’s turns ratio get from report 2, calculate the repetitive peak reverse voltage (VRRM) across the rectifier diodes when the system is stable at the rated output voltage.

Figure 11 Example of the usage of the 173951275 power-conversion module.

VRRM = | V | / 1 pt.

### Q39: SELECTION OF CAPACITANCE FOR THE DIODE RECTIFIER CIRCUIT

To obtain a stable DC voltage after the rectifier, capacitors are needed. Assuming the voltage ripple is 1% and the load current, Iload,aux, is 0.3 A for this auxiliary circuit, calculate the filter capacitor and find the closest standard value. To protect the follower LDO IC from over voltage damage, a zener diode, 1N4750A-TR, is placed in parallel with the output.
The minimal capacitance can be calculated by

Cmin =

Iload,aux
2 ⋅ fsw ⋅ Vripple

(15)

Please write your answer inside the frame. Keep your text explanations concise and on point. In calculations include input data and do not forget units when you substitute symbols for values.
Delete this before writing anything.
Crectifier(min) = | F | Crectifier(select) = | F | Vrated−C = | V | / 1 pt.

### Q40: CALCULATE THE LOAD CURRENT FOR LDO-12V ON THE SECONDARY SIDE

On the secondary side, to regulate the output from the rectifier to 12V to power the secondary-side gate drivers, an extra LDO is needed. In this project course, the UA78L12ACDR is suggested. Refer to section 8.2 of the datasheet (LINK), (https://www.ti.com/lit/ds/symlink/ua78l.pdf) select the input and output capacitors. And check if the current capability of this IC is higher than the calculated load current on the 12-V on the secondary side.

Please write your answer inside the frame. Keep your text explanations concise and on point. In calculations include input data and do not forget units when you substitute symbols for values.
Delete this before writing anything.
CLDO-12V,in = | F | CLDO-12V,out = | F | / 1 pt.

## SCHEMATIC AND PCB

In this project, main input and output connector will be provided in the template. Below connector with a specific pin map should be used, which is the interface between the power board and controller. The connector will be provided in the Alitum Designer Template. PWM channel 1 and channel 2 should be used for the primary side; PWM channel 3 and channel 4 should be used for the secondary side; ADC A0 and A1 is used for output voltage and output current sensing. ADC A2 and A3 is used for input voltage and input current sensing. ECAP2ISO is for inductor current over current detection circuit. GPIO15ISO is connected to a red LED; CS1ISO, and CS2ISO are connected to two green LEDs. To limit the current of 2mA, resistor is needed.

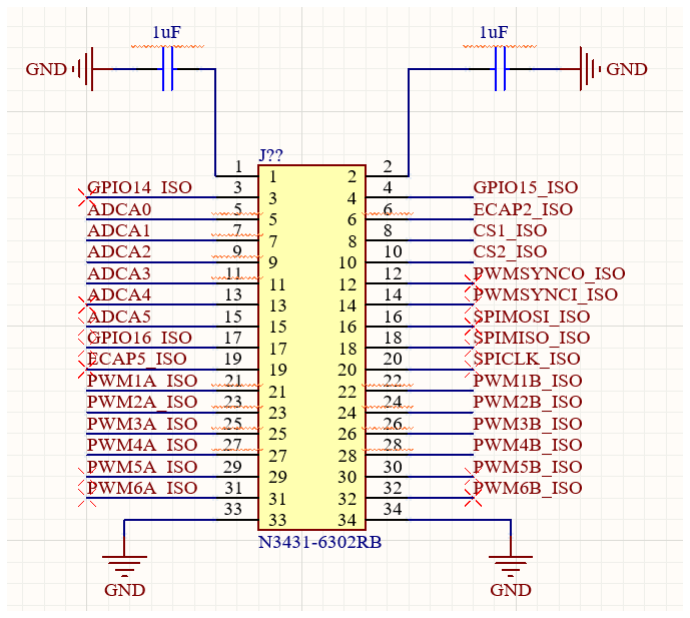
[picture p39: figure]

Figure 12 Interfacing connector between the power board and control board.

### Q41: CREATE THE FOOTPRINTS

Please design the footprints for the transformer, inductor, and input electrolytic capacitor, and then report the figures of the footprint in the framed box. Use the measurement tool to show the relevant geometric dimensions of the footprint as in the exemplary figure below.

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

/ 6 pt.

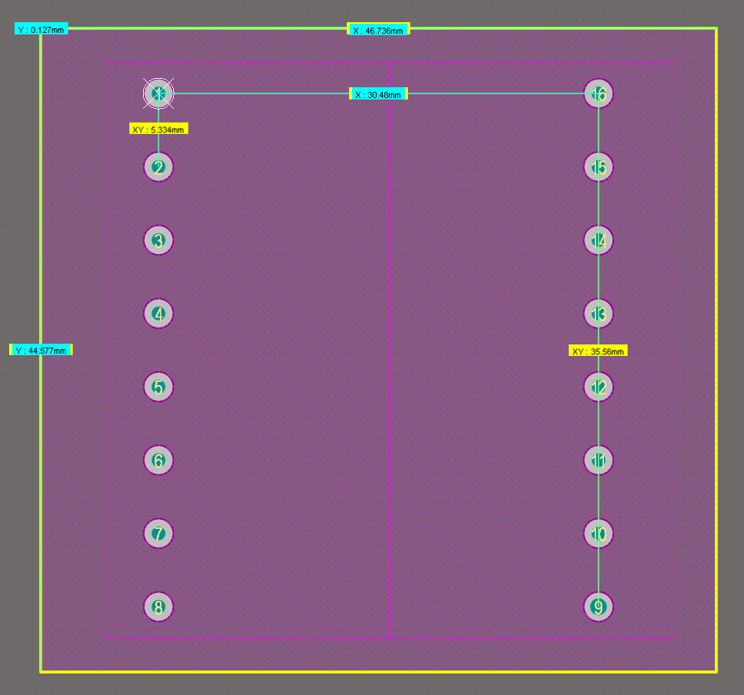
[picture p40: figure]

### Q42: SCHEMATIC LAYOUT

Follow the instructions below to finalize your Altium Designer schematic. Once complete, export the schematic as a PDF for TA review.
- Finish the connection between the components; include capacitance and resistance values in the parameters/comments, as shown in below figure.

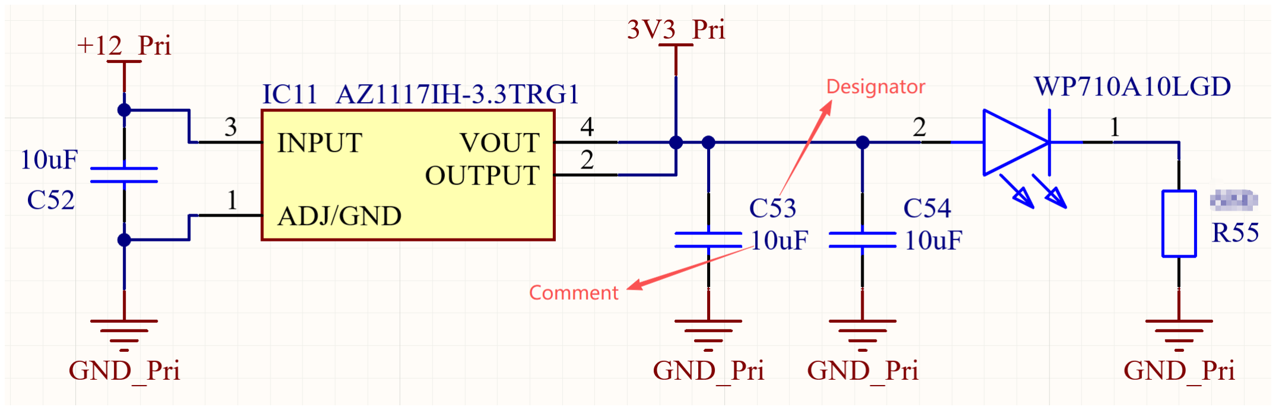
[picture p41: figure]

- Place test points in the schematic. The provided model of test point has two connection terminals, which must be connected to the desired signal and to the corresponding ground. Place Test-Points to measure the following signals:
– The drain-source voltage of all low-side devices.
– The gate-source voltage of all low-side devices.
– The voltage across the three shunt resistors.
– All PWM signals from the digital controller.
– 12V and 3.3V on the both primary and secondary side. – Auxiliary voltage (Vaux).
– Output of the inductor current monitoring circuit.
– Output of the voltage and current measurement circuit.
- Place the heatsinks for the MOSFETs. Choose the correct footprints, coherently with the models chosen in report 1. Leave their mounting connection terminals floating.
- Place 4 M3 mounting holes.
/ 5 pt.

### Q43: BILL OF MATERIALS (BOM)

With the help of the Altium Report Manager, generate the Bill of Materials (BOM) needed to build your converter and include it below. This report-type document provides a list of all the required components for design realization.

In case your design requires the use of additional components not listed in the Appendix section, highlight them and be sure to provide the following information in tabular form:
- Manufacturer Part Number;
- Supplier Part Number (e.g., Digikey, Mouser, etc...);
- Supplier Link;
- Quantity (n.b., check that the needed quantity is available in stock, and that it is possible to order the exact amount needed);
- Unit Price (in CHF);
- Total Price (in CHF).
Refer, if possible, to a single supplier for all your additional required components. The Appendix provides some constraints for the additional components that can be allowed in your design.

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

/ 2 pt.

### Q44: MINIMAL COPPER WIDTH FOR CURRENT-CARRYING TRACKS

Prior to routing your PCB, determine the minimal copper width needed for the current-carrying tracks. The copper thickness is fixed to 35 μm(1 OZ), whereas the current density is limited to 35 A/mm²
, to limit the copper temperature rise to roughly 10 degrees. Based on this information and the rated current, calculate your current-carrying track width and proceed with it for the power stage. Note: it is clear that this width must be applied only to the connections that carry high current, not to every trace in the PCB.

Please write your answer inside the frame. Keep your text explanations concise and on point. In calculations include input data and do not forget units when you substitute symbols for values.
Delete this before writing anything.
Example of the footprint
wcu,pri= | mm | wcu,sec= | mm | / 2 pt.

### Q45: PCB LAYOUT

Before manufacturing the PCB of the designed converter, it is necessary to check that the connections and component placement were done correctly. For this purpose, route your PCB, following the guidelines given below.
For this course, the PCB prototype is limited to 2 layers. It is not allowed to exceed the maximum size set by the provided template. For best performance, partition the PCB by physically grouping components:
- Power circuitry (MOSFET, inductor, input and output capacitors, input and output terminals, etc...);
- Gate driving circuit.
Looking into Link. (https://jlcpcb.com/blog/pcb-design-rules-best-practices) This guide is a technical resource for the entire design process, which covers the essential rules for schematics, layout, and manufacturing that every engineer and hobbyist needs to know for a successful design.
The rules for PCB layout has been set in the Altium Template. Auto-routing is not allowed.
Route in the following order:
- Power stage (MOSFET, diode, coupled inductor...) to have the minimum physical loop on the board, as this loop will be the source of interference.
- Auxiliary measurement and control circuits. To avoid problems that are difficult to solve later, it is strongly suggested to follow closely the layout guidelines provided in the datasheet of the integrated circuits.

You can use vias to connect tracks on the two sides of the PCB.

Place the mounting holes near the corners of the board to ensure good mechanical stability.

Verify that the heatsinks are properly aligned with the MOSFETs.

Annotate the PCB silkscreen with all the required information (e.g., connector polarities, component identifiers, etc...).

Run a design rule check in Altium Designer, and correct all the errors.

Include below a 2D and 3D view of the top and bottom layers of your final PCB layout.

Please write your answer inside the frame. Keep your text explanations concise and on point. In calculations include input data and do not forget units when you substitute symbols for values.
Delete this before writing anything.
Example of the footprint

/ 5 pt.

## APPENDIX

This section contains the list of available components that can be used in your design, and some specification requirements for additional components.

### LIST OF AVAILABLE SMD CAPACITORS

The list of available SMD Ceramic Capacitors is given in Table 4. Refer to these values for your design.
For information about the power ratings of different SMD ceramic capacitors, refer to Table 3.

Table 3 Power ratings of different SMD ceramic capacitors packages, empirically determined considering a temperature rise of 25 ◦ C rise above
the ambient temperature (Source: Johanson Dielectrics).
Package (Imperial/Metric) | 1206/3216 | 1210/3225 | 1812/4532 | 2512/6332
Power Rating | 80 mW | 200 mW | 400 mW | 900 mW

Table 4 List of available SMD Ceramic Capacitors

Manufacturer Part Number | Package | Capacitance | Tolerance | Rated
| | (Imperial/Metric) | | | (%) | Voltage (V)
KEMET | C1206C100J2GACTU | 1206/3216 | 10 | pF | ±5 | 200
KEMET | C1206C220F2GACTU | 1206/3216 | 22 | pF | ±1 | 200
KEMET | C1206C330F2GACTU | 1206/3216 | 33 | pF | ±1 | 200
KEMET | C1206C470F2GACTU | 1206/3216 | 47 | pF | ±1 | 200
KEMET | C1206C101J1GACTU | 1206/3216 | 100 | pF | ±5 | 100
KEMET | C1206C221J1GACTU | 1206/3216 | 220 | pF | ±5 | 100
KEMET | C1206C471J1GACTU | 1206/3216 | 470 | pF | ±5 | 100
KEMET | C1206C102J1GACTU | 1206/3216 | 1000 | pF | ±5 | 100
KEMET | C1206C222K1GACTU | 1206/3216 | 2200 | pF | ±10 | 100
KEMET | C1206C472K5GACTU | 1206/3216 | 4700 | pF | ±10 | 50
KEMET | C1206C222K2RACTU | 1206/3216 | 2200 | pF | ±10 | 200
KEMET | C1206C104K5RACTU | 1206/3216 | 0.1 | µF | ±10 | 50
KEMET | C1206C154K5RACTU | 1206/3216 | 0.15 | µF | ±10 | 50
KEMET | C1206C224K5RACTU | 1206/3216 | 0.22 | µF | ±10 | 50
KEMET | C1206C334K5RACTU | 1206/3216 | 0.33 | µF | ±10 | 50
KEMET | C1206C474K3RACTU | 1206/3216 | 0.47 | µF | ±10 | 25
KEMET | C1206C105K3RACTU | 1206/3216 | 1 | µF | ±10 | 25
KEMET | C1206C225K5RACTU | 1206/3216 | 2.2 | µF | ±10 | 50
KEMET | C1206C106K4RACTU | 1206/3216 | 10 | µF | ±10 | 16
KEMET | C1206C225K4PACTU | 1206/3216 | 2.2 | µF | ±10 | 16
KEMET | C1206C335K3PACTU | 1206/3216 | 3.3 | µF | ±10 | 25
KEMET | C1206C475K3PACTU | 1206/3216 | 4.7 | µF | ±10 | 25
KEMET | C1206C106K4PACTU | 1206/3216 | 10 | µF | ±10 | 16
KEMET | C1206C226M4PACTU | 1206/3216 | 22 | µF | ±20 | 16
KEMET | C1206C472J5GECTU | 1206/3216 | 4.7 | nF | ±5 | 50
KEMET | C1206C103J5RAC | 1206/3216 | 10 | nF | ±5 | 50
KEMET | C1206C223J5RACAUTO | 1206/3216 | 22 | nF | ±5 | 50
KEMET | C1206C273J5RACTU | 1206/3216 | 27 | nF | ±5 | 50
KEMET | C1206C683J1RECAUTO | 1206/3216 | 68 | nF | ±5 | 100
Murata | GRM31CZ72A475KE1 | 1206/3216 | 4.7 | uF | ±10 | 100
TDK | C5750X7S2A226M280KB | 2220/5750 | 22 | uF | ±20 | 100
TDK | CGA5L1X7R1H106K160AC 1206/3216 | 10 | uF | ±10 | 50
Vishay | MAL215097614E3 | Create footprint by your own | 1000 uF | ±20 | 25

### LIST OF AVAILABLE SMD RESISTORS

The SMD Resistors can be chosen from Table 6. This table includes both SMD resistor kits and individual resistor values. For the resistance codes of the Stackpole Electronics Kits it is possible to refer to Fig.13.

Table 5 List of available SMD Resistors (Individual and Kits).

Manufacturer | Part Number | Package | Resistance Value(s) | Tolerance | Rated
(Imperial/Metric) (Single or Kit) | (%) | Power (W)
Stackpole Electronics KIT-RMCF1206FT-02 1206/3216 | E96 values from 10 Ω to 97.6 Ω | ±1 | 0.25
Stackpole Electronics KIT-RMCF1206FT-03 1206/3216 | E96 values from 100 Ω to 976 Ω | ±1 | 0.25
Stackpole Electronics KIT-RMCF1206FT-04 1206/3216 | E96 values from 1 kΩ to 9.76 kΩ | ±1 | 0.25
Stackpole Electronics KIT-RMCF1206FT-05 1206/3216 | E96 values from 10 kΩ to 97.6 kΩ | ±1 | 0.25
Stackpole Electronics RMCF1206FT2R00 | 1206/3216 | 2 | Ω | ±1 | 0.25
Stackpole Electronics RMCF1206FT4R99 | 1206/3216 | 4.99 | Ω | ±1 | 0.25
Stackpole Electronics RMCF1206FT10R0 | 1206/3216 | 10 | Ω | ±1 | 0.25
Stackpole Electronics RMCF1206FT100R | 1206/3216 | 100 | Ω | ±1 | 0.25
Stackpole Electronics RMCF1206FT680R | 1206/3216 | 680 | Ω | ±1 | 0.25
Stackpole Electronics RMCF1206FT4K99 | 1206/3216 | 4.99K Ω | ±1 | 0.25
Stackpole Electronics RMCF1206FT10K0 | 1206/3216 | 10K | Ω | ±1 | 0.25

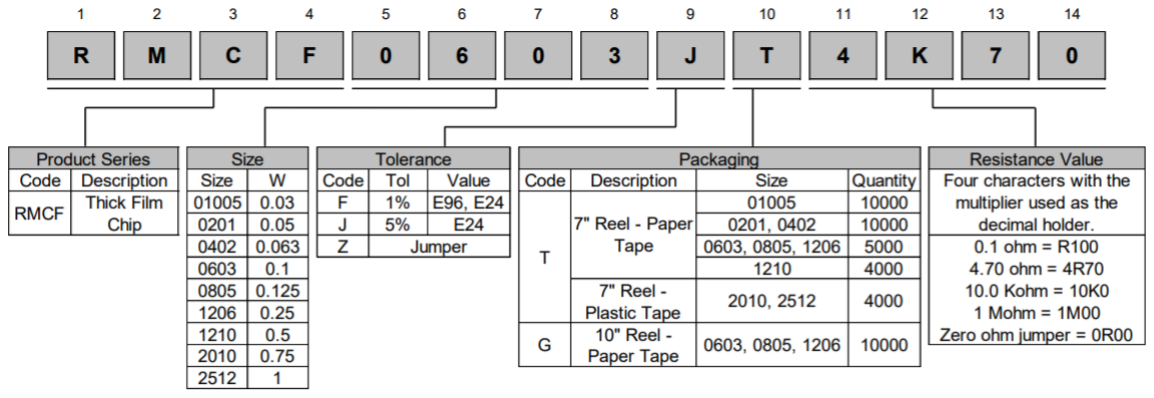
[picture p42: figure]

Figure 13 Resistor Code for Stackpole Electronics Kits.

### LIST OF AVAILABLE SHUNT RESISTORS

Table 6 List of available SMD Current-Shunt Resistors.

Manufacturer | Part Number | Package | Resistance Value | Tolerance | Rated Temperature Coefficient
(Imperial/Metric) | (%) | Power (W)
SEI Stackpole CSNL2512FT3L00 | 2512/6432 | 3 mΩ | 1% | 2 W | 50 PPM / C
SEI Stackpole CSNL2512FT4L00 | 2512/6432 | 4 mΩ | 1% | 2 W | 50 PPM / C
SEI Stackpole CSNL2512FT5L00 | 2512/6432 | 4 mΩ | 1% | 2 W | 50 PPM / C
SEI Stackpole CSNL2512FT7L00 | 2512/6432 | 7 mΩ | 1% | 2 W | 50 PPM / C
SEI Stackpole CSNL2512FT10L0 | 2512/6432 | 10 mΩ | 1% | 2 W | 50 PPM / C
SEI Stackpole CSNL2512FT15L0 | 2512/6432 | 15 mΩ | 1% | 3 W | 50 PPM / C
SEI Stackpole CSNL2512FT20L0 | 2512/6432 | 20 mΩ | 1% | 3 W | 50 PPM / C
SEI Stackpole CSNL2512FT25L0 | 2512/6432 | 25 mΩ | 1% | 3 W | 50 PPM / C
SEI Stackpole | CSNL2512FT30L0 | 2512/6432 | 30 mΩ | 1% | 3 W | 50 PPM / C
SEI Stackpole | CSNL2512FT39L0 | 2512/6432 | 39 mΩ | 1% | 3 W | 50 PPM / C
SEI Stackpole | CSNL2512FT50L0 | 2512/6432 | 50 mΩ | 1% | 3 W | 50 PPM / C

### RULES FOR ADDITIONAL COMPONENTS

Only the following components can be authorized:
- Input and Output capacitors;
- Auxiliary circuit Limiting Resistor;
- Gate Resistor.

Note also that: Additional SMD components are limited to the package 1206 or bigger;
To this purpose, the group is asked to provide in Q43 the following information in tabular form:
- Manufacturer Part Number;
- Supplier Part Number (e.g., Digikey, Mouser, etc...);
- Supplier Link;
- Quantity (n.b., check that the needed quantity is available in stock, and that it is possible to order the exact amount needed);
- Unit Price (in CHF);
- Total Price (in CHF).
Refer, if possible, to a single supplier for all your additional required components.
