lbregy/Power-Electronics/01 - Sizing/Plots /Q12-mosfet.pdf

× 1e-1
Time / s
8.26213 | 8.26214 | 8.26215 | 8.26216 | 8.26217 | 8.26218 | 8.26219 | 8.26220 | 8.26221 | 8.26222 | 8.26223 | 8.26224 | 8.26225

-1.5

-1.0

-0.5

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
FETD4Device voltage
FETD4Device current
FETD4Device gate input
