lbregy/Power-Electronics/01 - Sizing/Plots /matlab_loss.pdf

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
Uin [V] 30 | 35 | 40 | 45

5

0

5

5

6

0

Power Losses [W]

012345

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
Uin [V] 30 | 35 | 40 | 45

5

0

5

5

6

0

Efficiency 2 [%]

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
Uin [V] 30 | 35 | 40 | 45

5

0

5

5

6

0

Power Losses [W]

012345

Uin [V] 30 | 35 | 40 | 45

5

0

5

5

6

0

Efficiency 2 [%]

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
Uin [V] 30 | 35 | 40 | 45

5

0

5

5

6

0

Power Losses [W]

012345

Uin [V] 30 | 35 | 40 | 45

5

0

5

5

6

0

Efficiency 2 [%]

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
