lbregy/Power-Electronics/01 - Sizing/Plots /Q11-Vmin.pdf

0

100
V_trans_pri
V_trans_sec

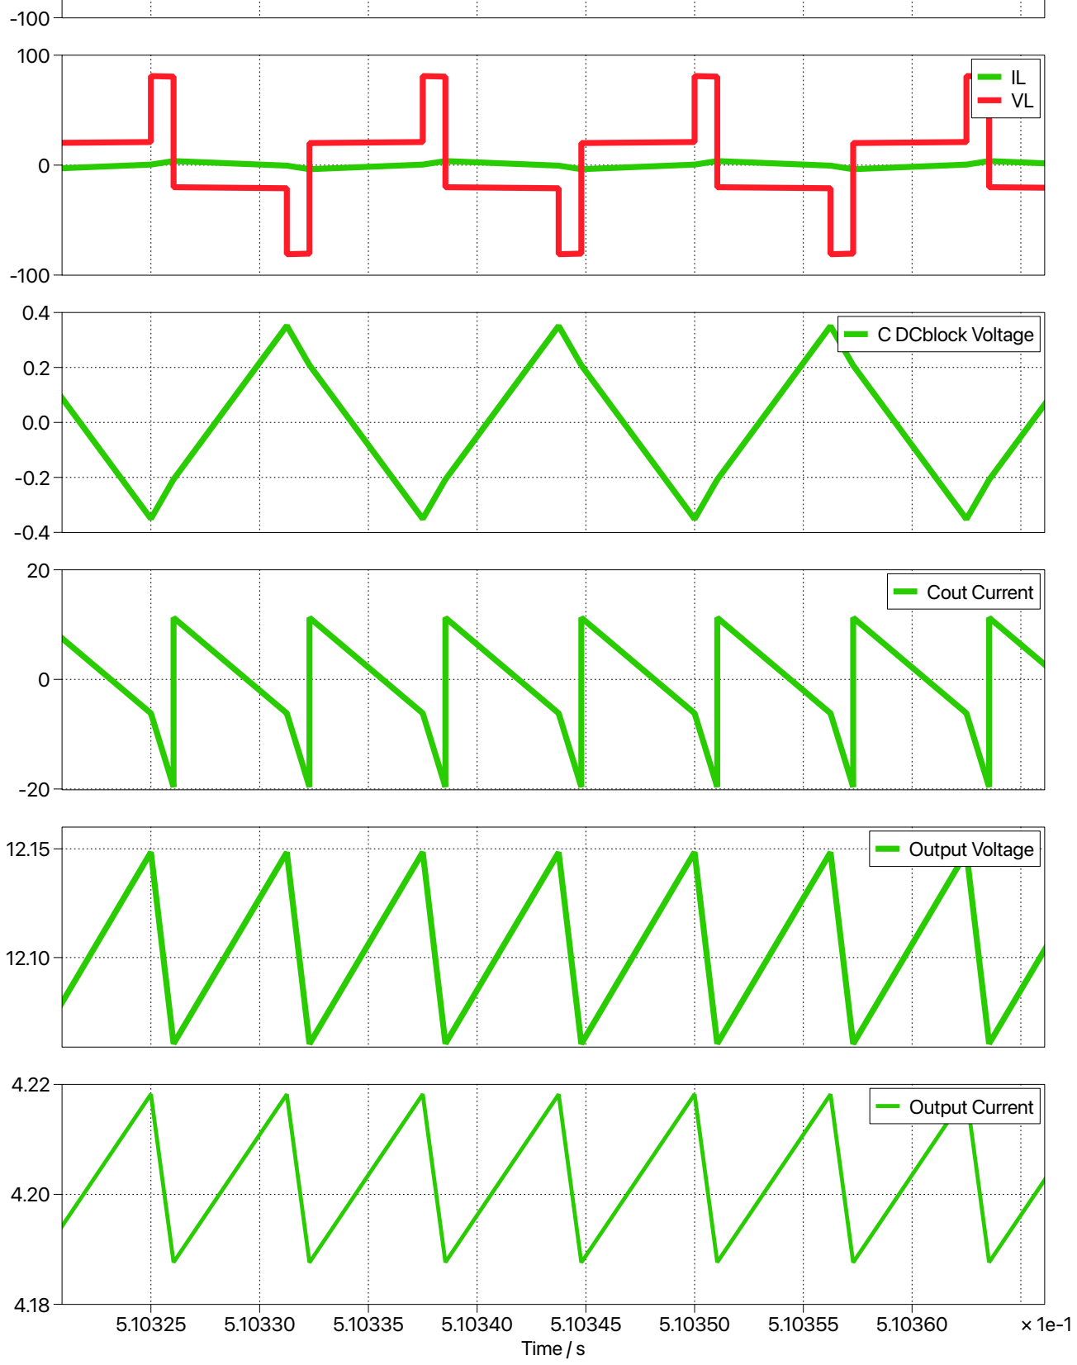
[picture p44: figure]
Time / s; C DCblock Voltage; Cout Current; Output Voltage; Output Current
