lbregy/Power-Electronics/01 - Sizing/Plots /Q12-f.pdf

× 1e-1
Time / s

7.22056 7.22058 7.22060 7.22062 7.22064 7.22066 7.22068 7.22070 7.22072 7.22074 7.22076 7.22078 7.22080 7.22082 7.22084 7.22086 7.22088

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
FETD4Device voltage
FETD4Device gate input
