lbregy/Power-Electronics/01 - Sizing/Datasheets/Rdson-pri.png

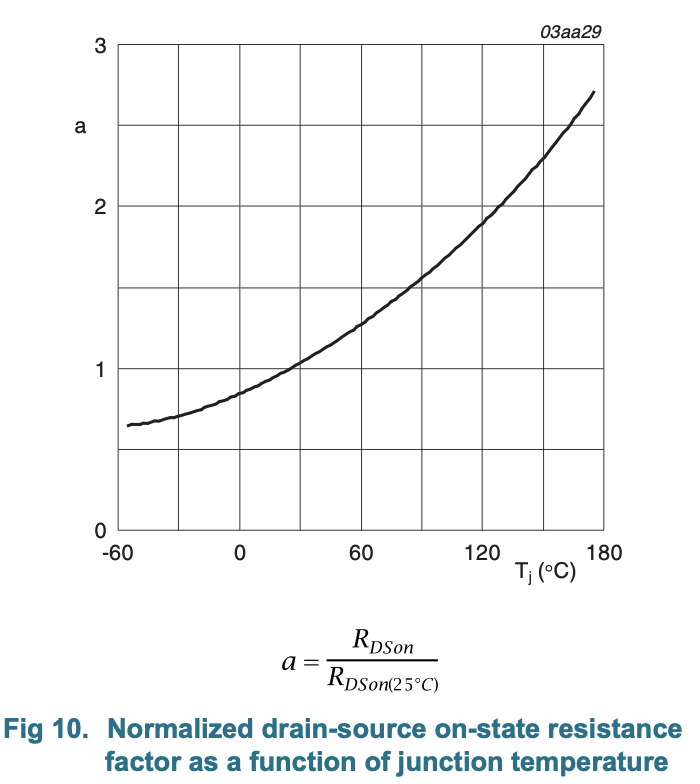
01 - Sizing/Datasheets/Rdson-pri.png
