lbregy/Power-Electronics/01 - Sizing/Datasheets/Rdson-sec.png

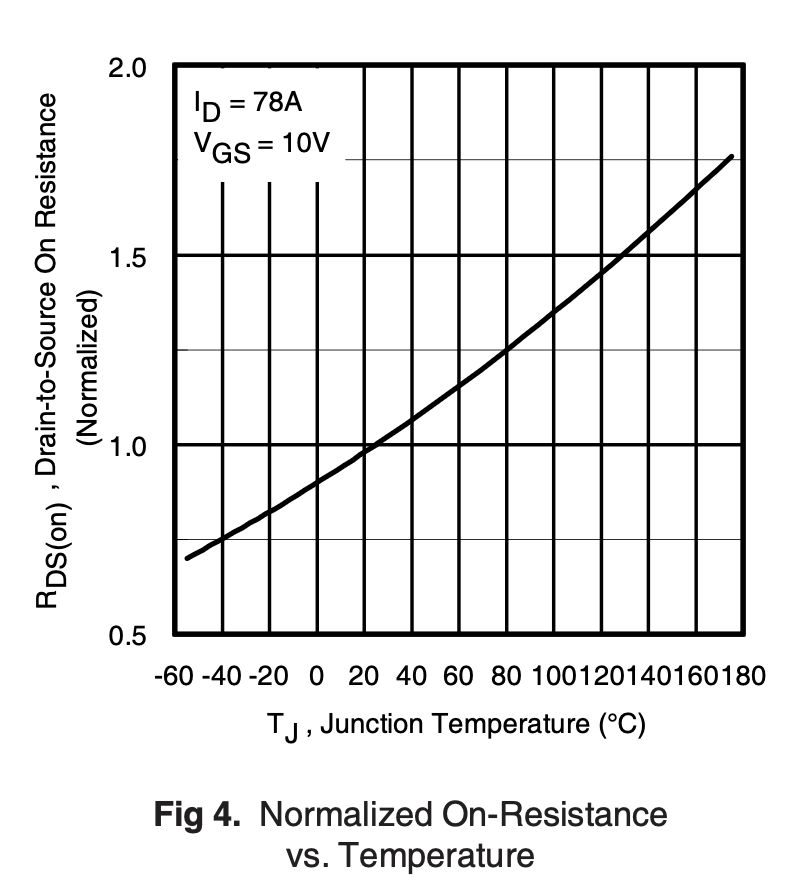
01 - Sizing/Datasheets/Rdson-sec.png
