lbregy/Power-Electronics/01 - Sizing/Plots /plotQ3.png

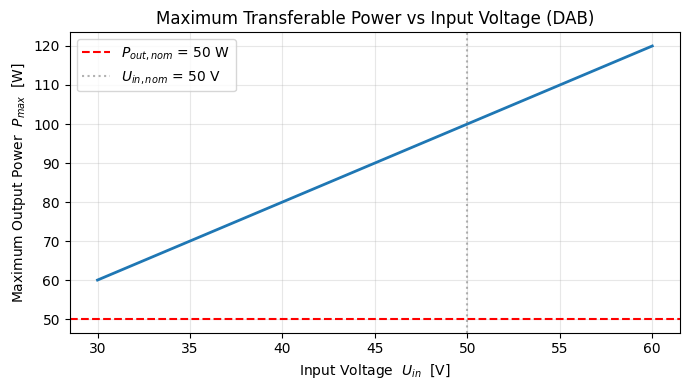
01 - Sizing/Plots /plotQ3.png
