lbregy/Power-Electronics/01 - Sizing/Plots /Q11-Vmax-measurment.png

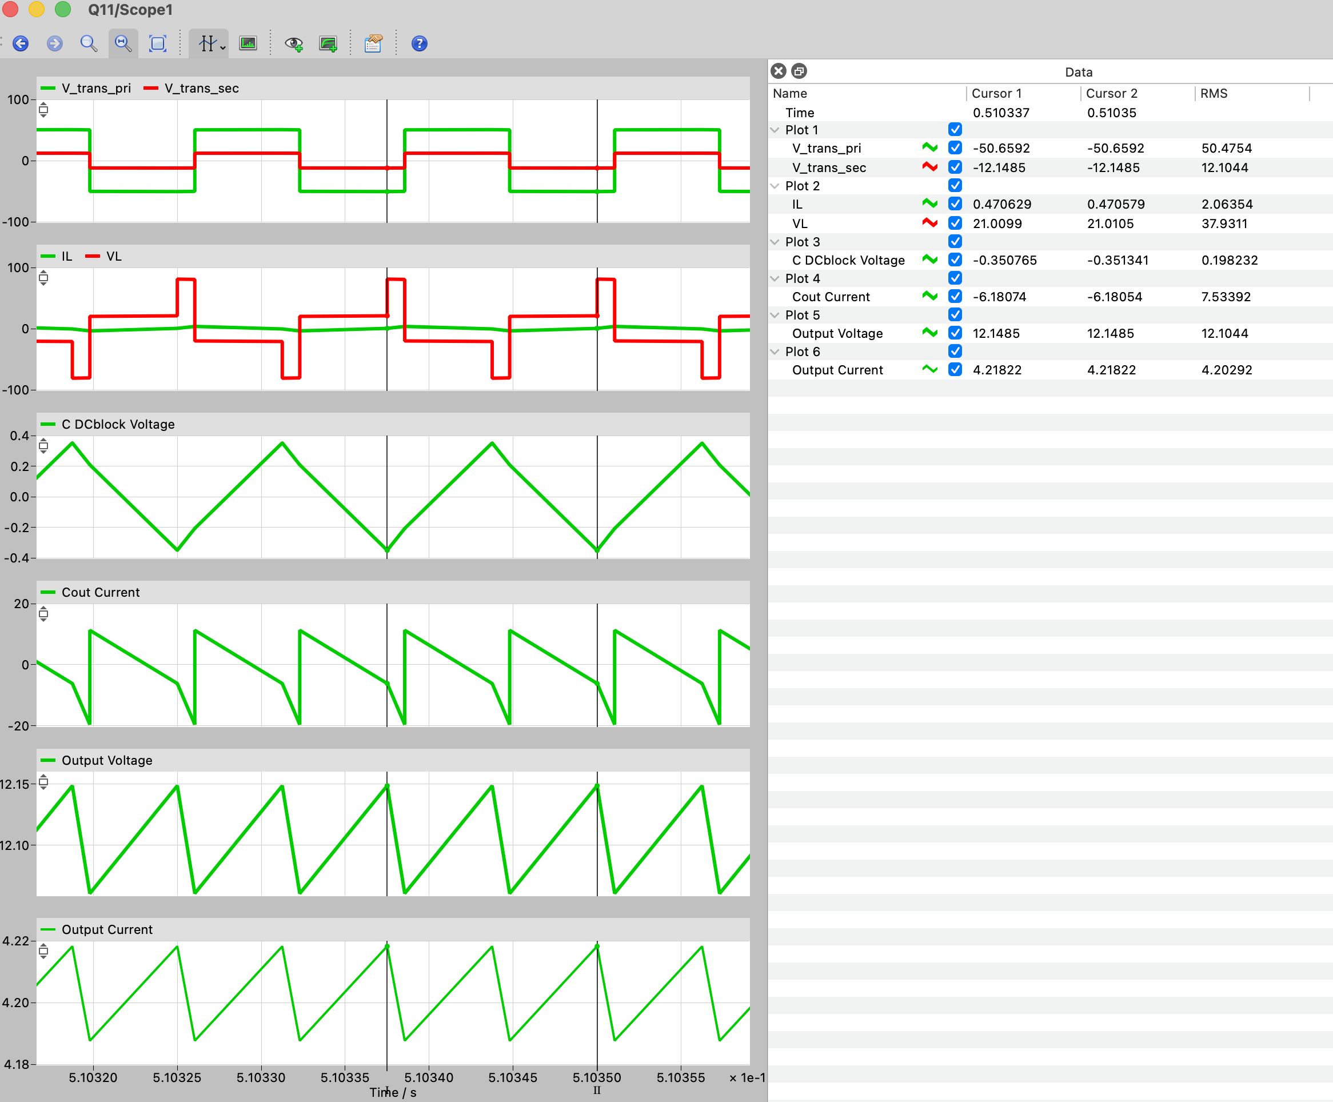
01 - Sizing/Plots /Q11-Vmax-measurment.png
