lbregy/Power-Electronics/01 - Sizing/Plots /Q11-Vmin-measurment.png

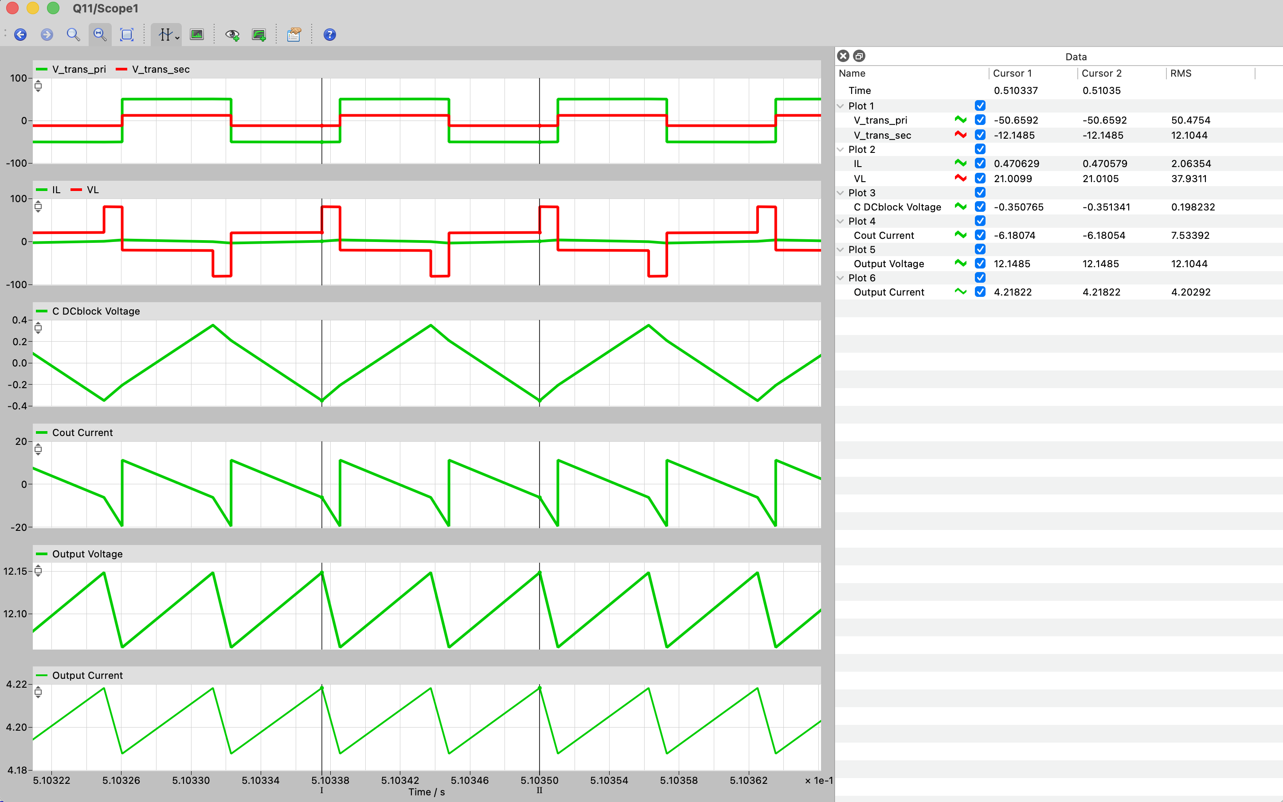
01 - Sizing/Plots /Q11-Vmin-measurment.png
