lbregy/Power-Electronics/03 - PCB/Datasheets/graph-image.png

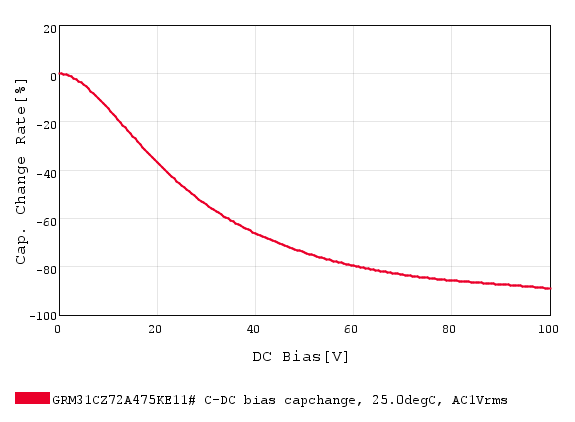
03 - PCB/Datasheets/graph-image.png
