lbregy/Power-Electronics/03 - PCB/Reports/List_of_Available_Components/List_of_Trimmers.tex

\begin{tabular}{lllllcc}
Manufacturer & Part Number  & Nominal Resistance & Tolerance (\%) & Rated Power (W) \\
\hline
Nidec Copal Electronics     & CT6EP102  & 1 kΩ  & ±10           & 0.5 \\
Nidec Copal Electronics     & CT6EP502  & 5 kΩ  & ±10           & 0.5 \\
\hline
\end{tabular}
