lbregy/Power-Electronics/03 - PCB/Reports/List_of_Available_Components/List_of_Cap_2.tex

\begin{tabular}{lllllcc}
Manufacturer & Part Number      & Package & \multicolumn{2}{l}{Capacitance} & Tolerance & Rated  \\
 & & (Imperial/Metric) &  & & (\%) & Voltage (V) \\
\hline
KEMET & C1206C100J1GAC     & 1206/3216 & 10  & pF & ±5  & 100 \\
KEMET & C1206C120J5GACTU   & 1206/3216 & 12  & pF & ±5  & 50  \\
KEMET & C1206C150J5GAC7800 & 1206/3216 & 15  & pF & ±5  & 50  \\
KEMET & C1206C180J5GAC     & 1206/3216 & 18  & pF & ±5  & 50  \\
KEMET & C1206C220J5GAC7800 & 1206/3216 & 22  & pF & ±5  & 50  \\
KEMET & C1206C270J5GACTU   & 1206/3216 & 27  & pF & ±5  & 50  \\
KEMET & C1206C330J5GAC7800 & 1206/3216 & 33  & pF & ±5  & 50  \\
KEMET & C1206C390J5GACTU   & 1206/3216 & 39  & pF & ±5  & 50  \\
KEMET & C1206C470J5GAC7800 & 1206/3216 & 47  & pF & ±5  & 50  \\
KEMET & C1206C560J5GACTU   & 1206/3216 & 56  & pF & ±5  & 50  \\
KEMET & C1206C680K5GACTU   & 1206/3216 & 68  & pF & ±10 & 50  \\
KEMET & C1206C820J1GACTU   & 1206/3216 & 82  & pF & ±5  & 100 \\
KEMET & C1206C101J1GAC7210 & 1206/3216 & 100 & pF & ±5  & 100 \\
KEMET & C1206C121K5GACTU   & 1206/3216 & 120 & pF & ±10 & 50  \\
KEMET & C1206C151J5GAC7800 & 1206/3216 & 150 & pF & ±5  & 50  \\
KEMET & C1206C181J5GACTU   & 1206/3216 & 180 & pF & ±5  & 50  \\
KEMET & C1206C221J5GACTU   & 1206/3216 & 220 & pF & ±5  & 50  \\
KEMET & C1206C271K5GACTU   & 1206/3216 & 270 & pF & ±10 & 50  \\
KEMET & C1206C331J5GAC7800 & 1206/3216 & 330 & pF & ±5  & 50  \\
KEMET & C1206C391J5GACTU   & 1206/3216 & 390 & pF & ±5  & 50  \\
KEMET & C1206C471J5GAC     & 1206/3216 & 470 & pF & ±5  & 50  \\
KEMET & C1206C561J5GACTU   & 1206/3216 & 560 & pF & ±5  & 50  \\
KEMET & C1206C681J5GACTU   & 1206/3216 & 680 & pF & ±5  & 50  \\
KEMET & C1206C821J5GAC7800 & 1206/3216 & 820 & pF & ±5  & 50  \\
KEMET & C1206C102J5GAC7800 & 1206/3216 & 1   & nF & ±5  & 50  \\
KEMET & C1206C122J1GACTU   & 1206/3216 & 1.2 & nF & ±5  & 100 \\
KEMET & C1206C152K5GACTU   & 1206/3216 & 1.5 & nF & ±10 & 50  \\
KEMET & C1206C182J5GACTU   & 1206/3216 & 1.8 & nF & ±5  & 50  \\
KEMET & C1206C222K5GEC7210 & 1206/3216 & 2.2 & nF & ±10 & 50  \\
KEMET & C1206C272J5GACTU   & 1206/3216 & 2.7 & nF & ±5  & 50  \\
KEMET & C1206C332J5GACTU   & 1206/3216 & 3.3 & nF & ±5  & 50  \\
KEMET & C1206C392JAGACAUTO & 1206/3216 & 3.9 & nF & ±5  & 250 \\
KEMET & C1206C472J5GECTU   & 1206/3216 & 4.7 & nF & ±5  & 50  \\
KEMET & C1206C562JCGACAUTO & 1206/3216 & 5.6 & nF & ±5  & 500 \\
KEMET & C1206C682JCGACAUTO & 1206/3216 & 6.8 & nF & ±5  & 500 \\
KEMET & C1206C822JBGACTU   & 1206/3216 & 8.2 & nF & ±5  & 630 \\
KEMET & C1206S103J5RACAUTO & 1206/3216 & 10  & nF & ±5  & 50  \\
KEMET & C1206C123J5RACTU   & 1206/3216 & 12  & nF & ±5  & 50  \\
KEMET & C1206C153J5RACTU   & 1206/3216 & 15  & nF & ±5  & 50  \\
KEMET & C1206C183J5RACTU   & 1206/3216 & 18  & nF & ±5  & 50  \\
KEMET & C1206C223J5RACAUTO & 1206/3216 & 22  & nF & ±5  & 50  \\
KEMET & C1206C273J5RACTU   & 1206/3216 & 27  & nF & ±5  & 50  \\
KEMET & C1206C333J2RECTU   & 1206/3216 & 33  & nF & ±5  & 200 \\
KEMET & C1206C393JARACTU   & 1206/3216 & 39  & nF & ±5  & 250 \\
KEMET & C1206X473JARECTU   & 1206/3216 & 47  & nF & ±5  & 250 \\
KEMET & C1206C473J1RECAUTO & 1206/3216 & 47  & nF & ±5  & 100 \\
KEMET & C1206C563K5RACTU   & 1206/3216 & 56  & nF & ±10 & 50  \\
KEMET & C1206C683J1RECAUTO & 1206/3216 & 68  & nF & ±5  & 100 \\
KEMET & C1206C823J5RACTU   & 1206/3216 & 82  & nF & ±5  & 50 \\
\hline
\end{tabular}
