lbregy/Power-Electronics/03 - PCB/Reports/List_of_Available_Components/List_of_Res.tex

\begin{tabular}{lllllcc}
Manufacturer & Part Number      & Package & \multicolumn{2}{l}{Resistance Value(s)} & Tolerance  & Rated  \\
 & & (Imperial/Metric) & \multicolumn{2}{l}{(Single or Kit)} & (\%) & Power (W) \\
\hline
Stackpole Electronics        & KIT-RMCF1206FT-02 & 1206/3216              & \multicolumn{2}{l}{\textbf{E96 values} from \SI{10}{\ohm} to \SI{97.6}{\ohm}} & ±1 & 0.25    \\
Stackpole Electronics        & KIT-RMCF1206FT-03 & 1206/3216              & \multicolumn{2}{l}{\textbf{E96 values} from \SI{100}{\ohm} to \SI{976}{\ohm}} & ±1 & 0.25    \\
Stackpole Electronics        & KIT-RMCF1206FT-04 & 1206/3216              & \multicolumn{2}{l}{\textbf{E96 values} from \SI{1}{\kilo\ohm} to \SI{9.76}{\kilo\ohm}} & ±1 & 0.25    \\
Stackpole Electronics        & KIT-RMCF1206FT-05 & 1206/3216              & \multicolumn{2}{l}{\textbf{E96 values} from \SI{10}{\kilo\ohm} to \SI{97.6}{\kilo\ohm}} & ±1 & 0.25    \\
\hline
Stackpole Electronics        & RMCF1206FT2R00   & 1206/3216                 & 2            & Ω            & ±1           & 0.25               \\
Stackpole Electronics        & RMCF1206FT4R99   & 1206/3216                 & 4.99             & Ω            & ±1           & 0.25               \\
Stackpole Electronics        & RMCF1206FT10R0   & 1206/3216                 & 10              & Ω            & ±1           & 0.25               \\
Stackpole Electronics        & RMCF1206FT100R   & 1206/3216                 & 100              & Ω            & ±1           & 0.25               \\
Stackpole Electronics        & RMCF1206FT680R   & 1206/3216                 & 680              & Ω            & ±1           & 0.25               \\
Stackpole Electronics        & RMCF1206FT4K99   & 1206/3216                 & 4.99K              & Ω            & ±1           & 0.25               \\
Stackpole Electronics        & RMCF1206FT10K0   & 1206/3216                 & 10K              & Ω            & ±1           & 0.25               \\
\hline
\end{tabular}
