lbregy/Power-Electronics/03 - PCB/Reports/List_of_Available_Components/List_of_Shunt.tex

\begin{tabular}{lllllccc}
Manufacturer & Part Number  & Package & \multicolumn{2}{l}{Resistance Value} & Tolerance  & Rated  & Temperature Coefficient\\
 & & (Imperial/Metric) &  & (\%) & Power (W) & \\
\hline
SEI Stackpole\quad & CSNL2512FT3L00\quad  & 2512/6432\quad  & 3 m$\Omega$ && 1\% & 2 W & 50 PPM / C \\ \hline
SEI Stackpole\quad & CSNL2512FT4L00\quad  & 2512/6432\quad  & 4 m$\Omega$ && 1\% & 2 W & 50 PPM / C \\ \hline
SEI Stackpole\quad & CSNL2512FT5L00\quad  & 2512/6432\quad  & 4 m$\Omega$ && 1\% & 2 W & 50 PPM / C \\ \hline
SEI Stackpole\quad & CSNL2512FT7L00\quad  & 2512/6432\quad  & 7 m$\Omega$ && 1\% & 2 W & 50 PPM / C \\ \hline
SEI Stackpole\quad & CSNL2512FT10L0\quad  & 2512/6432\quad  & 10 m$\Omega$ && 1\% & 2 W & 50 PPM / C \\ \hline
SEI Stackpole\quad & CSNL2512FT15L0\quad  & 2512/6432\quad  & 15 m$\Omega$ && 1\% & 3 W & 50 PPM / C \\ \hline
SEI Stackpole\quad & CSNL2512FT20L0\quad  & 2512/6432\quad  & 20 m$\Omega$ && 1\% & 3 W & 50 PPM / C \\ \hline
SEI Stackpole\quad & CSNL2512FT25L0\quad  & 2512/6432\quad  & 25 m$\Omega$ && 1\% & 3 W & 50 PPM / C \\ \hline
SEI Stackpole\quad & CSNL2512FT30L0\quad  & 2512/6432\quad  & 30 m$\Omega$ && 1\% & 3 W & 50 PPM / C \\ \hline
SEI Stackpole\quad & CSNL2512FT39L0\quad  & 2512/6432\quad  & 39 m$\Omega$ && 1\% & 3 W & 50 PPM / C \\ \hline
SEI Stackpole\quad & CSNL2512FT50L0\quad  & 2512/6432\quad  & 50 m$\Omega$ && 1\% & 3 W & 50 PPM / C \\ \hline
\end{tabular}
