lbregy/Power-Electronics/03 - PCB/DAB_PCB/DAB_lib/3d/inductor-core.step

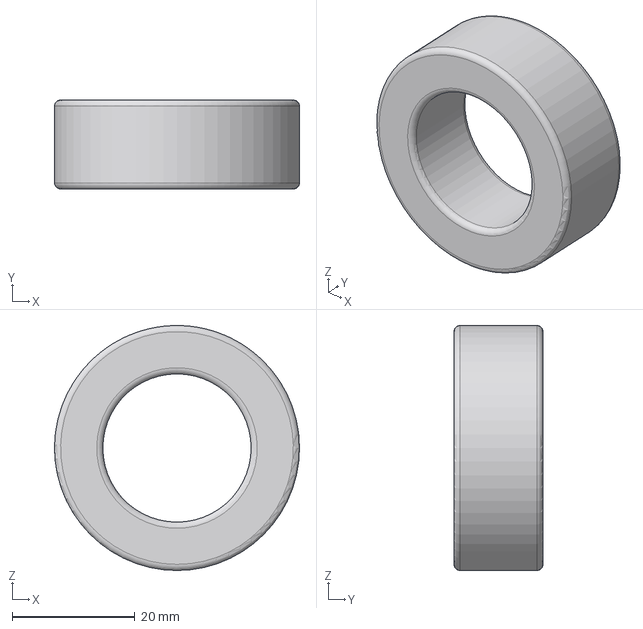
[picture p51: CAD file, 2026-04-24]
03 - PCB/DAB_PCB/DAB_lib/3d/inductor-core.step
39.9 x 14.5 x 39.9 mm
