lbregy/Power-Electronics/03 - PCB/DAB_PCB/DAB_lib/3d/FA-T220-25E.stp

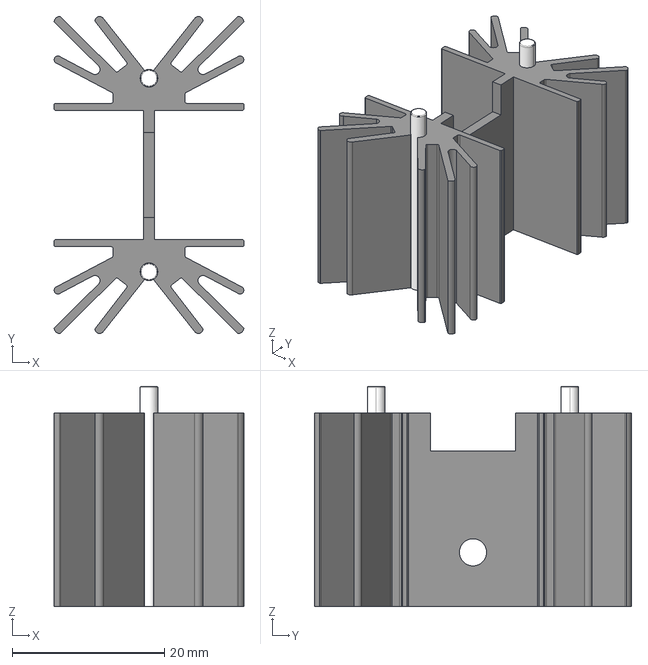
[picture p52: CAD file, 2026-04-21]
03 - PCB/DAB_PCB/DAB_lib/3d/FA-T220-25E.stp
24.9 x 41.6 x 28.9 mm
