lbregy/Power-Electronics/03 - PCB/DAB_PCB/DAB_lib/3d/UHW2A681MHD.stp

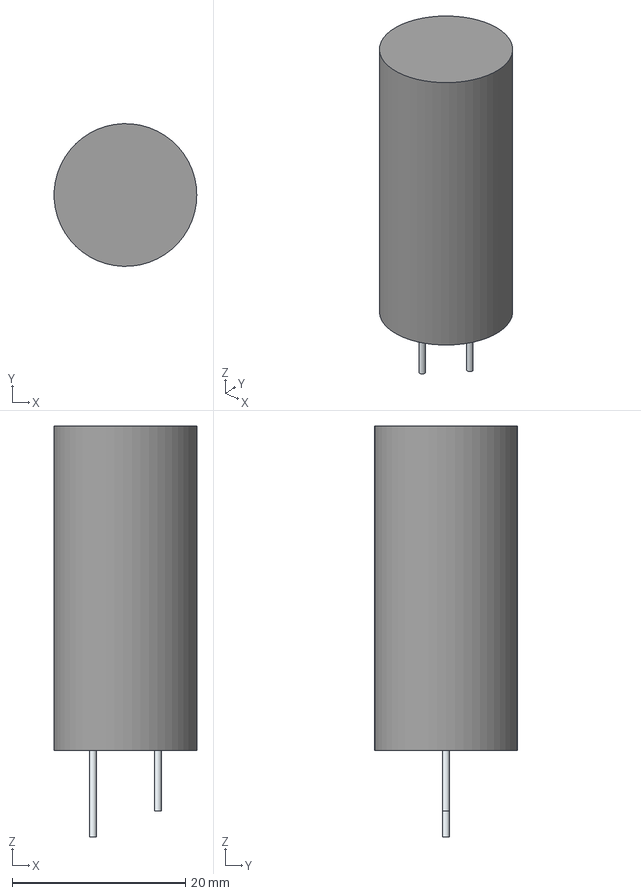
[picture p53: CAD file, 2026-04-21]
03 - PCB/DAB_PCB/DAB_lib/3d/UHW2A681MHD.stp
16.5 x 16.5 x 47.5 mm
SimpleBody
Pin1
Pin2
