lbregy/Power-Electronics/03 - PCB/DAB_PCB/DAB_lib/3d/CT-6EP103.stp

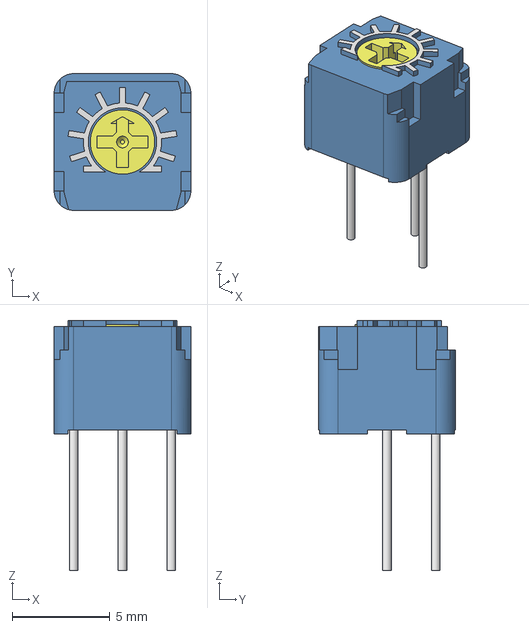
[picture p54: CAD file, 2026-04-21]
03 - PCB/DAB_PCB/DAB_lib/3d/CT-6EP103.stp
7.00 x 7.00 x 12.8 mm
CT-6EP-1
CT-6-dial
