lbregy/Power-Electronics/03 - PCB/DAB_PCB/DAB_lib/3d/LMBS-1_MCE.step

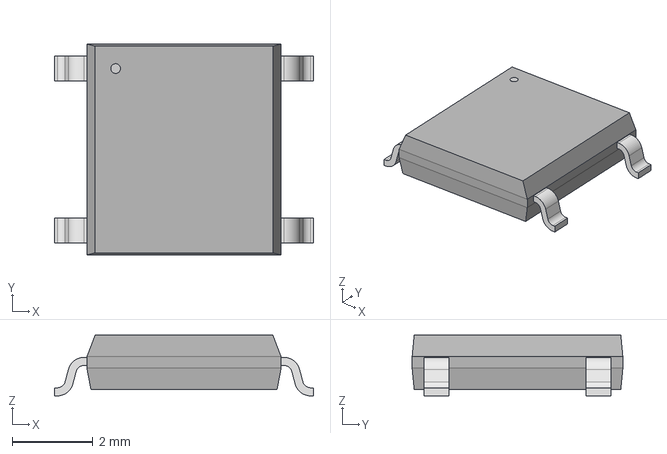
[picture p55: CAD file, 2026-04-21]
03 - PCB/DAB_PCB/DAB_lib/3d/LMBS-1_MCE.step
6.40 x 5.21 x 1.50 mm
