lbregy/Power-Electronics/03 - PCB/DAB_PCB/DAB_lib/3d/WP710A10.STEP

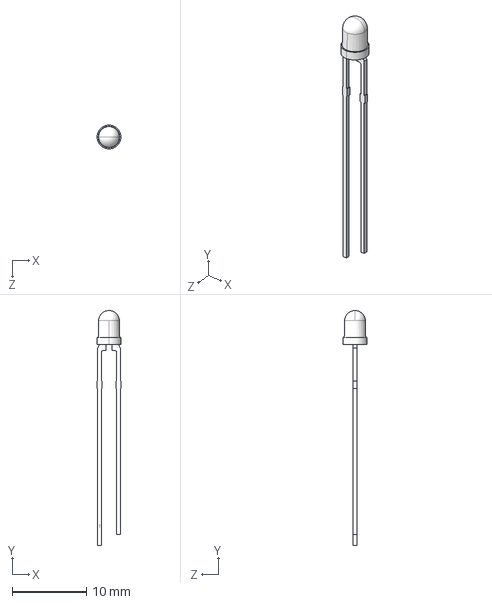
[picture p56: CAD file, 2026-04-21]
03 - PCB/DAB_PCB/DAB_lib/3d/WP710A10.STEP
3.24 x 31.6 x 3.20 mm
