lbregy/Power-Electronics/03 - PCB/DAB_PCB/DAB_lib/3d/MAL215097614E3.stp

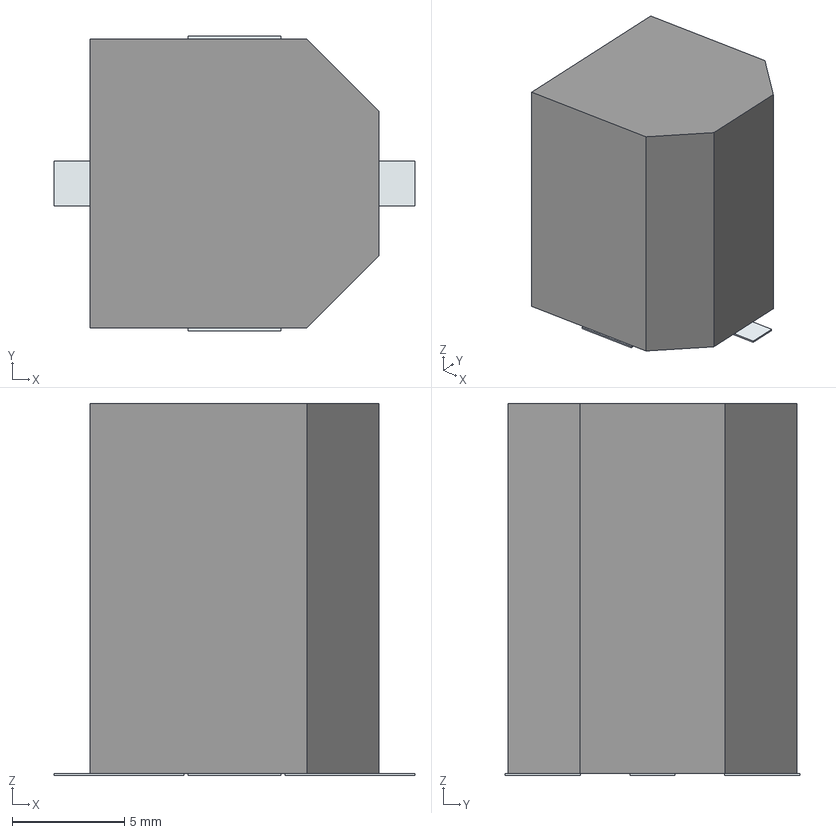
[picture p57: CAD file, 2026-04-21]
03 - PCB/DAB_PCB/DAB_lib/3d/MAL215097614E3.stp
16.1 x 13.2 x 16.6 mm
Pins
