lbregy/Power-Electronics/03 - PCB/DAB_PCB/DAB_lib/3d/B66362X1014T001.stp

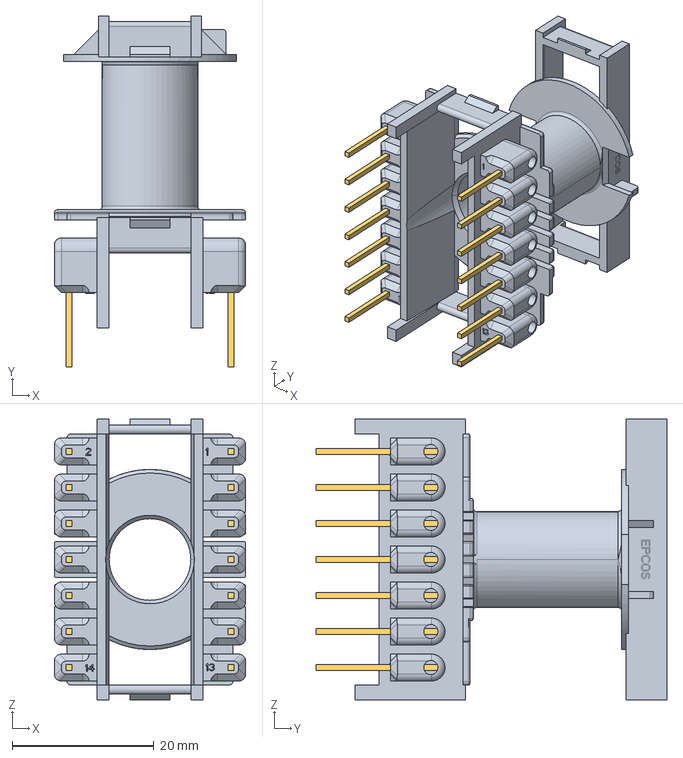
[picture p58: CAD file, 2026-04-21]
03 - PCB/DAB_PCB/DAB_lib/3d/B66362X1014T001.stp
27.0 x 49.5 x 39.6 mm
