lbregy/Power-Electronics/03 - PCB/DAB_PCB/DAB_lib/3d/c61036-a0103-c001_ETD34.stp

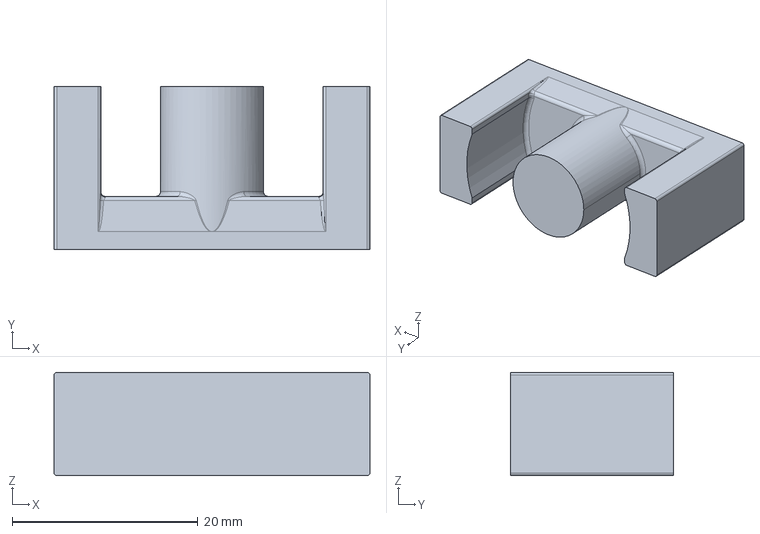
[picture p59: CAD file, 2026-04-21]
03 - PCB/DAB_PCB/DAB_lib/3d/c61036-a0103-c001_ETD34.stp
34.0 x 17.5 x 11.1 mm
