lbregy/Power-Electronics/01 - Sizing/Plots /Q12-measurement .png

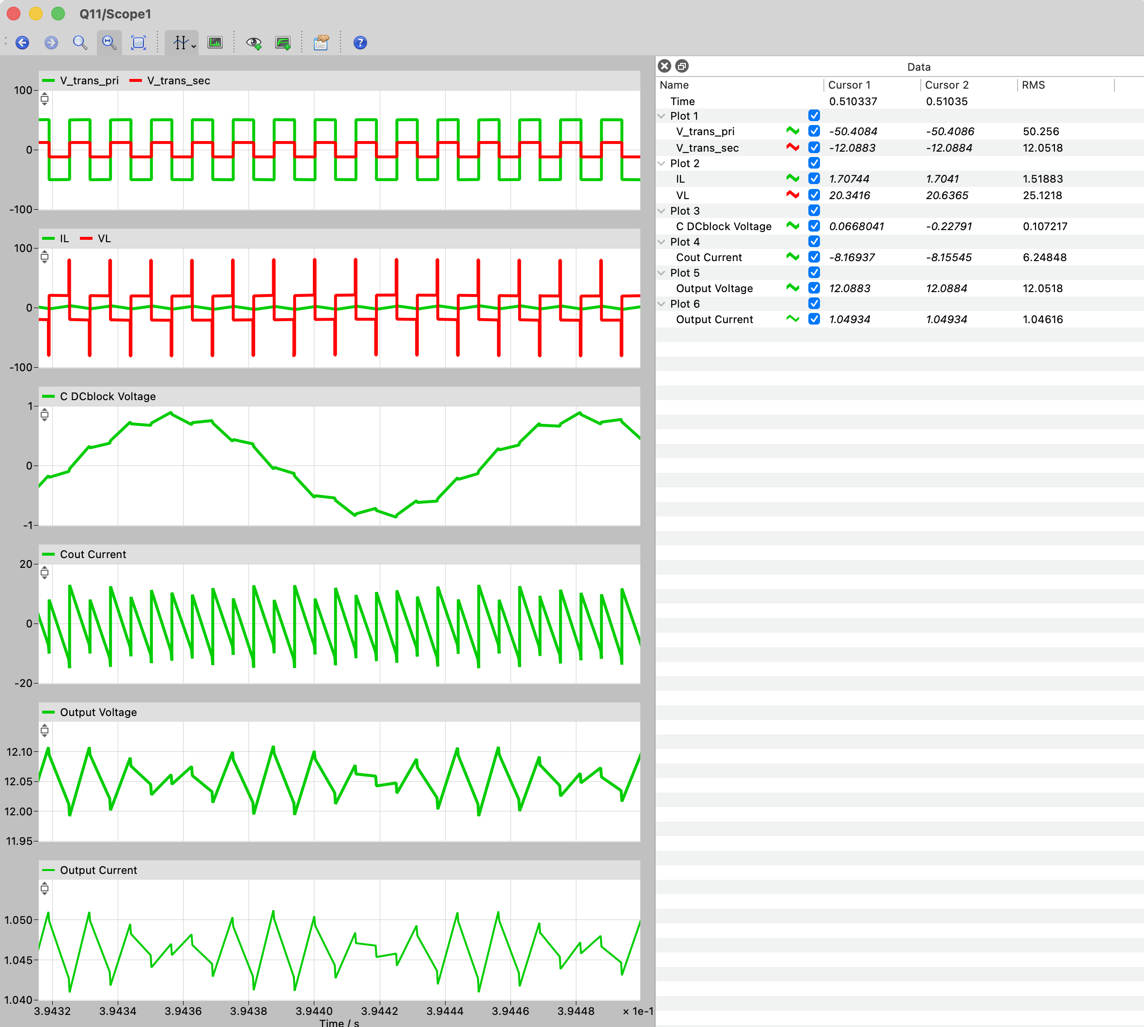
01 - Sizing/Plots /Q12-measurement .png
