lbregy/Power-Electronics/03 - PCB/DAB_PCB/DAB_converter.pdf

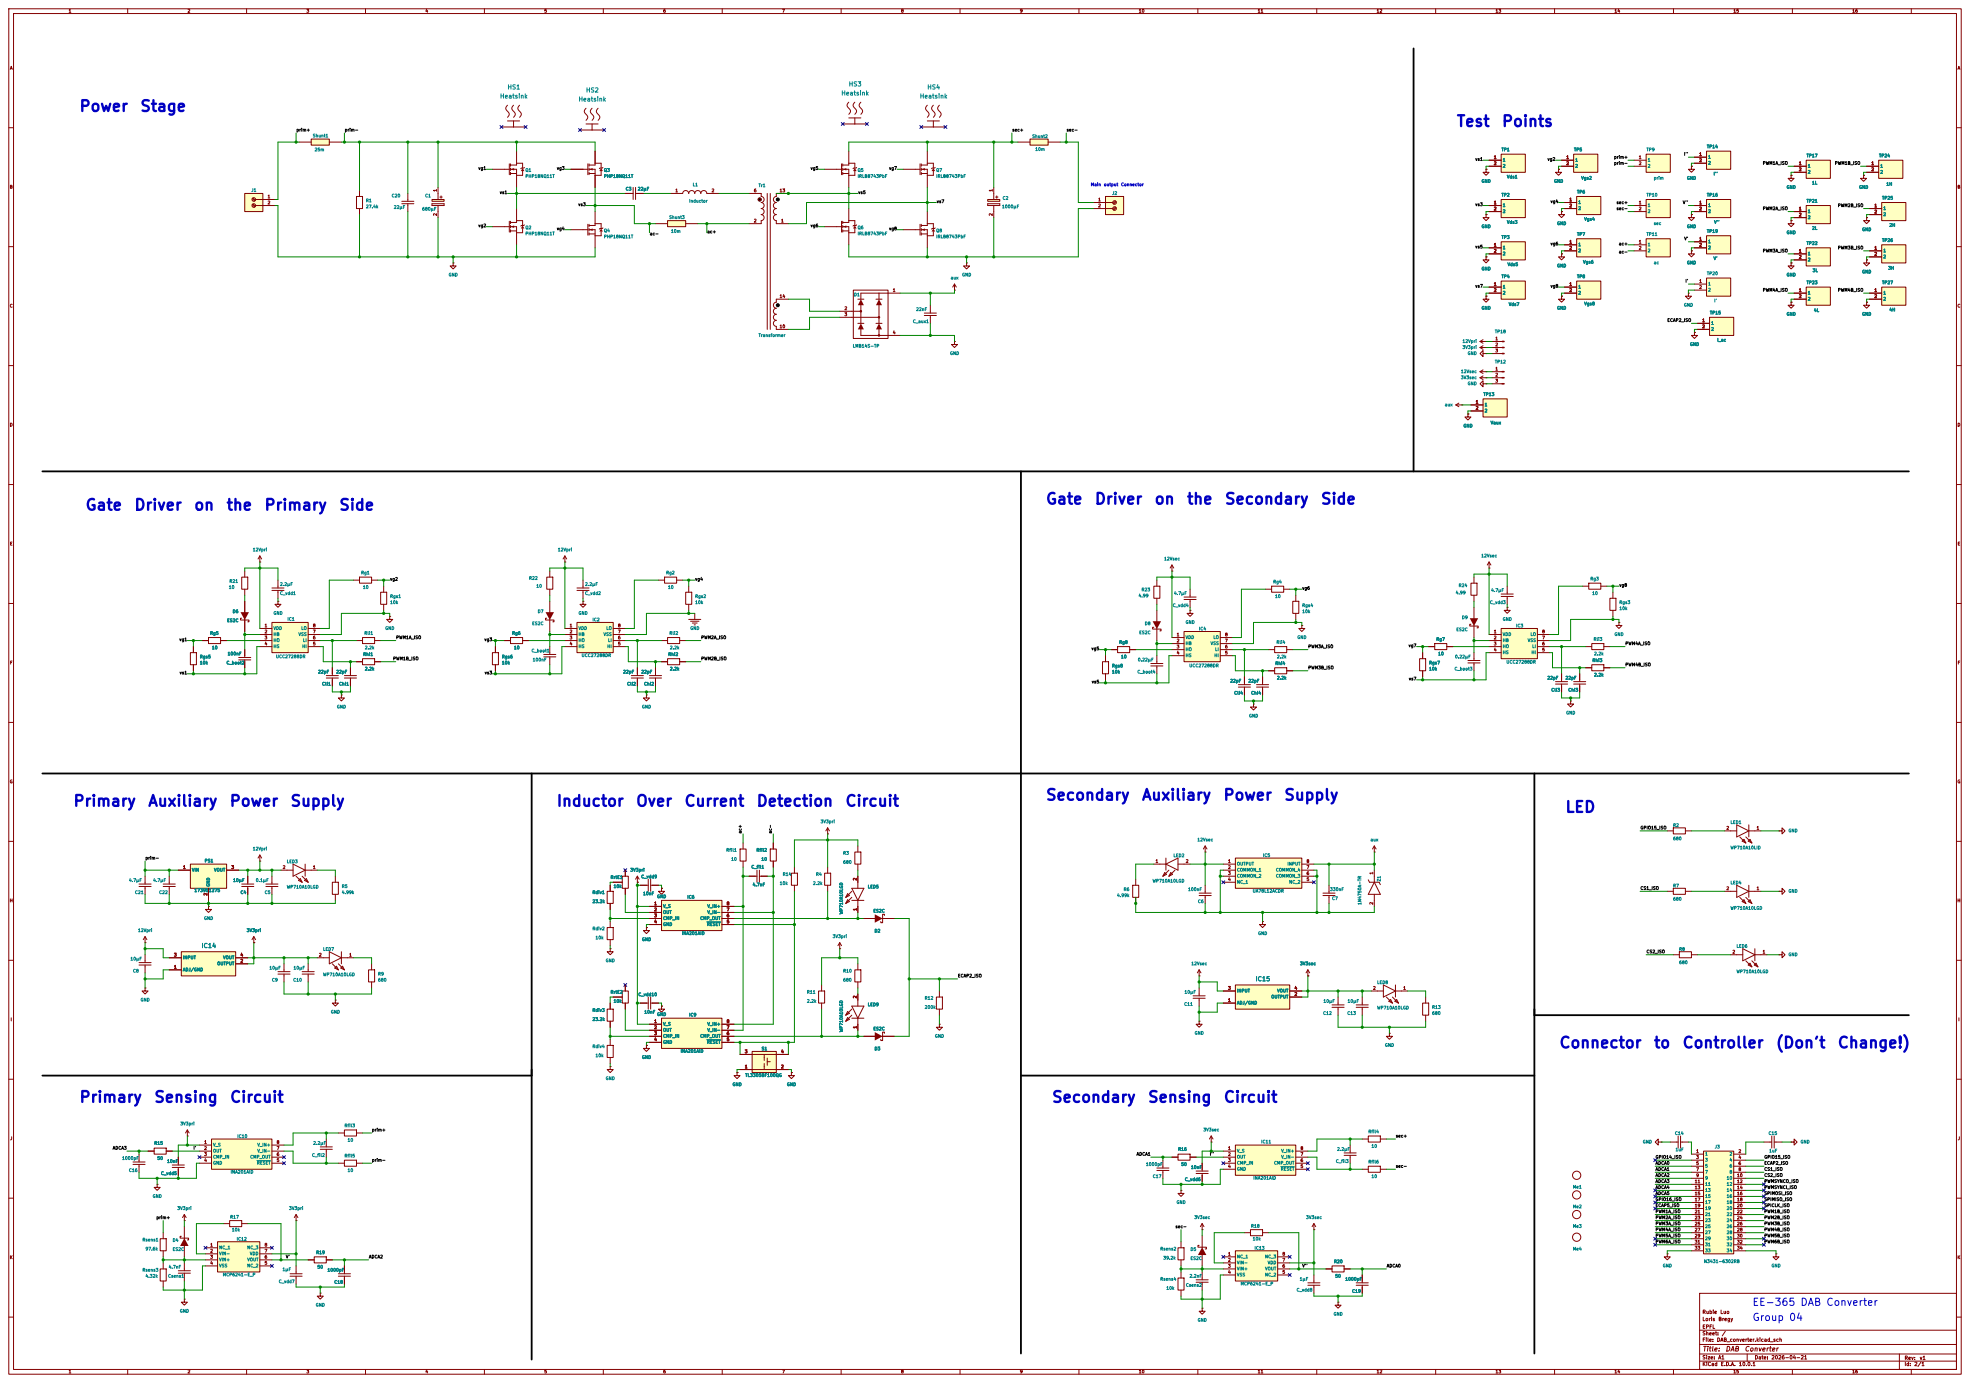
[picture p61: page 1]

Gate Driver on the Secondary Side

Gate Driver on the Primary Side

Primary Auxiliary Power Supply

PWM1A_ISO Connector to Controller (Don't Change!)

Size: A1 | Rev: v1
KiCad E.D.A. 10.0.1 | Id: 2/1
