lbregy/Power-Electronics/01 - Sizing/Plots /Q12.pdf

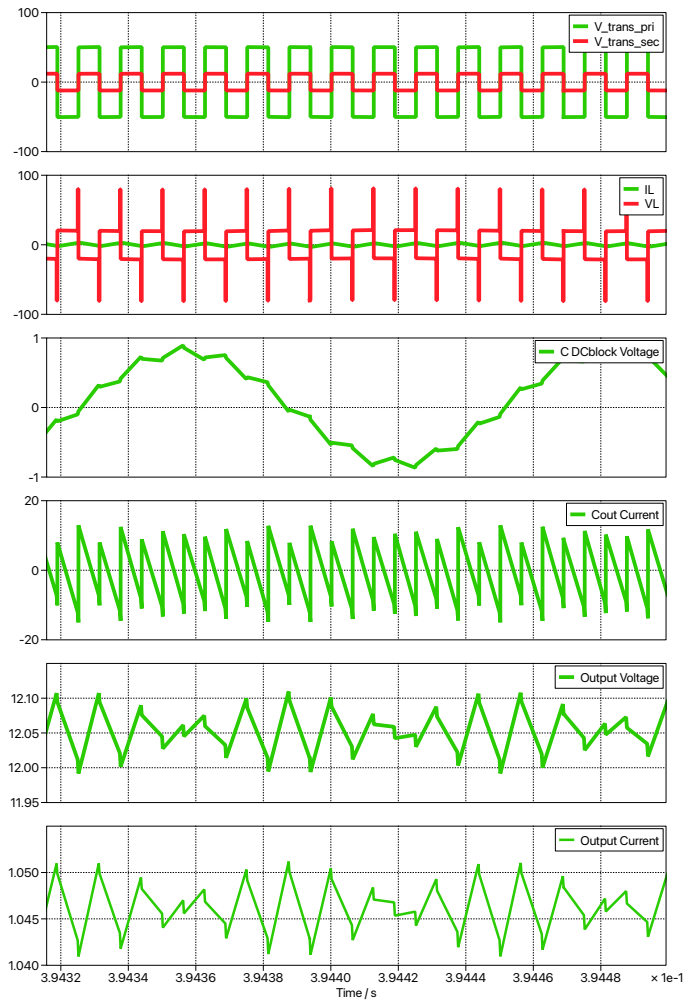
[picture p62: page 1]
Time / s; V_trans_pri V_trans_sec; C DCblock Voltage; Cout Current; Output Voltage; Output Current
