lbregy/Power-Electronics/(list of files, drawings)

Other design files:
03 - PCB/DAB_PCB/DAB_lib/DAB_EE365.SchLib
03 - PCB/DAB_PCB/sch_data.json
