lbregy/Power-Electronics/03 - PCB/DAB_PCB/DAB_converter.kicad_pcb

## KiCad design 03 - PCB/DAB_PCB/DAB_converter.kicad_pcb (2026-05-04)

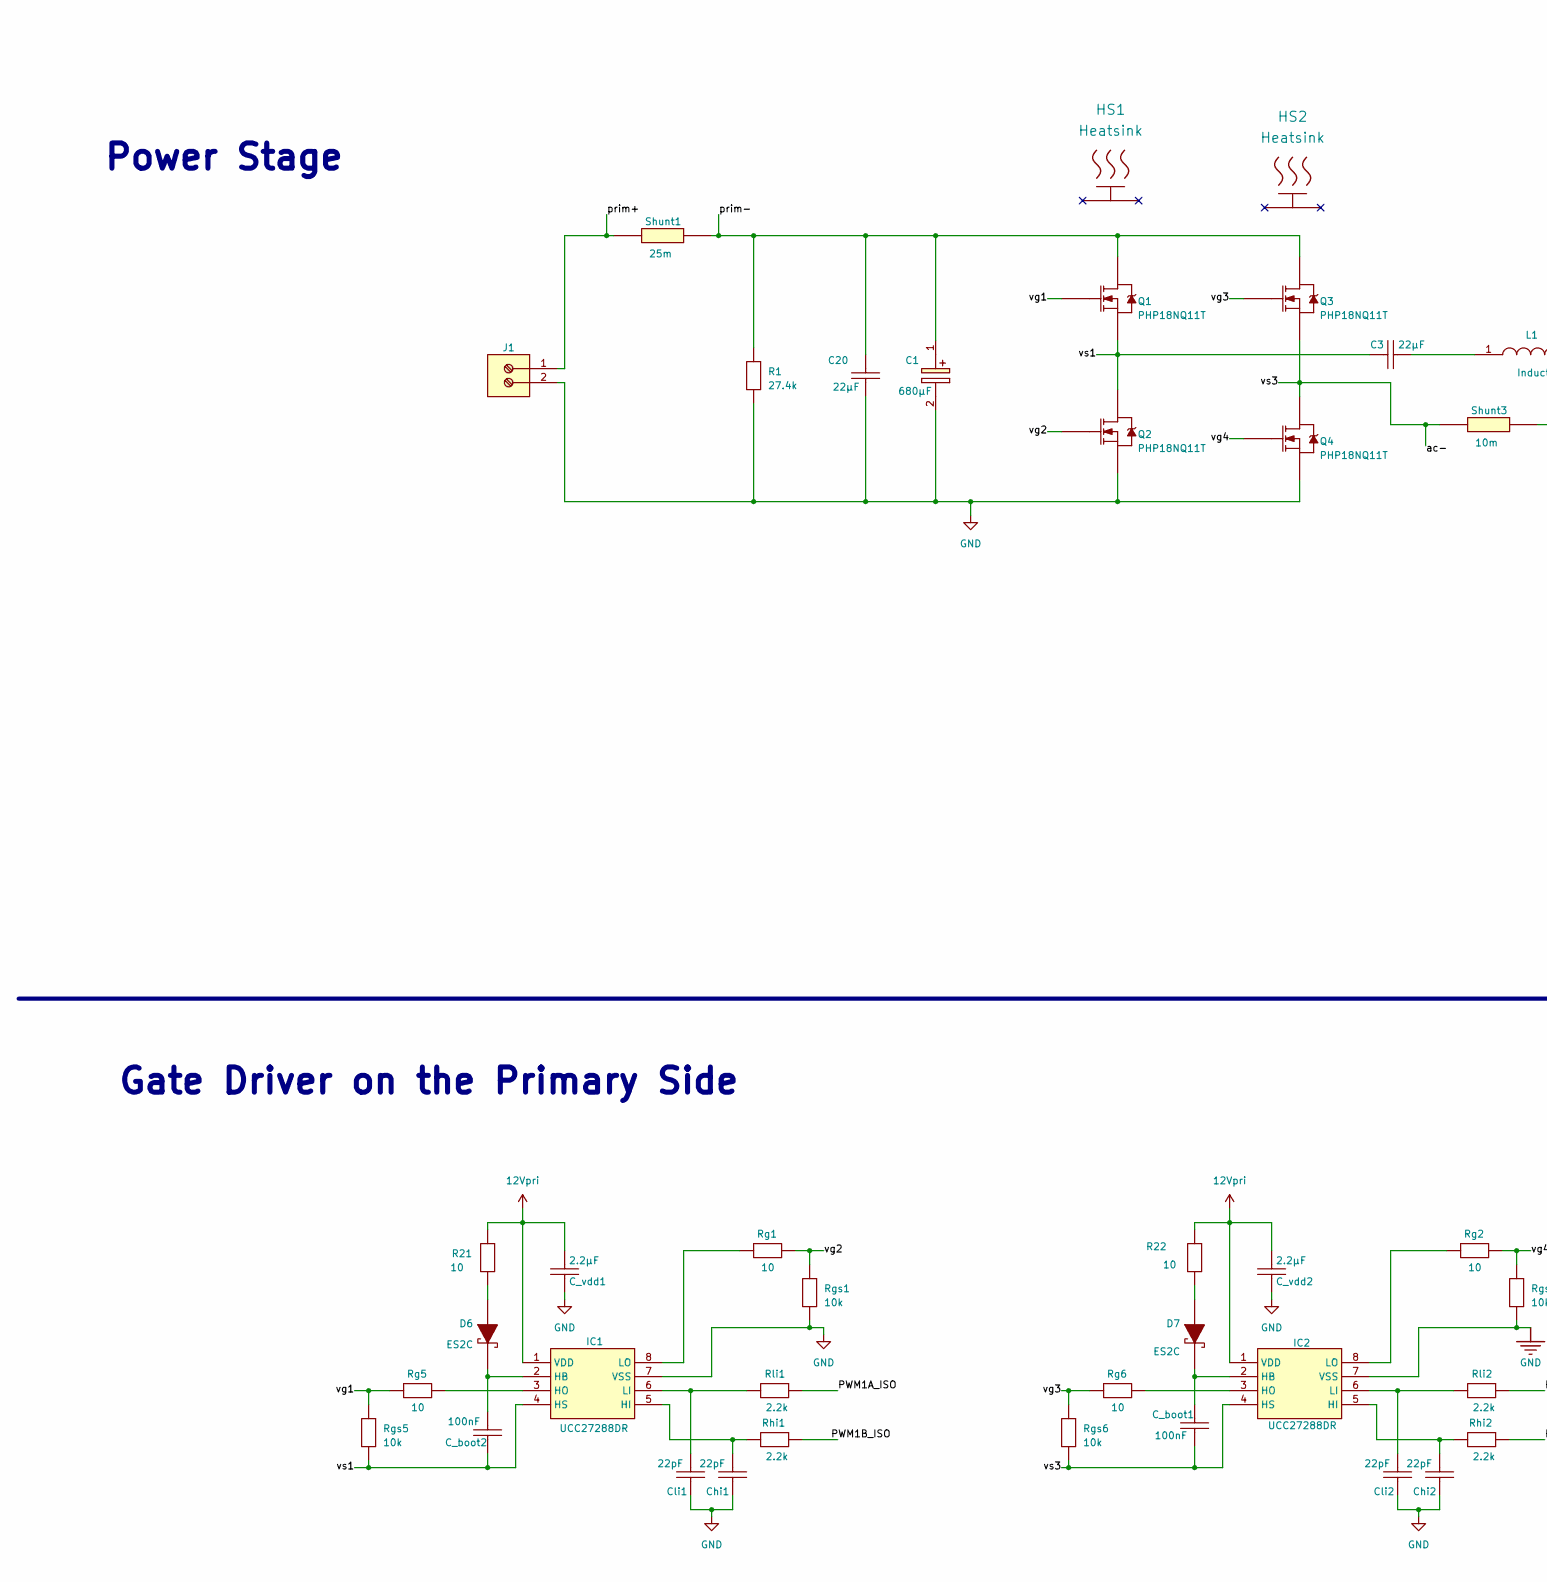
[picture p63: schematic DAB_converter.kicad_sch, DAB Converter, part in row 1, column 1]

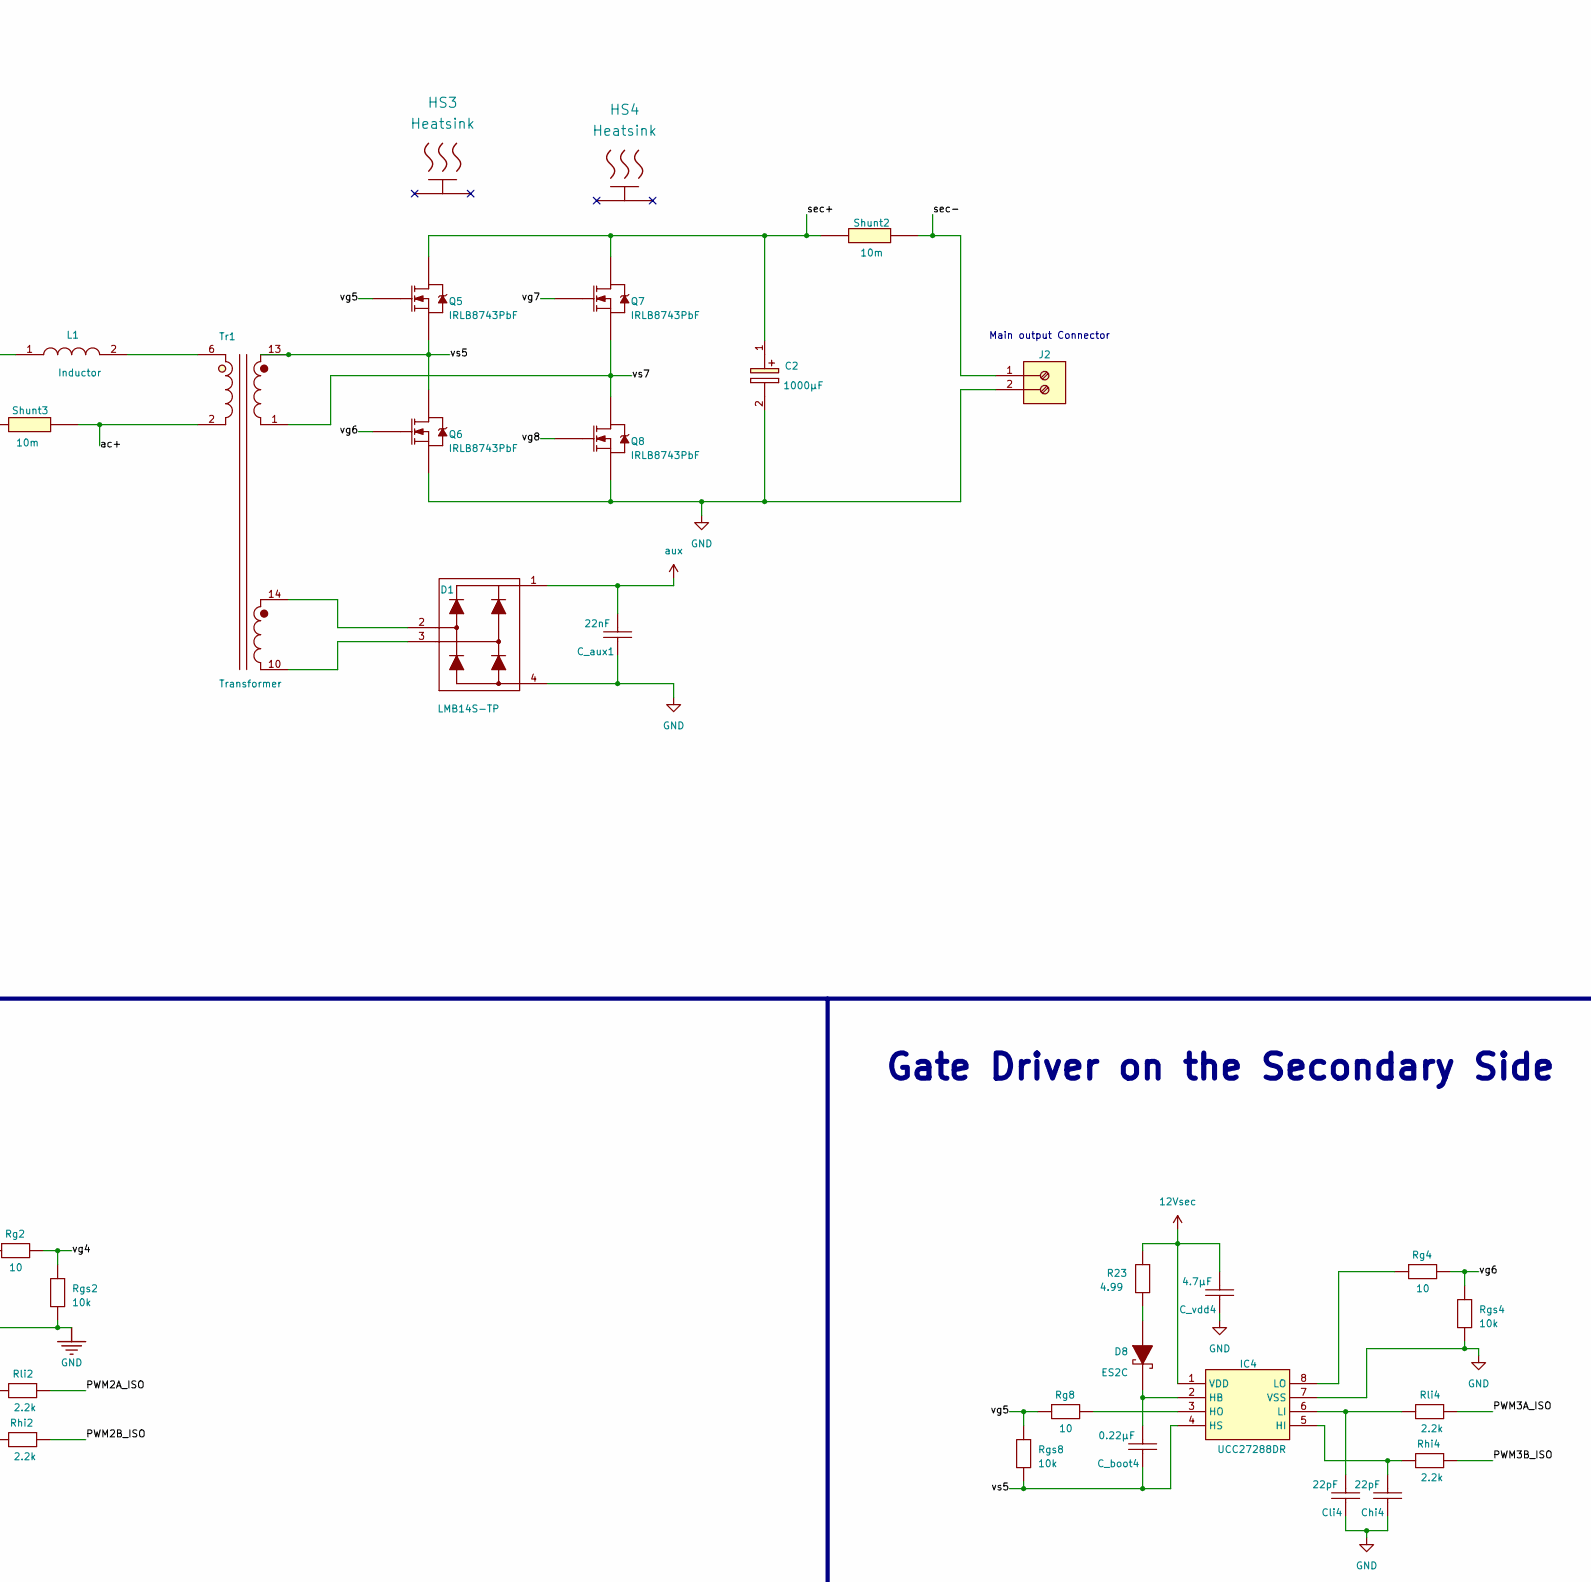
[picture p64: schematic DAB_converter.kicad_sch, DAB Converter, part in row 1, column 2]

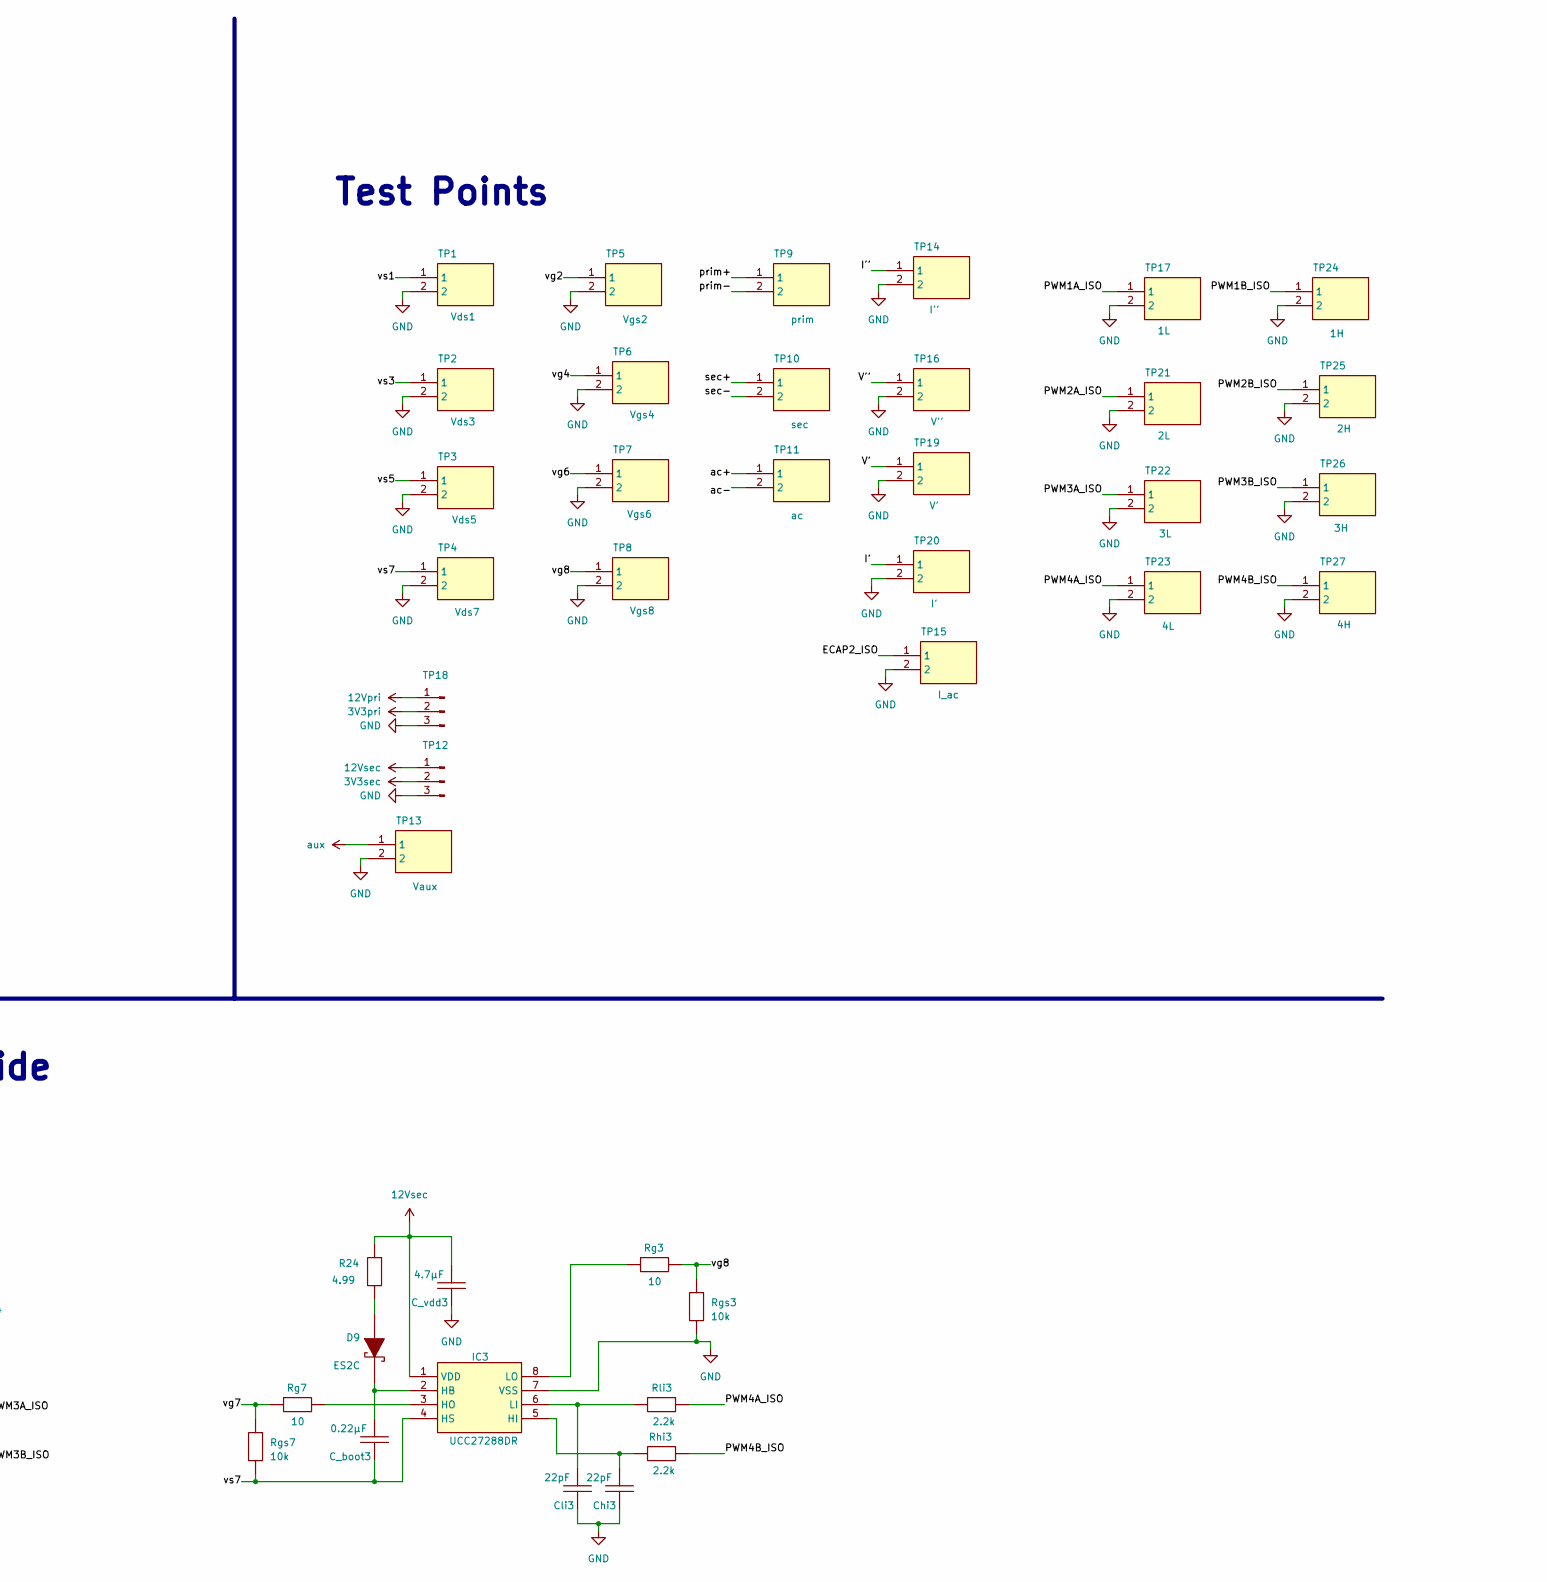
[picture p65: schematic DAB_converter.kicad_sch, DAB Converter, part in row 1, column 3]

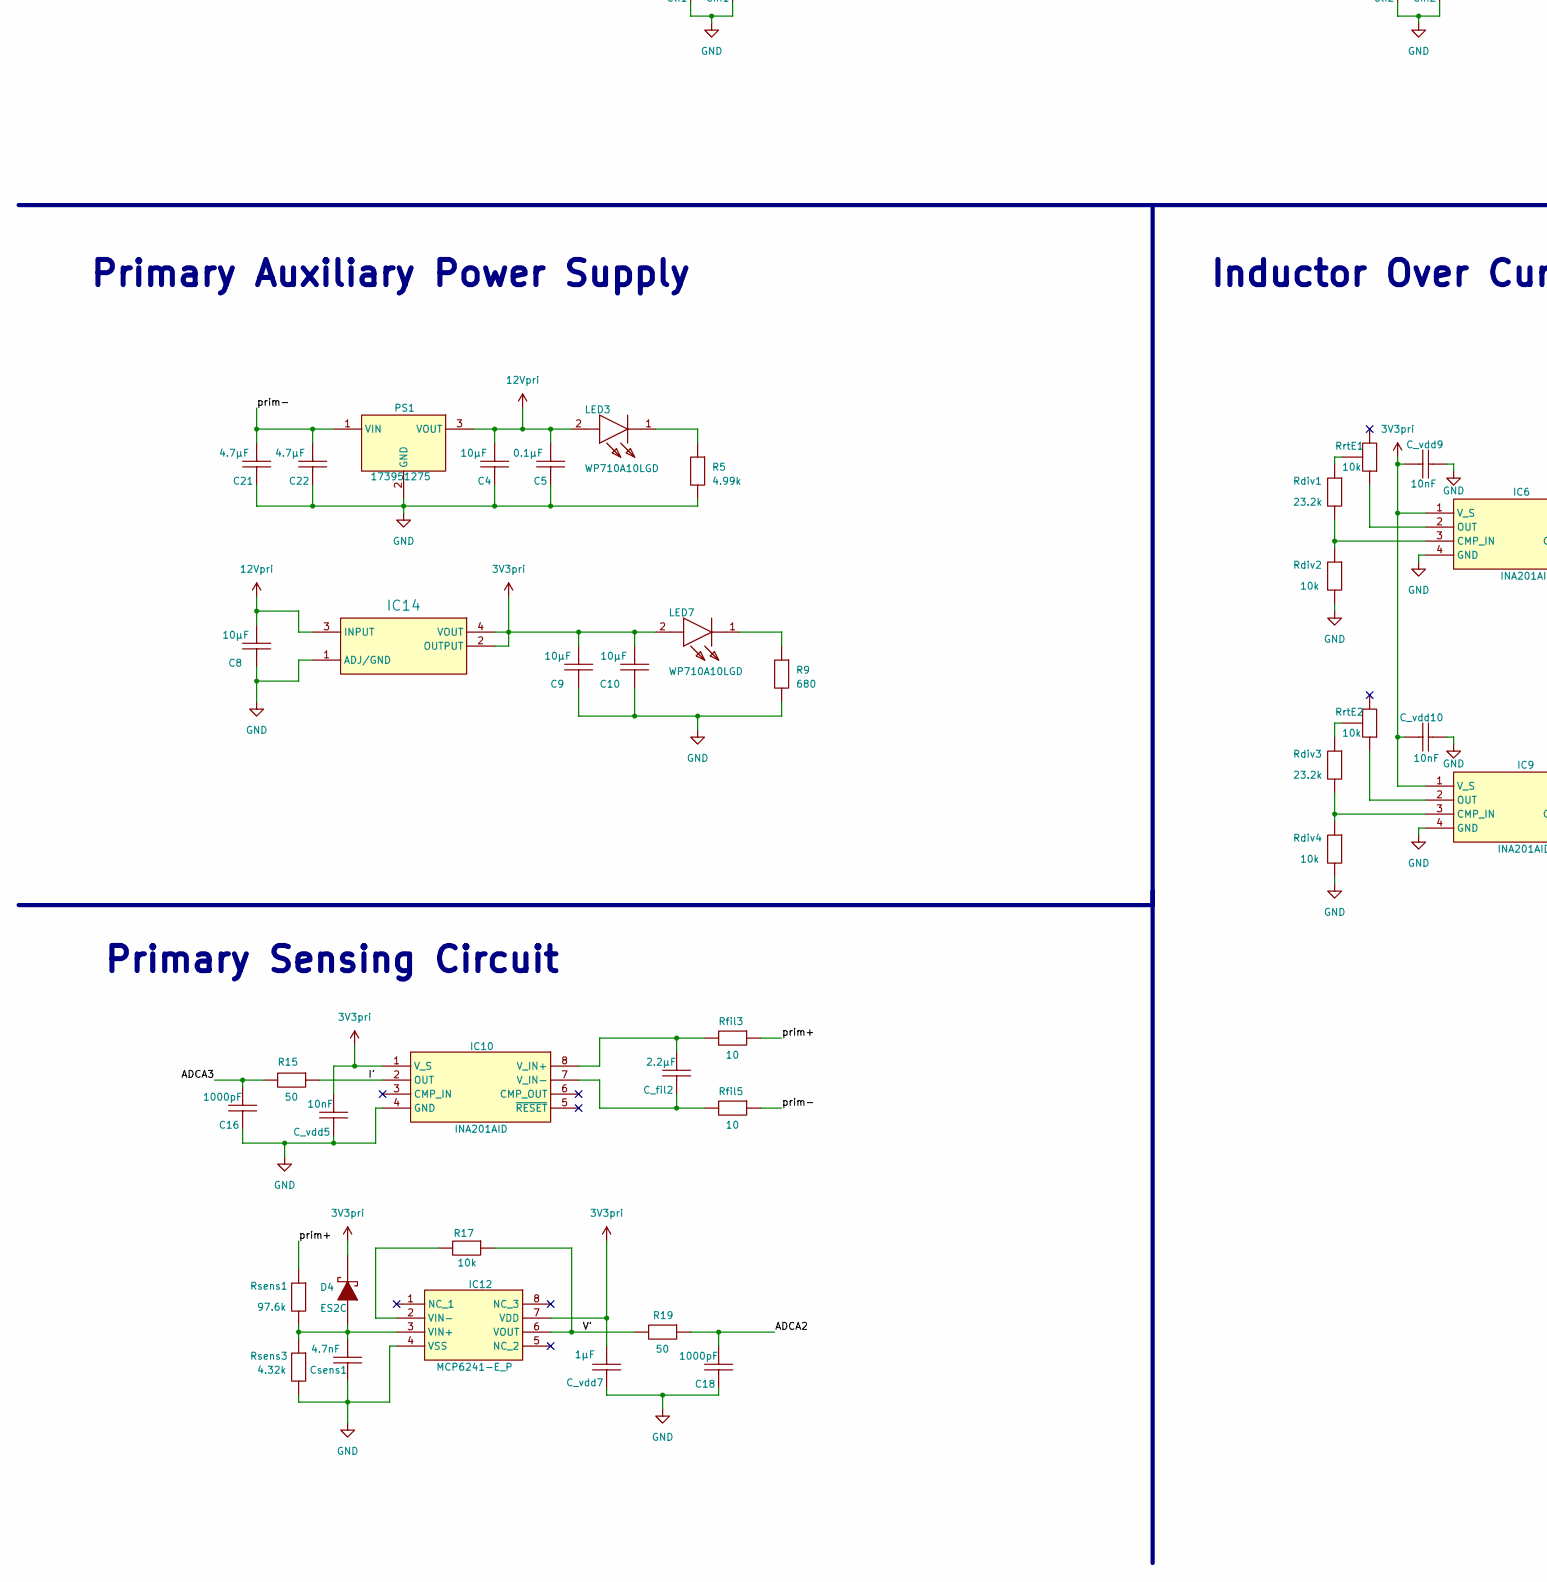
[picture p66: schematic DAB_converter.kicad_sch, DAB Converter, part in row 2, column 1]

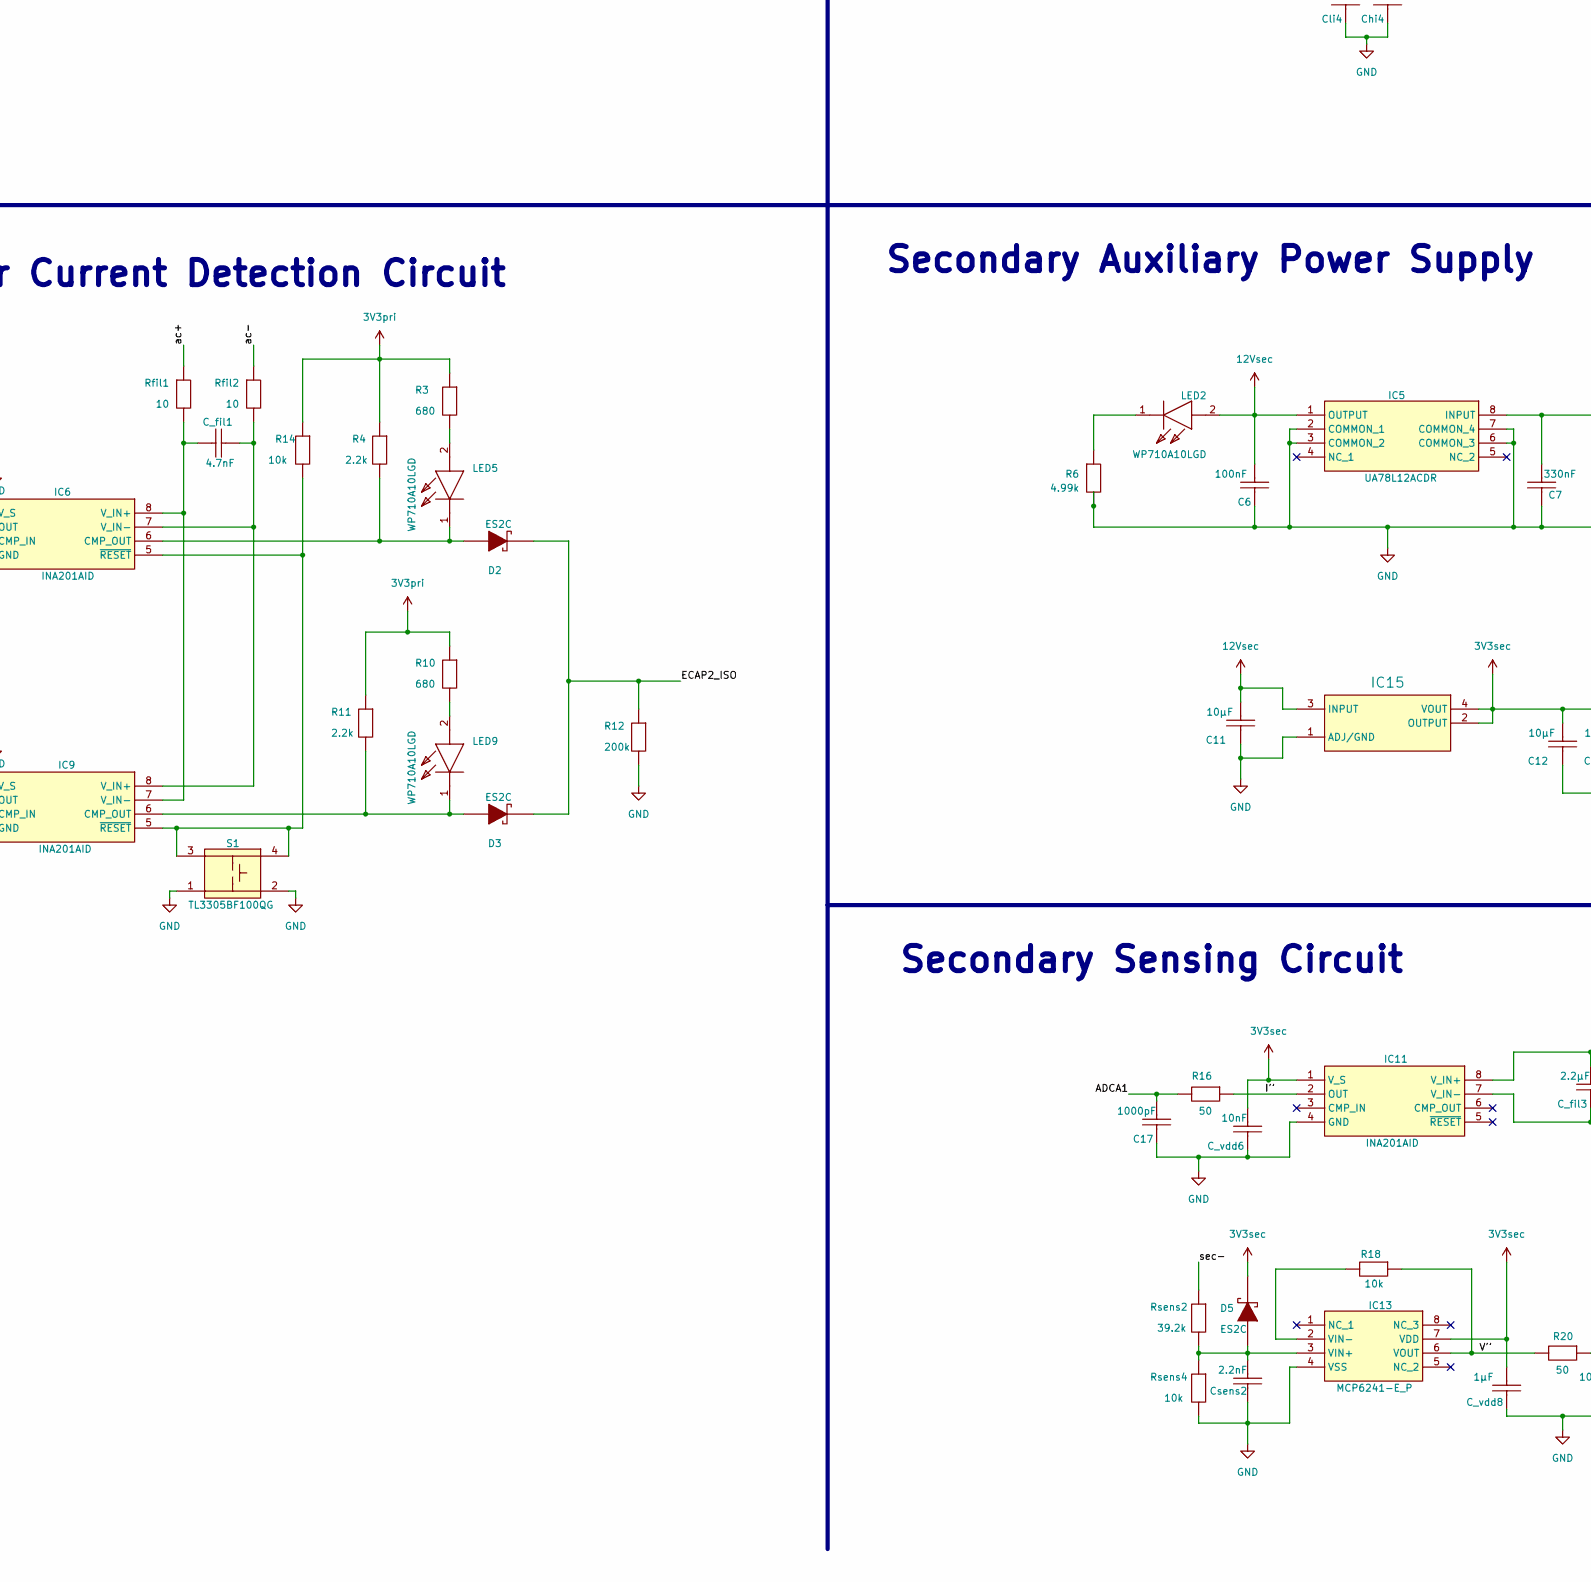
[picture p67: schematic DAB_converter.kicad_sch, DAB Converter, part in row 2, column 2]

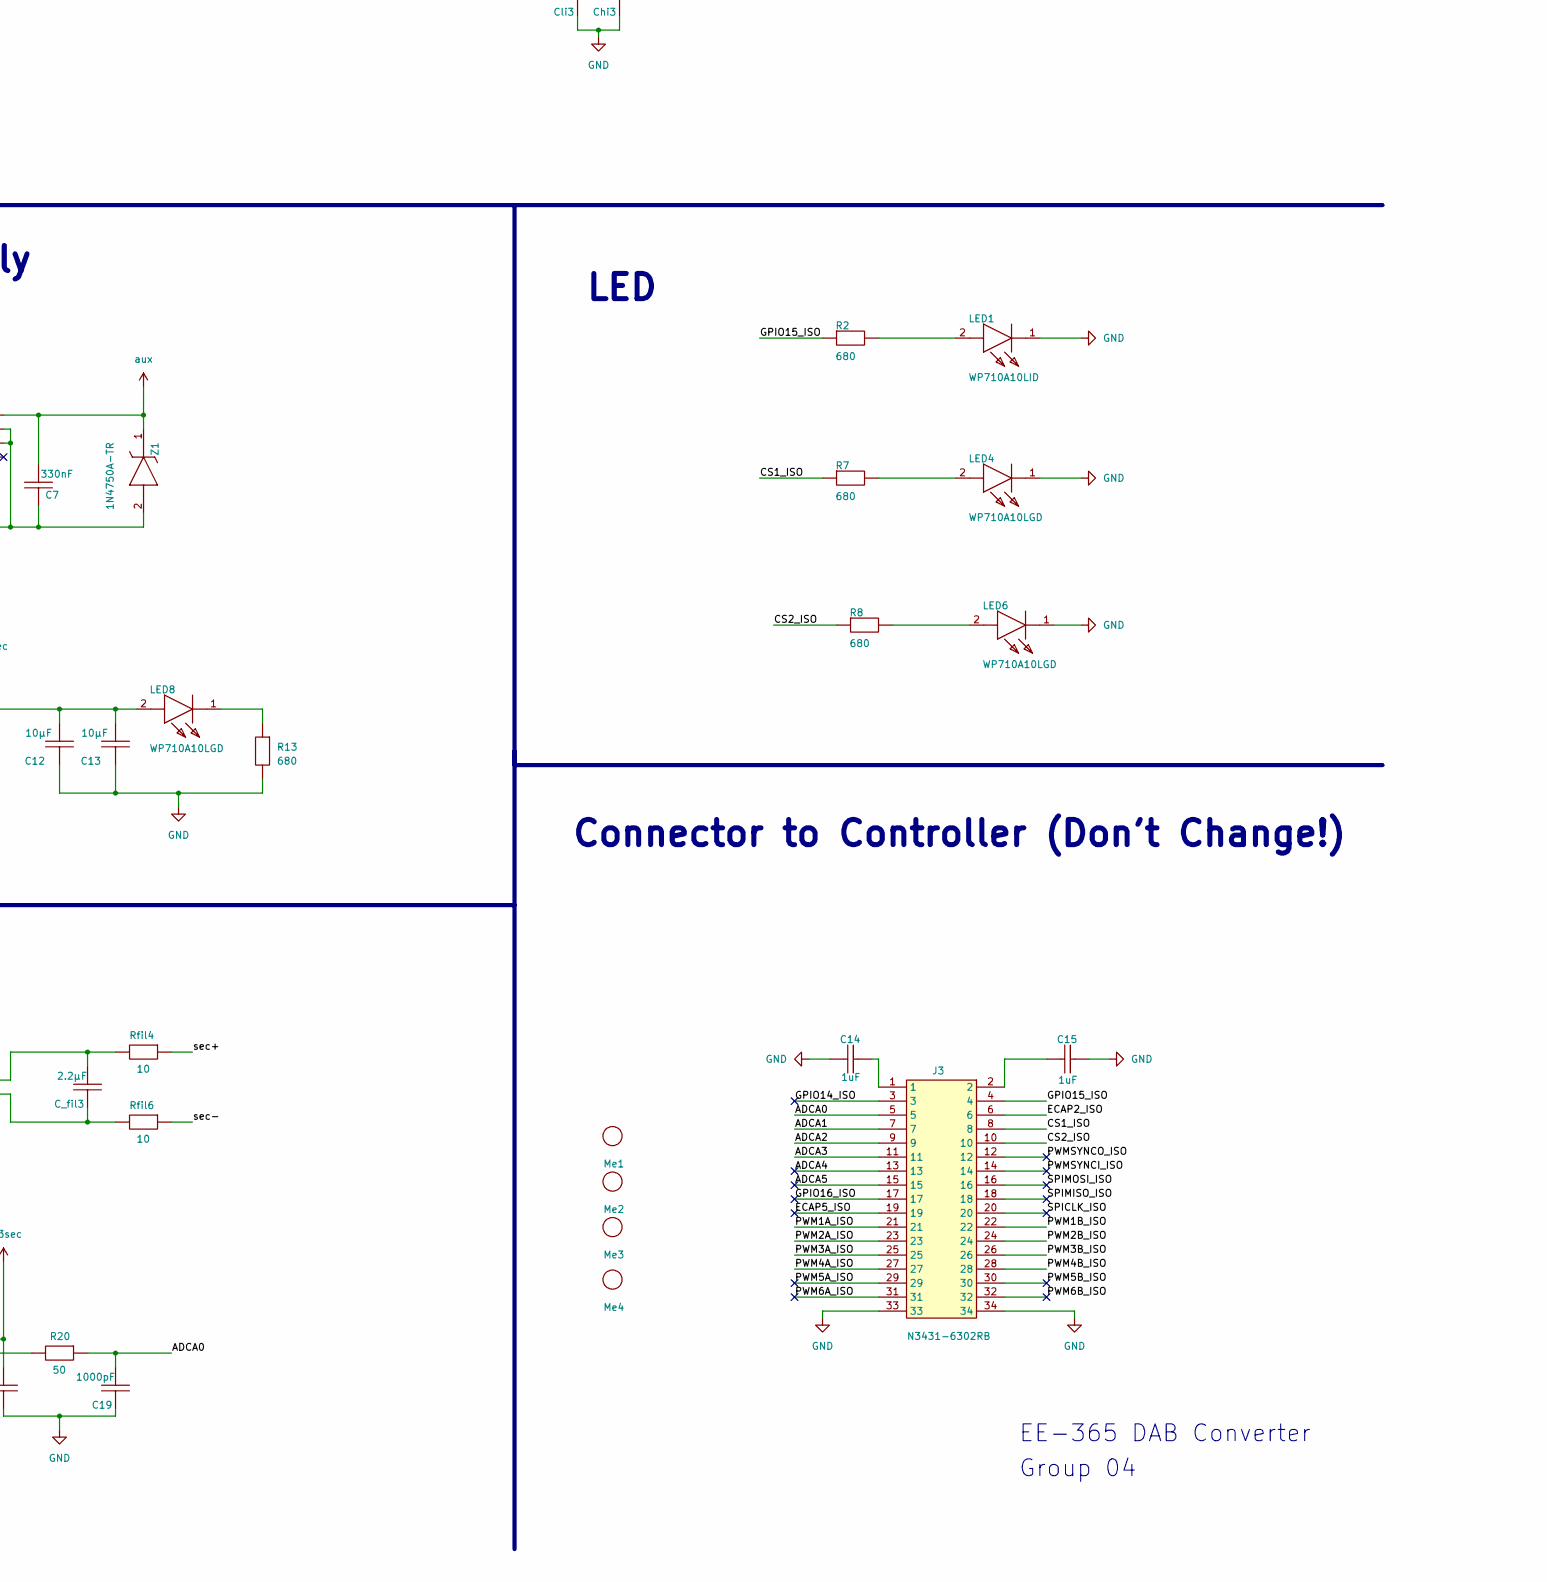
[picture p68: schematic DAB_converter.kicad_sch, DAB Converter, part in row 2, column 3]

Parts:
C1: 680µF; CAPPRD750W80D1625H3750; MANUFACTURER_PART_NUMBER UHW2A681MHD; MOUSER PART NUMBER 647-UHW2A681MHD
C2: 1000µF; MAL215097614E3; MANUFACTURER_PART_NUMBER MAL215097614E3; MOUSER PART NUMBER 594-MAL215097614E3
C3: 22µF; C_2220_5750Metric; PART NUMBER C5750X7S2A226M280KB
C4, C8, C9, C10, C11, C12, C13: 10µF; C_1206_3216Metric
C5: 0.1µF; C_1206_3216Metric
C6: 100nF; C_1206_3216Metric
C7: 330nF; C_1206_3216Metric
C14, C15: 1uF; R_1206_3216Metric
C16, C17, C18, C19: 1000pF; C_1206_3216Metric
C20: 22µF; C_2220_5750Metric; PART NUMBER C1206C475K3PACTU
C21, C22: 4.7µF; C_1206_3216Metric; PART NUMBER GRM31CZ72A475KE1
C_aux1: 22nF; C_2220_5750Metric; PART NUMBER C5750X7S2A226M280KB
C_boot1, C_boot2: 100nF; C_1206_3216Metric; PART NUMBER C1206C224K5RACTU
C_boot3, C_boot4: 0.22µF; C_1206_3216Metric
C_fil1: 4.7nF; C_1206_3216Metric
C_fil2, C_fil3: 2.2µF; C_1206_3216Metric
C_vdd1, C_vdd2: 2.2µF; C_1206_3216Metric; PART NUMBER C1206C475K3PACTU
C_vdd3, C_vdd4: 4.7µF; C_1206_3216Metric
C_vdd5, C_vdd6, C_vdd9, C_vdd10: 10nF; C_1206_3216Metric
C_vdd7, C_vdd8: 1µF; C_1206_3216Metric
Chi1, Chi2, Chi3, Chi4: 22pF; C_1206_3216Metric
Cli1, Cli2, Cli3, Cli4: 22pF; C_1206_3216Metric
Csens1: 4.7nF; C_1206_3216Metric
Csens2: 2.2nF; C_1206_3216Metric
D1: LMB14S-TP; LMB14STP; MANUFACTURER_PART_NUMBER LMB14S-TP; MOUSER PART NUMBER 833-LMB14S-TP
D2, D3, D4, D5, D6, D7, D8, D9: ES2C; DIOM5436X244N
HS1, HS2, HS3, HS4: Heatsink; FAT22025E
IC1, IC2, IC3, IC4: UCC27288DR; SOIC127P600X175-8N; MANUFACTURER_PART_NUMBER UCC27288DR; MOUSER PART NUMBER 595-UCC27288DR
IC5: UA78L12ACDR; SOIC127P600X175-8N; MANUFACTURER_PART_NUMBER UA78L12ACDR; MOUSER PART NUMBER 595-UA78L12ACDR
IC6, IC9, IC10, IC11: INA201AID; SOIC127P600X175-8N; MANUFACTURER_PART_NUMBER INA201AID; MOUSER PART NUMBER 595-INA201AID
IC12, IC13: MCP6241-E_P; DIP781W56P254L950H533Q8N; MANUFACTURER_PART_NUMBER MCP6241-E/P; MOUSER PART NUMBER 579-MCP6241-E/P
IC14, IC15: SOT230P700X180-4N; Manufacturer_Part_Number AZ1117IH-3.3TRG1; Mouser Part Number 621-AZ1117IH-3.3TRG1
J1, J2: PHOENIX 1755736
J3: N3431-6302RB; 3M_N3431-6302RB; MANUFACTURER_PART_NUMBER HIF3FC-34PA-2.54DS(71); MOUSER PART NUMBER 798-HIF3FC34PA254DS1
L1: Inductor; inductor; MANUFACTURER_PART_NUMBER MLZ2012N100LT000; MOUSER PART NUMBER 810-MLZ2012N100LT000
LED1: WP710A10LID; MANUFACTURER_PART_NUMBER WP710A10LID; MOUSER PART NUMBER 604-WP710A10LID
LED2, LED3, LED4, LED5, LED6, LED7, LED8, LED9: WP710A10LGD; WP710A10LID; MANUFACTURER_PART_NUMBER WP710A10LGD; MOUSER PART NUMBER 604-WP710A10LGD
Me1, Me2, Me3, Me4: M3-Hole; MountingHole_3.2mm_M3
PS1: 173951275; MANUFACTURER_PART_NUMBER 173951275
Q1, Q2, Q3, Q4: PHP18NQ11T; TO-220AB
Q5, Q6, Q7, Q8: IRLB8743PbF; TO-220AB
R1: 27.4k; R_1206_3216Metric
R2, R3, R7, R8, R9, R10, R13: 680; R_1206_3216Metric
R4, R11: 2.2k; R_1206_3216Metric
R5, R6: 4.99k; R_1206_3216Metric
R12: 200k; R_1206_3216Metric
R14, R17, R18: 10k; R_1206_3216Metric
R15, R16, R19, R20: 50; R_1206_3216Metric
R21, R22: 10; R_1206_3216Metric
R23, R24: 4.99; R_1206_3216Metric
Rdiv1, Rdiv3: 23.2k; R_1206_3216Metric
Rdiv2, Rdiv4: 10k; R_1206_3216Metric
Rfil1, Rfil2, Rfil3, Rfil4, Rfil5, Rfil6: 10; R_1206_3216Metric
Rg1, Rg2, Rg3, Rg4, Rg5, Rg6, Rg7, Rg8: 10; R_1206_3216Metric
Rgs1, Rgs2, Rgs3, Rgs4, Rgs5, Rgs6, Rgs7, Rgs8: 10k; R_1206_3216Metric
Rhi1, Rhi2, Rhi3, Rhi4: 2.2k; R_1206_3216Metric
Rli1, Rli2, Rli3, Rli4: 2.2k; R_1206_3216Metric
RrtE1, RrtE2: 10k; TRIMMER CT-6EP
Rsens1: 97.6k; R_1206_3216Metric
Rsens2: 39.2k; R_1206_3216Metric
Rsens3: 4.32k; R_1206_3216Metric
Rsens4: 10k; R_1206_3216Metric
S1: TL3305BF100QG; TL3305BF160QG; MANUFACTURER_PART_NUMBER TL3305BF100QG; MOUSER PART NUMBER 612-TL3305BF100QG
Shunt1: 25m; R_2512_6332Metric; MANUFACTURER_PART_NUMBER CSNL2512FT5L00
Shunt2, Shunt3: 10m; R_2512_6332Metric; MANUFACTURER_PART_NUMBER CSNL2512FT5L00
TP1: Vds1; test point 2; MANUFACTURER_PART_NUMBER TSW-202-07-T-S; MOUSER PART NUMBER 200-TSW20207TS
TP2: Vds3; test point 2; MANUFACTURER_PART_NUMBER TSW-202-07-T-S; MOUSER PART NUMBER 200-TSW20207TS
TP3: Vds5; test point 2; MANUFACTURER_PART_NUMBER TSW-202-07-T-S; MOUSER PART NUMBER 200-TSW20207TS
TP4: Vds7; test point 2; MANUFACTURER_PART_NUMBER TSW-202-07-T-S; MOUSER PART NUMBER 200-TSW20207TS
TP5: Vgs2; test point 2; MANUFACTURER_PART_NUMBER TSW-202-07-T-S; MOUSER PART NUMBER 200-TSW20207TS
TP6: Vgs4; test point 2; MANUFACTURER_PART_NUMBER TSW-202-07-T-S; MOUSER PART NUMBER 200-TSW20207TS
TP7: Vgs6; test point 2; MANUFACTURER_PART_NUMBER TSW-202-07-T-S; MOUSER PART NUMBER 200-TSW20207TS
TP8: Vgs8; test point 2; MANUFACTURER_PART_NUMBER TSW-202-07-T-S; MOUSER PART NUMBER 200-TSW20207TS
TP9: prim; test point 2; MANUFACTURER_PART_NUMBER TSW-202-07-T-S; MOUSER PART NUMBER 200-TSW20207TS
TP10: sec; test point 2; MANUFACTURER_PART_NUMBER TSW-202-07-T-S; MOUSER PART NUMBER 200-TSW20207TS
TP11: ac; test point 2; MANUFACTURER_PART_NUMBER TSW-202-07-T-S; MOUSER PART NUMBER 200-TSW20207TS
TP12, TP18: TP?; PinHeader_1x03_P2.54mm_Vertical
TP13: Vaux; test point 2; MANUFACTURER_PART_NUMBER TSW-202-07-T-S; MOUSER PART NUMBER 200-TSW20207TS
TP14: I''; test point 2; MANUFACTURER_PART_NUMBER TSW-202-07-T-S; MOUSER PART NUMBER 200-TSW20207TS
TP15: I_ac; test point 2; MANUFACTURER_PART_NUMBER TSW-202-07-T-S; MOUSER PART NUMBER 200-TSW20207TS
TP16: V''; test point 2; MANUFACTURER_PART_NUMBER TSW-202-07-T-S; MOUSER PART NUMBER 200-TSW20207TS
TP17: 1L; test point 2; MANUFACTURER_PART_NUMBER TSW-202-07-T-S; MOUSER PART NUMBER 200-TSW20207TS
TP19: V'; test point 2; MANUFACTURER_PART_NUMBER TSW-202-07-T-S; MOUSER PART NUMBER 200-TSW20207TS
TP20: I'; test point 2; MANUFACTURER_PART_NUMBER TSW-202-07-T-S; MOUSER PART NUMBER 200-TSW20207TS
TP21: 2L; test point 2; MANUFACTURER_PART_NUMBER TSW-202-07-T-S; MOUSER PART NUMBER 200-TSW20207TS
TP22: 3L; test point 2; MANUFACTURER_PART_NUMBER TSW-202-07-T-S; MOUSER PART NUMBER 200-TSW20207TS
TP23: 4L; test point 2; MANUFACTURER_PART_NUMBER TSW-202-07-T-S; MOUSER PART NUMBER 200-TSW20207TS
TP24: 1H; test point 2; MANUFACTURER_PART_NUMBER TSW-202-07-T-S; MOUSER PART NUMBER 200-TSW20207TS
TP25: 2H; test point 2; MANUFACTURER_PART_NUMBER TSW-202-07-T-S; MOUSER PART NUMBER 200-TSW20207TS
TP26: 3H; test point 2; MANUFACTURER_PART_NUMBER TSW-202-07-T-S; MOUSER PART NUMBER 200-TSW20207TS
TP27: 4H; test point 2; MANUFACTURER_PART_NUMBER TSW-202-07-T-S; MOUSER PART NUMBER 200-TSW20207TS
Tr1: Transformer; B66362X1014T001; MANUFACTURER_PART_NUMBER MLZ2012N100LT000; MOUSER PART NUMBER 810-MLZ2012N100LT000
Z1: 1N4750A-TR; DIOAD1310W86L370D235; MANUFACTURER_PART_NUMBER 1N4750A-TR; MOUSER PART NUMBER 78-1N4750A

Connections:
3V3pri: C9.2, C10.2, C_vdd5.2, C_vdd7.2, C_vdd9.2, C_vdd10.2, D4.1 (K), IC6.1 (V_S), IC9.1 (V_S), IC10.1 (V_S), IC12.7 (VDD), IC14.2 (OUTPUT), IC14.4 (VOUT), LED7.2 (A), R3.2, R4.2, R10.2, R11.2, R14.2, TP18.2
3V3sec: C12.2, C13.2, C_vdd6.2, C_vdd8.2, D5.1 (K), IC11.1 (V_S), IC13.7 (VDD), IC15.2 (OUTPUT), IC15.4 (VOUT), LED8.2 (A), TP12.2
12Vpri: C4.2, C5.2, C8.2, C_vdd1.2, C_vdd2.2, IC1.1 (VDD), IC2.1 (VDD), IC14.3 (INPUT), LED3.2 (A), PS1.3 (VOUT), R21.2, R22.2, TP18.1
12Vsec: C6.2, C11.2, C_vdd3.2, C_vdd4.2, IC3.1 (VDD), IC4.1 (VDD), IC5.1 (OUTPUT), IC15.3 (INPUT), LED2.2 (A), R23.2, R24.2, TP12.1
/ADCA0: C19.2, J3.5, R20.2
/ADCA1: C17.2, J3.7, R16.1
/ADCA2: C18.2, J3.9, R19.2
/ADCA3: C16.2, J3.11, R15.1
/ADCA4: J3.13
/ADCA5: J3.15
/CS1_ISO: J3.8, R7.2
/CS2_ISO: J3.10, R8.2
/ECAP2_ISO: D2.1 (K), D3.1 (K), J3.6, R12.2, TP15.1
/ECAP5_ISO: J3.19
/GPIO14_ISO: J3.3
/GPIO15_ISO: J3.4, R2.2
/GPIO16_ISO: J3.17
/I': IC10.2 (OUT), R15.2, TP20.1
/I'': IC11.2 (OUT), R16.2, TP14.1
/PWM1A_ISO: J3.21, Rli1.2, TP17.1
/PWM1B_ISO: J3.22, Rhi1.2, TP24.1
/PWM2A_ISO: J3.23, Rli2.2, TP21.1
/PWM2B_ISO: J3.24, Rhi2.2, TP25.1
/PWM3A_ISO: J3.25, Rli4.2, TP22.1
/PWM3B_ISO: J3.26, Rhi4.2, TP26.1
/PWM4A_ISO: J3.27, Rli3.2, TP23.1
/PWM4B_ISO: J3.28, Rhi3.2, TP27.1
/PWM5A_ISO: J3.29
/PWM5B_ISO: J3.30
/PWM6A_ISO: J3.31
/PWM6B_ISO: J3.32
/PWMSYNCI_ISO: J3.14
/PWMSYNCO_ISO: J3.12
/SPICLK_ISO: J3.20
/SPIMISO_ISO: J3.18
/SPIMOSI_ISO: J3.16
/V': IC12.6 (VOUT), R17.2, R19.1, TP19.1
/V'': IC13.6 (VOUT), R18.2, R20.1, TP16.1
/ac+: Rfil1.2, Shunt3.2, TP11.1, Tr1.2
/ac-: C_boot1.1, IC2.4 (HS), Q3.3 (S), Q4.2 (D), Rfil2.2, Rgs6.1, Shunt3.1, TP2.1, TP11.2
/prim+: J1.1, Rfil3.2, Rsens1.2, Shunt1.1, TP9.1
/prim-: C1.1 (+), C20.2, C21.2, C22.2, PS1.1 (VIN), Q1.2 (D), Q3.2 (D), R1.2, Rfil5.2, Shunt1.2, TP9.2
/sec+: C2.1 (+), Q5.2 (D), Q7.2 (D), Rfil4.2, Shunt2.1, TP10.1
/sec-: J2.1, Rfil6.2, Rsens2.2, Shunt2.2, TP10.2
/vg1: Q1.1 (G), Rg5.2, Rgs5.2
/vg2: Q2.1 (G), Rg1.1, Rgs1.2, TP5.1
/vg3: Q3.1 (G), Rg6.2, Rgs6.2
/vg4: Q4.1 (G), Rg2.1, Rgs2.2, TP6.1
/vg5: Q5.1 (G), Rg8.2, Rgs8.2
/vg6: Q6.1 (G), Rg4.1, Rgs4.2, TP7.1
/vg7: Q7.1 (G), Rg7.2, Rgs7.2
/vg8: Q8.1 (G), Rg3.1, Rgs3.2, TP8.1
/vs1: C3.1, C_boot2.1, IC1.4 (HS), Q1.3 (S), Q2.2 (D), Rgs5.1, TP1.1
/vs5: C_boot4.1, IC4.4 (HS), Q5.3 (S), Q6.2 (D), Rgs8.1, TP3.1, Tr1.13 (1)
/vs7: C_boot3.1, IC3.4 (HS), Q7.3 (S), Q8.2 (D), Rgs7.1, TP4.1, Tr1.1
GND: C1.2 (-), C2.2 (-), C4.1, C5.1, C6.1, C7.1, C8.1, C9.1, C10.1, C11.1, C12.1, C13.1, C14.1, C15.2, C16.1, C17.1, C18.1, C19.1, C20.1, C21.1, C22.1, C_aux1.1, C_vdd1.1, C_vdd2.1, C_vdd3.1, C_vdd4.1, C_vdd5.1, C_vdd6.1, C_vdd7.1, C_vdd8.1, C_vdd9.1, C_vdd10.1, Chi1.1, Chi2.1, Chi3.1, Chi4.1, Cli1.1, Cli2.1, Cli3.1, Cli4.1, Csens1.1, Csens2.1, D1.4 (K), IC1.7 (VSS), IC2.7 (VSS), IC3.7 (VSS), IC4.7 (VSS), IC5.2 (COMMON_1), IC5.3 (COMMON_2), IC5.6 (COMMON_3), IC5.7 (COMMON_4), IC6.4 (GND), IC9.4 (GND), IC10.4 (GND), IC11.4 (GND), IC12.4 (VSS), IC13.4 (VSS), IC14.1 (ADJ/GND), IC15.1 (ADJ/GND), J1.2, J2.2, J3.33, J3.34, LED1.1 (K), LED4.1 (K), LED6.1 (K), PS1.2 (GND), Q2.3 (S), Q4.3 (S), Q6.3 (S), Q8.3 (S), R1.1, R5.1, R6.1, R9.1, R12.1, R13.1, Rdiv2.1, Rdiv4.1, Rgs1.1, Rgs2.1, Rgs3.1, Rgs4.1, Rsens3.1, Rsens4.1, S1.1, S1.2, TP1.2, TP2.2, TP3.2, TP4.2, TP5.2, TP6.2, TP7.2, TP8.2, TP12.3, TP13.2, TP14.2, TP15.2, TP16.2, TP17.2, TP18.3, TP19.2, TP20.2, TP21.2, TP22.2, TP23.2, TP24.2, TP25.2, TP26.2, TP27.2, Z1.2 (A)
unnamed: C3.2, L1.1
unnamed: C14.2, J3.1
unnamed: C15.1, J3.2
unnamed: D1.2 (AC_1), Tr1.14
unnamed: D1.3 (AC_2), Tr1.10
unnamed: D2.2 (A), IC6.6 (CMP_OUT), LED5.1 (K), R4.1
unnamed: D3.2 (A), IC9.6 (CMP_OUT), LED9.1 (K), R11.1
unnamed: Csens1.2, D4.2 (A), IC12.3 (VIN+), Rsens1.1, Rsens3.2
unnamed: Csens2.2, D5.2 (A), IC13.3 (VIN+), Rsens2.1, Rsens4.2
unnamed: D6.2 (A), R21.1
unnamed: C_boot2.2, D6.1 (K), IC1.2 (HB)
unnamed: D7.2 (A), R22.1
unnamed: C_boot1.2, D7.1 (K), IC2.2 (HB)
unnamed: D8.2 (A), R23.1
unnamed: C_boot4.2, D8.1 (K), IC4.2 (HB)
unnamed: D9.2 (A), R24.1
unnamed: C_boot3.2, D9.1 (K), IC3.2 (HB)
unnamed: Chi1.2, IC1.5 (HI), Rhi1.1
unnamed: IC1.3 (HO), Rg5.1
unnamed: Cli1.2, IC1.6 (LI), Rli1.1
unnamed: IC1.8 (LO), Rg1.2
unnamed: Chi2.2, IC2.5 (HI), Rhi2.1
unnamed: IC2.3 (HO), Rg6.1
unnamed: Cli2.2, IC2.6 (LI), Rli2.1
unnamed: IC2.8 (LO), Rg2.2
unnamed: Chi3.2, IC3.5 (HI), Rhi3.1
unnamed: IC3.3 (HO), Rg7.1
unnamed: Cli3.2, IC3.6 (LI), Rli3.1
unnamed: IC3.8 (LO), Rg3.2
unnamed: Chi4.2, IC4.5 (HI), Rhi4.1
unnamed: IC4.3 (HO), Rg8.1
unnamed: Cli4.2, IC4.6 (LI), Rli4.1
unnamed: IC4.8 (LO), Rg4.2
unnamed: IC6.3 (CMP_IN), Rdiv1.1, Rdiv2.2
unnamed: IC6.2 (OUT), RrtE1.1
unnamed: C_fil1.2, IC6.8 (V_IN+), IC9.7 (V_IN-), Rfil1.1
unnamed: C_fil1.1, IC6.7 (V_IN-), IC9.8 (V_IN+), Rfil2.1
unnamed: IC6.5 (~RESET), IC9.5 (~RESET), R14.1, S1.3, S1.4
unnamed: IC9.3 (CMP_IN), Rdiv3.1, Rdiv4.2
unnamed: IC9.2 (OUT), RrtE2.1
unnamed: C_fil2.2, IC10.8 (V_IN+), Rfil3.1
unnamed: C_fil2.1, IC10.7 (V_IN-), Rfil5.1
unnamed: C_fil3.2, IC11.8 (V_IN+), Rfil4.1
unnamed: C_fil3.1, IC11.7 (V_IN-), Rfil6.1
unnamed: IC12.2 (VIN-), R17.1
unnamed: IC13.2 (VIN-), R18.1
unnamed: L1.2, Tr1.6
unnamed: LED1.2 (A), R2.1
unnamed: LED2.1 (K), R6.2
unnamed: LED3.1 (K), R5.2
unnamed: LED4.2 (A), R7.1
unnamed: LED5.2 (A), R3.1
unnamed: LED6.2 (A), R8.1
unnamed: LED7.1 (K), R9.2
unnamed: LED8.1 (K), R13.2
unnamed: LED9.2 (A), R10.1
unnamed: Rdiv1.2, RrtE1.2
unnamed: Rdiv3.2, RrtE2.2
aux: C7.2, C_aux1.2, D1.1 (A), IC5.8 (INPUT), TP13.1, Z1.1 (K)

Notes on the sheet:
Main output Connector
Gate Driver on the Secondary Side
EE-365 DAB Converter
Group 04
Secondary Sensing Circuit
Power Stage
Primary Auxiliary Power Supply
Primary Sensing Circuit
Gate Driver on the Primary Side
Secondary Auxiliary Power Supply
Test Points
Connector to Controller (Don't Change!)
Inductor Over Current Detection Circuit
LED

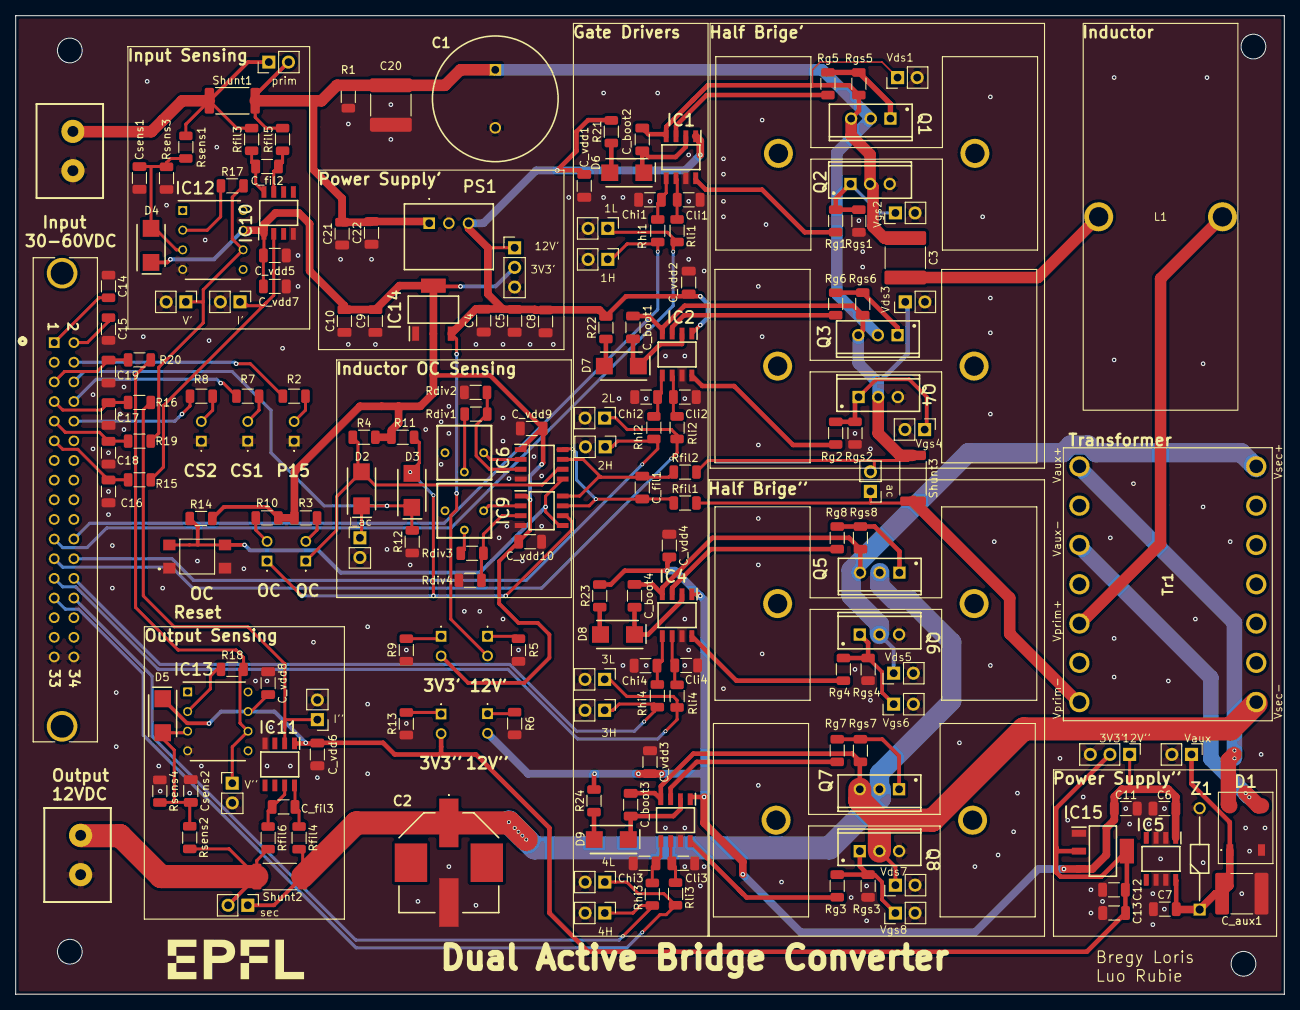
[picture p69: board DAB_converter.kicad_pcb from above]

Board: 2 copper layers, 164.0 x 126.5 mm, 199 parts (0 on the bottom side), 101 nets.
