lbregy/Power-Electronics/(commit log)

2026-03-15 first stage swiching loss
2026-03-17 mosfet singla
2026-04-17 power stage + gate driver schematc
    [DAB_EE365.PcbLib, DAB_EE365.SchLib, DAB_PCB.PcbDoc, DAB_Schematic.SchDoc, DAB_Template4Students.PrjPcb, DAB_Template4Students.kicad_pcb, DAB_Template4Students.kicad_sch]
2026-04-18 power supply and measuremtents schematics
    [DAB_Template4Students.kicad_pcb, DAB_Template4Students.kicad_sch]
2026-04-20 correct input and output capcitors values from rapport1
    [DAB_Template4Students.kicad_sch]
2026-04-21 lined almost every footprint
    [B66362X1014T001.stp, CT-6EP103.stp, DAB_Template4Students.kicad_pcb, DAB_Template4Students.kicad_sch, LMBS-1_MCE.step, WP710A10.STEP, c61036-a0103-c001_ETD34.stp]
2026-04-21 added testpoints
    [DAB_EE365.SchLib, DAB_Template4Students.kicad_pcb, DAB_Template4Students.kicad_sch, FA-T220-25E.stp, MAL215097614E3.stp, SOT78.step, UHW2A681MHD.stp]
2026-05-01 started routing
    [DAB_converter.kicad_pcb, DAB_converter.kicad_sch]
2026-05-01 added all test points
    [DAB_converter.kicad_pcb, DAB_converter.kicad_sch]
2026-05-01 more routing
    [DAB_converter.kicad_pcb]
2026-05-01 gate drivers routed
    [DAB_converter.kicad_pcb]
2026-05-03 DRC passed
    [DAB_converter.kicad_pcb]
2026-05-03 cleaned up silkscreen
    [DAB_converter.kicad_pcb, DAB_converter.kicad_sch]
2026-05-04 added ground vias
    [DAB_converter.kicad_pcb]
