lbregy/Power-Electronics/(notices)

Notices in the files:
03 - PCB/DAB_PCB/DAB_lib/3d/CT-6EP103.stp:
author */ ('License CC BY-ND 4.0'),
